ETML-ES-SLO/PRJ_1811_Ticketing-/doc/1811_C/1811C Système de ticketing pour questions d’étudiants.odp

## 1811C Système de ticketing pour questions d’étudiants

Dos Santos Mario

## Table des matières

- Cahier des charges
- Schématique
- Routage
- Firmware
- Software
- Fonctionnement final
- Conclusion
- Démonstration
- Questions

## Cahier des charges

- Reprise de projet
- Communication USB
- Application C#

## Schématique

- Reprise du schéma version A

## Schématique

- Correction

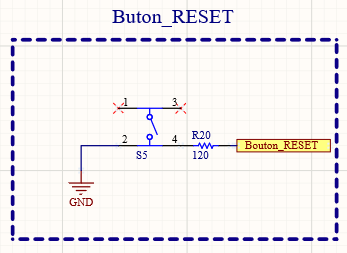
[picture p31: figure]
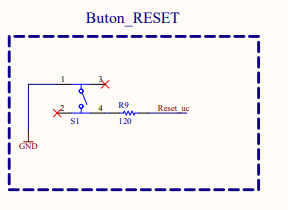
[picture p32: figure]

## Schématique

- Correction

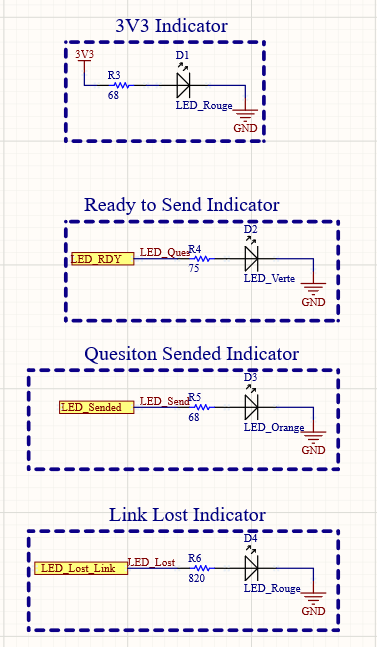
[picture p33: figure]
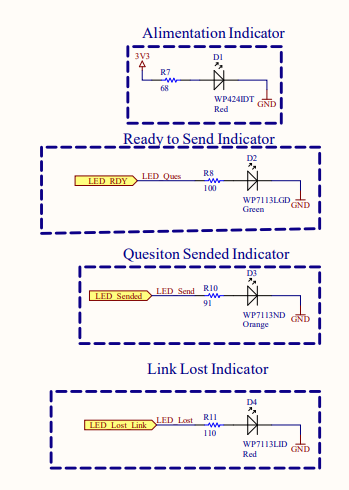
[picture p34: figure]

## Schématique

- Ajout de la communication USB
  - Projet 2126

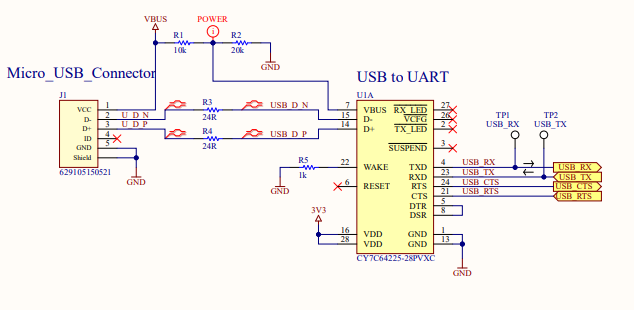
[picture p35: figure]

## Routage

- Taille de PCB
- Emplacement UI
- Plan de masse

## Firmware

- UART


UART USB Slave


UART USB Master

UART Xbee

## Firmware

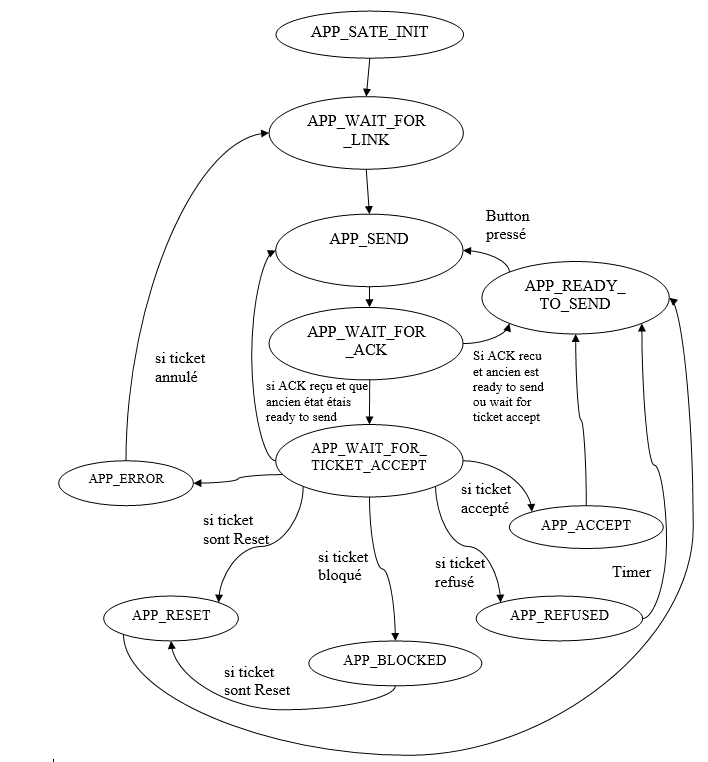
[picture p36: figure]

## Firmware


## Software


## Fonctionnement final

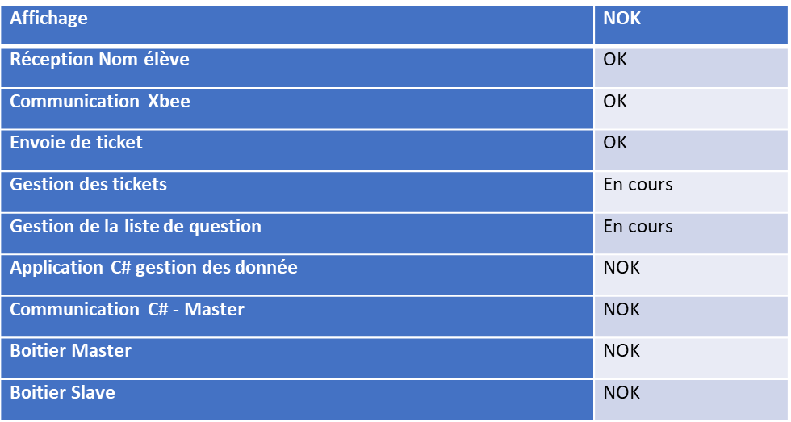
[picture p37: figure]

Affichage | NOK
Réception Nom élève | OK
Communication Xbee | OK
Envoie de ticket | OK
Gestion des tickets | En cours
Gestion de la liste de question | En cours
Application C# gestion des donnée | NOK
Communication C# - Master | NOK
Boitier Master | NOK
Boitier Slave | NOK

## Conclusion

- Hardware
- Firmware
- Software

## Démonstration

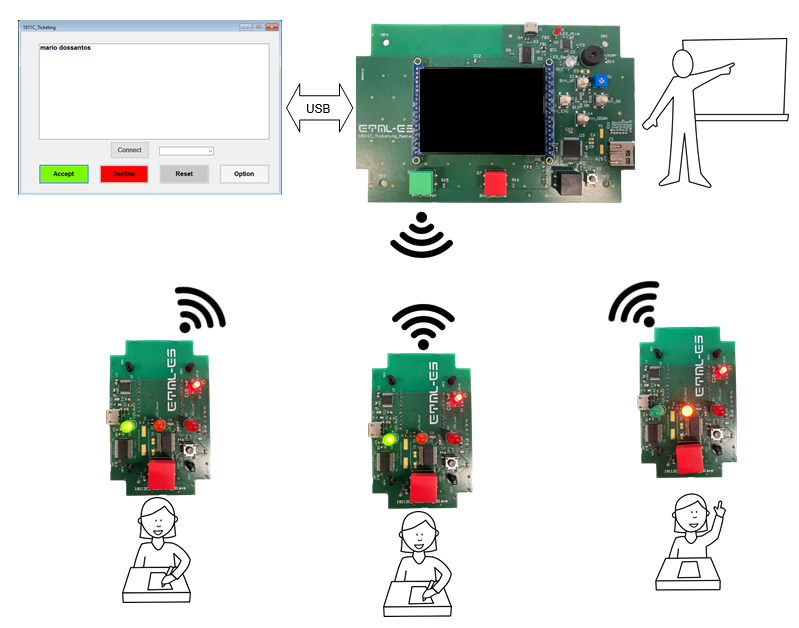
[picture p38: figure]

## Slide 16

- Questions ?
