ETML-ES-SLO/PRJ_1811_Ticketing-/doc/1811_A_B/Rapports/Rapport projet 1811.pdf

ETML | 1811 - Ticketing | Diplôme SLO
Martins David | Page 1-1

# Ticketing

# N° Projet 1811

# Réalisé par: Martins David

Martins David | Page 1-2

Table des matières :

Ticketing | 1-1
N° Projet 1811 | 1-1
Réalisé par: Martins David | 1-1
1 Cahier des charges | 1-4
1.1 Description du projet | 1-4
1.2 Cahier des charges | 1-5
2 Pré-étude | 2-6
2.1 Planning | 2-6
2.2 Schémas bloc | 2-6
2.2.1 Schéma bloc module esclave | 2-6
2.2.2 Schéma bloc module maitre | 2-7
2.2.3 Schéma bloc Module RF | 2-7
2.3 Choix des composants | 2-8
2.3.1 Module maitre | 2-8
2.3.1.1 LCD | 2-8
2.3.1.2 Interface utilisateur | 2-8
2.3.1.3 Boitier | 2-8
2.3.1.4 Microcontrôleur | 2-9
2.3.2 Module esclave | 2-9
2.3.2.1 Interface utilisateur | 2-9
2.3.2.2 Boitier | 2-9
2.3.2.3 Microcontrôleur | 2-9
3 Design | 3-10
3.1 Module maitre | 3-10
3.1.1 Microcontrôleur | 3-10
Microcontrôleur: PIC32MX170F256D | 3-10
3.1.2 TFT | 3-11
3.1.3 SD | 3-11
3.1.4 Alimentation 3.3V | 3-12
3.1.5 Interface utilisateur | 3-12
3.1.6 XBee | 3-13
3.1.7 Circuit de reset | 3-13
3.2 Module esclave | 3-14
3.2.1 Microcontrôleur | 3-14
Microcontrôleur: PIC32MX130F064 | 3-14
3.2.2 Alimentation 3.3V | 3-14
3.2.3 Interface utilisateur | 3-15
3.2.4 XBee | 3-15
3.3 Analyse du module RF | 3-16
3.3.1 Microcontrôleur | 3-16
3.3.2 nRF905 | 3-17
3.4 Boitiers | 3-18
3.4.1 Boiter Maitre | 3-18
3.4.1.1 Idée du design | 3-18
3.4.1.2 Création | 3-18
3.4.1.2.1 Top | 3-19
3.4.1.2.2 Bot | 3-20
3.4.1.2.3 Assemblage | 3-21

Martins David | Page 1-3
3.4.2 Boitier Esclave | 3-22
3.4.2.1 Idée du design | 3-22
3.4.2.1.1 Top | 3-22
3.4.2.1.2 Bot | 3-23
3.4.2.1.3 Assemblage | 3-23
3.5 PCB | 3-24
3.5.1.1 Contraintes | 3-24
3.5.1.2 Vue TOP | 3-24
3.5.1.3 Vue BOT | 3-24
3.5.1.4 Vue TOP | 3-25
3.5.1.5 Vue BOT | 3-25
3.6 Montage et Mise en Service | 3-26
4 Programme | 4-26
4.1 Programme module RF | 4-26
4.1.1 Configuration | 4-26
4.1.2 Diagramme des états | 4-28
4.1.3 Configuration du nRF904 | 4-29
4.1.4 Traitement des informations | 4-30
4.2 Programme Esclave | 4-30
4.2.1 Configuration UART | 4-30
4.2.2 Configuration Fréquence système | 4-30
4.2.3 Diagramme | 4-31
4.3 Programme Maitre | 4-32
4.3.1 Configuration SPI | 4-32
4.3.2 Configuration Carte SD | 4-32
4.3.3 UART | 4-32
4.3.4 Diagramme system task | 4-33
4.3.5 APP_TASK | 4-33
4.3.6 Gest_Menu | 4-33
4.3.7 Gest_Menu | 4-34
4.3.8 APP_SD_CARD_TASK | 4-35
4.3.9 Ecran TFT | 4-36
5 Corrections | 5-37
5.1 Module XBee | 5-37
5.2 Bouton Reset | 5-37
5.3 Alimentation de la carte SD | 5-37
6 Validation selon cahier des charges | 6-38
7 Comparaison des plannings | 7-39
8 Conclusion | 8-39

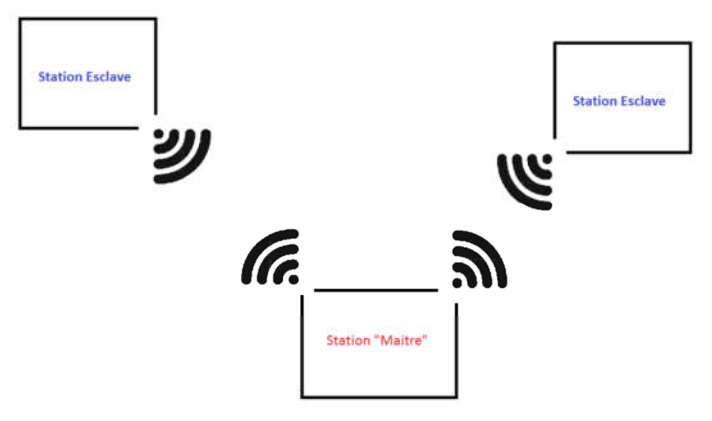
[picture p39: figure]

Martins David | Page 1-4

# 1 Cahier des charges

## 1.1 Description du projet

Ce travail de diplôme fait suite à la demande des étudiants de première année SLO (2017/2018). Avoir un système de ticketing électronique qui permettra aux enseignants de mieux gérer les demandes des étudiants lors des cours ou travaux pratiques.

Le système de ticketing sera sans-fil et pour ce faire il faudra utiliser les modules RFs développé à l'ES (Projet ES 1623). Il faudra donc fournir au minimum 2 modules esclaves (pour les élèves) et 1 module maitre (pour les enseignants).

Tâches de l'esclave:
- Envoi de ticket.
- Affichage de l'état du module (Prêt à envoyer, attente, bloqué, non connecté).
- Annulation de ticket.

Tâches du maitre:
- Récupération des infos des étudiants dans la carte SD.
- Affichage de la liste des tickets en attentes.
- Accepter un ticket, le refuser, ou tous les resets.
- Via un menu, configurer la limite de questions par élèves.

Martins David | Page 1-5

## 1.2 Cahier des charges

- Station "Maitre" comprenant:
- Un boitier
- Un afficheur LCD minimum 4 lignes 20 colonnes
- Boutons de commande (à impulsion ou rotatif) - doit permettre de sélectionner des menus ou valider des tickets
- Alimentation 5V via µ-USB.
- Emplacement pour module sans-fil -> voir projet 1623
- Prévoir une carte SD (pour pré-configuration future, par exemple appairage des stations esclaves avec la station maitre)
- Firmware du microcontrôleur principal maitre
- Appairage des différents modules esclaves
- Gestion des tickets (nombres par modules / validation des tickets)
- Remise à zéro de tous les tickets
- Station Esclave (minimum 2 à monter) comprenant:
- Un boitier
- Boutons poussoir pour l'envoi du ticket
- Système lumineux - 3 couleurs
Rouge => bloqué, pas d'envoi possible (limite atteinte) => Clignotement: pas de lien RF
Orange => envoi possible de ticket, ticket en cours. Vert => envoi possible de ticket, aucun en cours.
- Alimentation 5V via via µ-USB.
- Emplacement pour module sans-fil -> voir projet 1623
- Firmware du microcontrôleur principal esclave
- Envoi de ticket
- Gestion des signaux lumineux
- Firmware du module RF à mettre au point (HW fourni, FW existant Beugé)

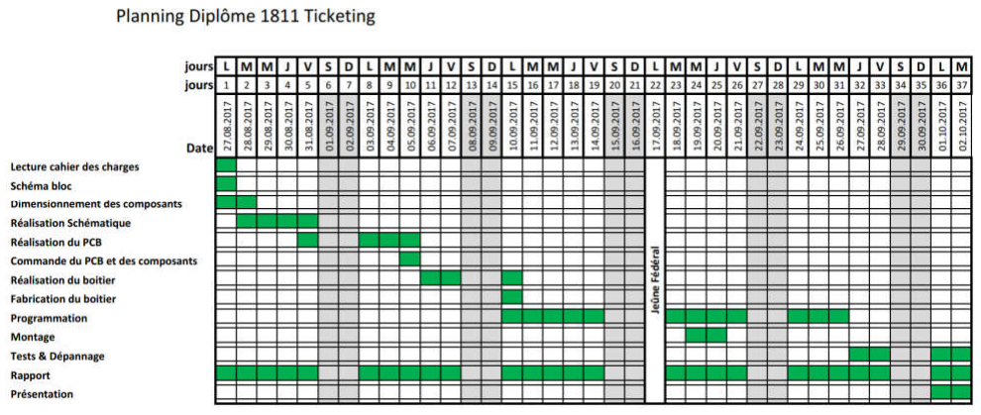
[picture p40: figure]

Martins David | Page 2-6

# 2 Pré-étude

## 2.1 Planning

Remarque: en conclusion nous retrouverons ce planning, comparé au planning réel.

## 2.2 Schémas bloc

### 2.2.1 Schéma bloc module esclave

Ici nous pouvons voir que mon module esclave va nécessiter d'utiliser uniquement 1 Bus UART. Nous avons 1 entrée sur le microcontrôleur qui sera dédié au bouton d'envoi de ticket et nous aurons 3 sorties pour les 3 LEDs d'états.

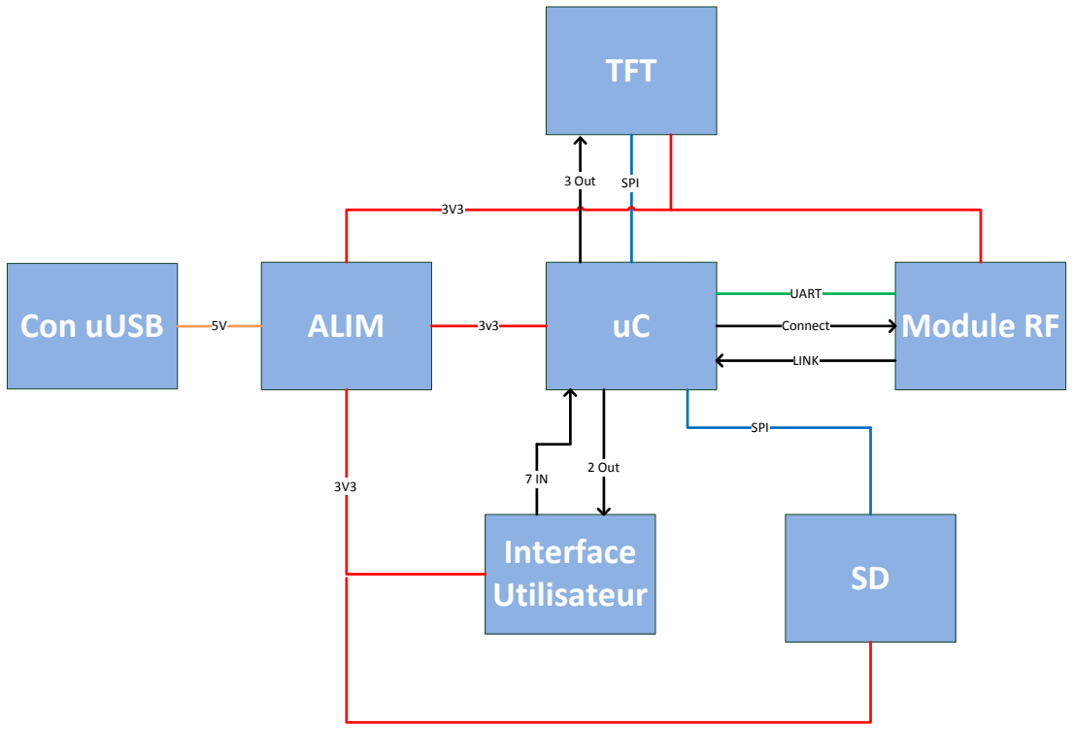
[picture p41: figure]
Con uUSB; ALIM; Module RF; TFT; Interface Utilisateur; SPI; UART; 2 Out; Connect; LINK; 3 Out

Martins David | Page 2-7

### 2.2.2 Schéma bloc module maitre

Pour le module maitre nous aurons besoin de : 2 bus SPI (SD et écran TFT)
1 bus UART
7 entrées pour les boutons de commandes
2 sorties pour le pilotage d'un buzzer et d'une LED

### 2.2.3 Schéma bloc Module RF

Remarque: je n'ai pas designé cette carte, cependant pour produire un code il faut en connaitre la construction.

Martins David | Page 2-8

Nous voyons donc que le module RF utilise un nRF905. Ce dernier est piloté via SPI et possède 3 pins de commandes ainsi que 3 pins d'indication de statuts.

Une mémoire pilotée par I2C nous permet d'y stocker l'ID du module (son adresse RF).

Le contrôle du module se fera via UART.

## 2.3 Choix des composants

### 2.3.1 Module maitre

2.3.1.1 LCD
Décision portée sur un module TFT de chez adafruit:
- Alimentation 5V ou 3V3
- Communication SPI
- Dimension de 240x340 pixels pour 2.8" de diagonale
- Utilisé dans projet de semestre

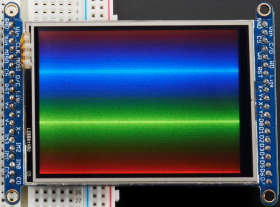
[picture p42: figure]

2.3.1.2 Interface utilisateur
Décision d'utiliser un buzzer:
- Sonne à la réception d'un nouveau ticket
- Fréquence de 440Hz
- Couplé à un trimer permettant d'en régler le volume

LED Orange:
- Boitier 5mm, pour qu'elle puisse ressortir du boitier.

Boutons:
- 3 boutons principaux colorés
- Vert ticket accepté
- Rouge ticket refusé
- Noir tous les tickets sont reset
- 4 boutons
- 4 boutons pour le control de menu

2.3.1.3 Boitier
Le boitier sera fait à l'ES grâce à l'imprimante 3D.

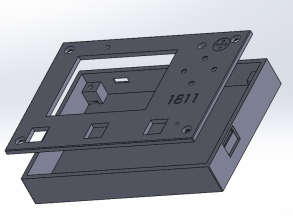
[picture p43: figure]

Martins David | Page 2-9

2.3.1.4 Microcontrôleur

Besoins:
- 2 Ports SPI (Carte SD et écran TFT)
- Port UART (Module RF)
- 15 GPIO
- Alimentation 3V3
- Mémoire minimum de 126kB

Décision portée sur le PIC32MX170F256 en boitier TQFP 44 pattes.

### 2.3.2 Module esclave

2.3.2.1 Interface utilisateur
LEDs:
- 3 Leds de couleurs différentes
- Verte, indique que le module est prêt à l'envoi d'un ticket.
- Orange, indique état d'attente de réponse.
- Rouge, ticket refusé ou module non linké.
- Boitier 5 mm pour qu'elles puissent dépasser du boitier
- Décision de prendre 3 LED pour être plus userfriendly, 3 LED alignées verte, orange et rouge expliquent instinctivement leurs utilités.

Bouton:
- Un bouton rouge pour l'envoi de ticket et l'annulation (maintient)

2.3.2.2 Boitier

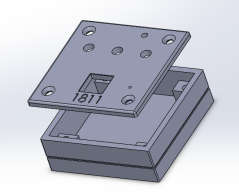
[picture p44: figure]

Le boitier sera fait à l'ES grâce à l'imprimante 3D.

2.3.2.3 Microcontrôleur

Besoins:
- Port UART (Module RF)
- 6 GPIO
- Alimentation 3V3
- Mémoire moins de 126kB

Décision portée sur le PIC32MX130F64 en boitier QFN 28 pattes.

# 3 Design

## 3.1 Module maitre

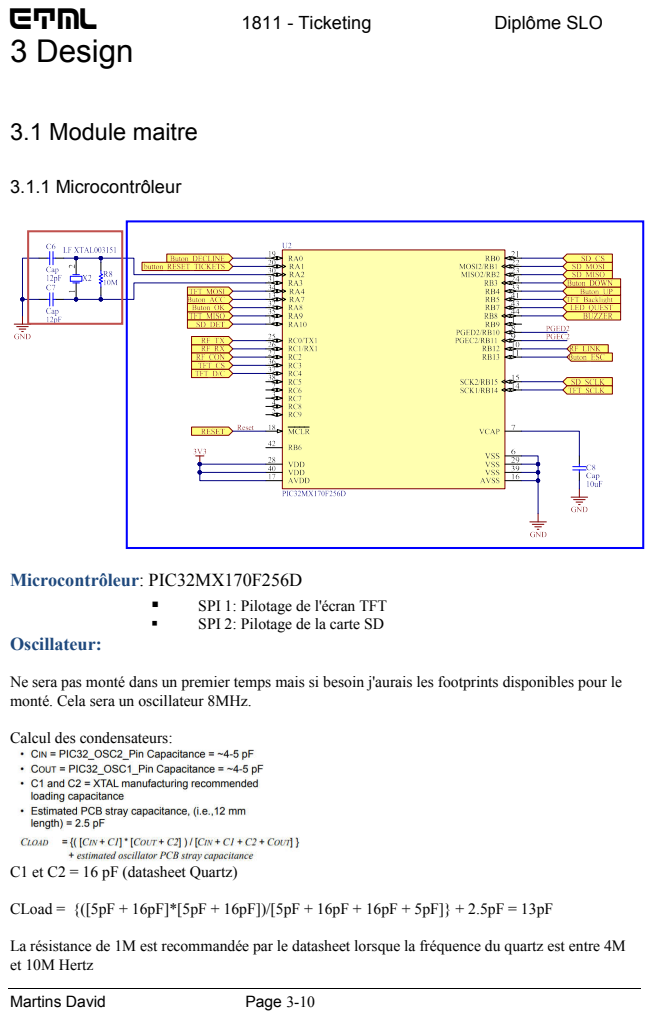
[picture p45: page 10]
Martins David; Page 3-10; 3.1.1 Microcontrôleur; Microcontrôleur: PIC32MX170F256D; Oscillateur:; CLoad = {([5pF + 16pF]*[5pF + 16pF])/[5pF + 16pF + 16pF + 5pF]} + 2.5pF = 13pF

▪ SPI 1: Pilotage de l'écran TFT
▪ SPI 2: Pilotage de la carte SD

Ne sera pas monté dans un premier temps mais si besoin j'aurais les footprints disponibles pour le
monté. Cela sera un oscillateur 8MHz.

Calcul des condensateurs:

C1 et C2 = 16 pF (datasheet Quartz)

La résistance de 1M est recommandée par le datasheet lorsque la fréquence du quartz est entre 4M
et 10M Hertz

### 3.1.2 TFT

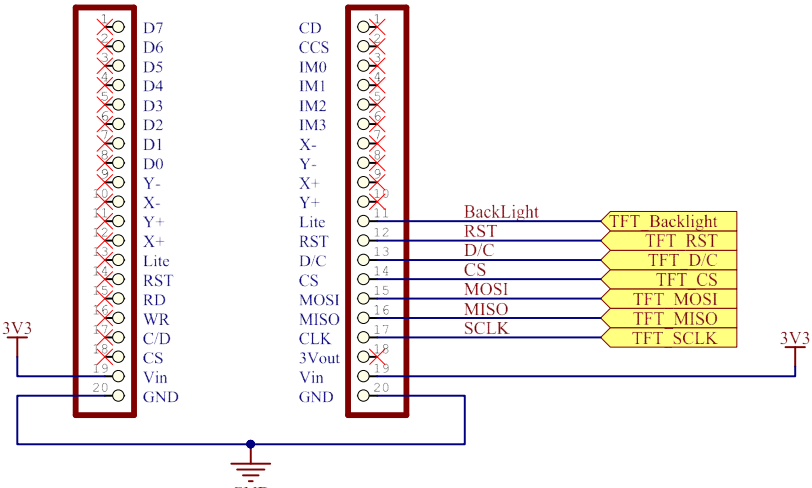
[picture p46: figure]

Ici nous avons le pinning de l'écran TFT. L'écran propose plusieurs possibilité de communication, j'utilise la communication SPI car plus simple et déjà utilisé dans un précédent projet.

"Lite" permettra l'allumage du rétro-éclairage.
"Reset" est liée au reste de la carte.
"D/C" permettra de choisir si l'on envoie des données ou des commandes.

3.1.3 SD

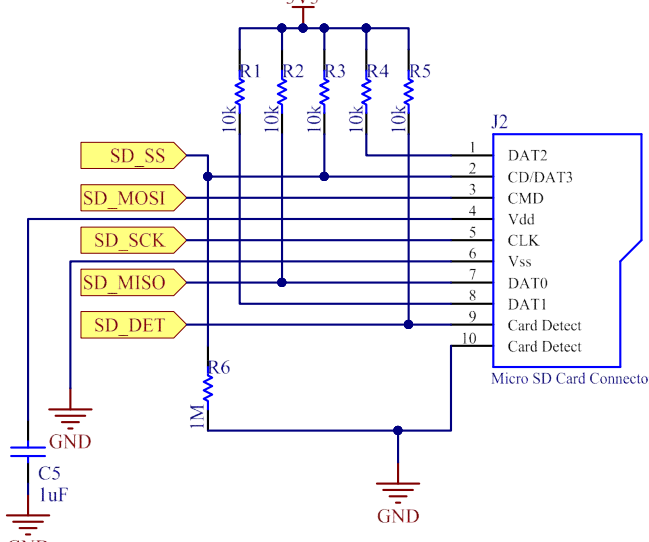
[picture p47: figure]

Ici nous avons le holder de la carte SD, le design est repris du starter-kit ES.

### 3.1.4 Alimentation 3.3V

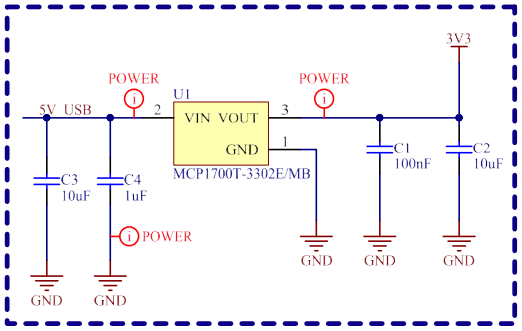
[picture p48: figure]

Pour la gestion de l'alimentation j'ai utilisé leMCP1700T-330 qui est un régulateur de tension linéaire 3V3 volts.

Ce régulateur peut me fournir un courant de 200mA maximum à 3.3V (datasheet).
Le module RF consomme moins de 50 mA (estimation tirée de la documentation du projet 1623) L'écran TFT consomme au maximum 100mA (estimation tirée de la description de l'écran sur le site adafruit)
Ce qui laisse 50mA de consommation pour mon PCB ce qui sera suffisant car mon microcontrôleur consommera 50mA au maximum.

### 3.1.5 Interface utilisateur

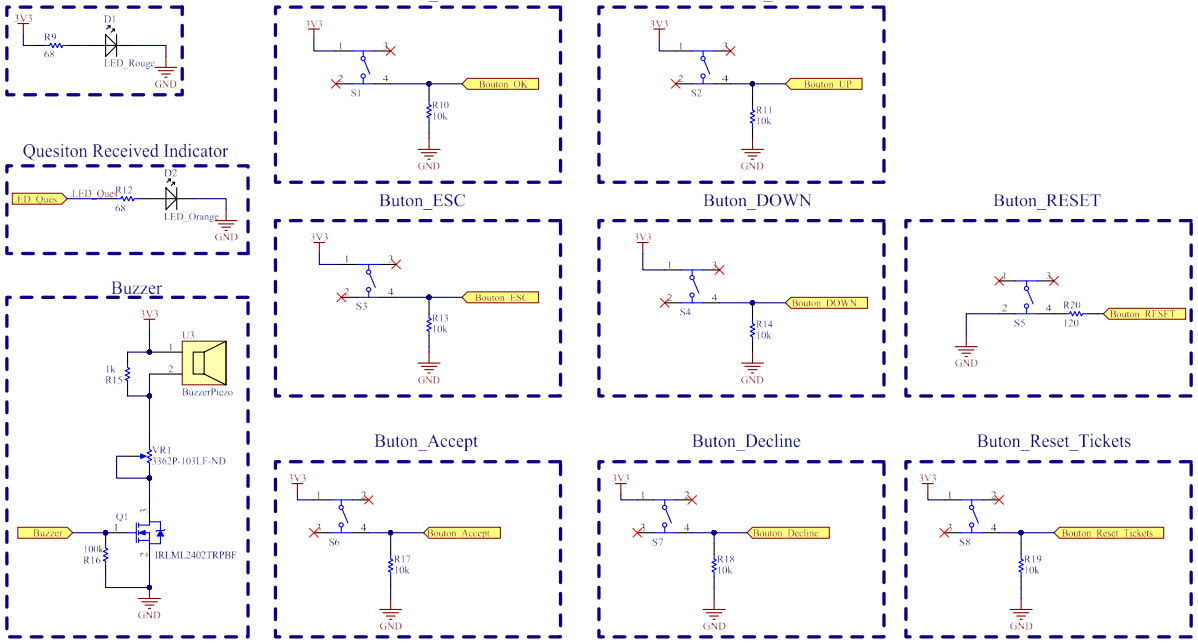
[picture p49: figure]

Led Orange = Led rouge => consommation 20mA pour tension de 2V

RLed = (Vcc - VLed) / ILed = (3.3 - 2) /20m = 65ohm -> E12 -> 68ohm

### 3.1.6 XBee

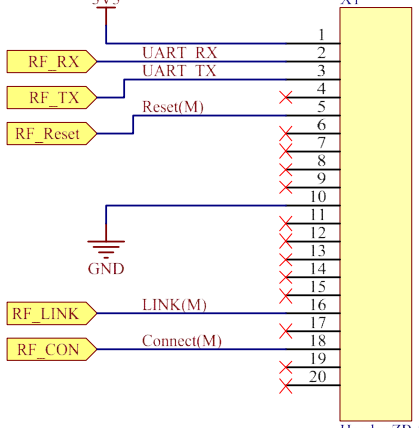
[picture p50: figure]

Ici nous avons le connecteur Xbee, 2 barrettes à broches femelle

Attention: pitch => 2mm

Sa ligne Reset est liée au reste de la carte.
Les lignes "LINK" et "Connect" sont des lignes destinées à être utilisées par de simples GPIO.

### 3.1.7 Circuit de reset

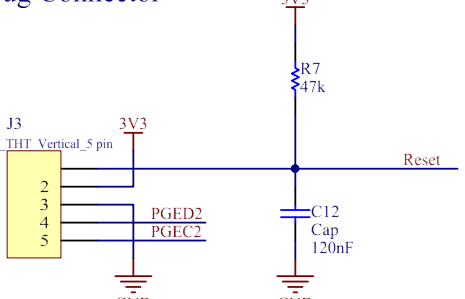
[picture p51: figure]

Ici lors de la mise sous tension le condensateur C12 permettra à la carte de se maintenir en reset pendant minimum 25ms lors de la mise sous tension.

t = R7 * C12 = 47k * 120n = 5.64ms
Pour charger le condensateur à son maximum on estime qu'il faut 5 fois ce temps. 5t = 28.2ms.

## 3.2 Module esclave

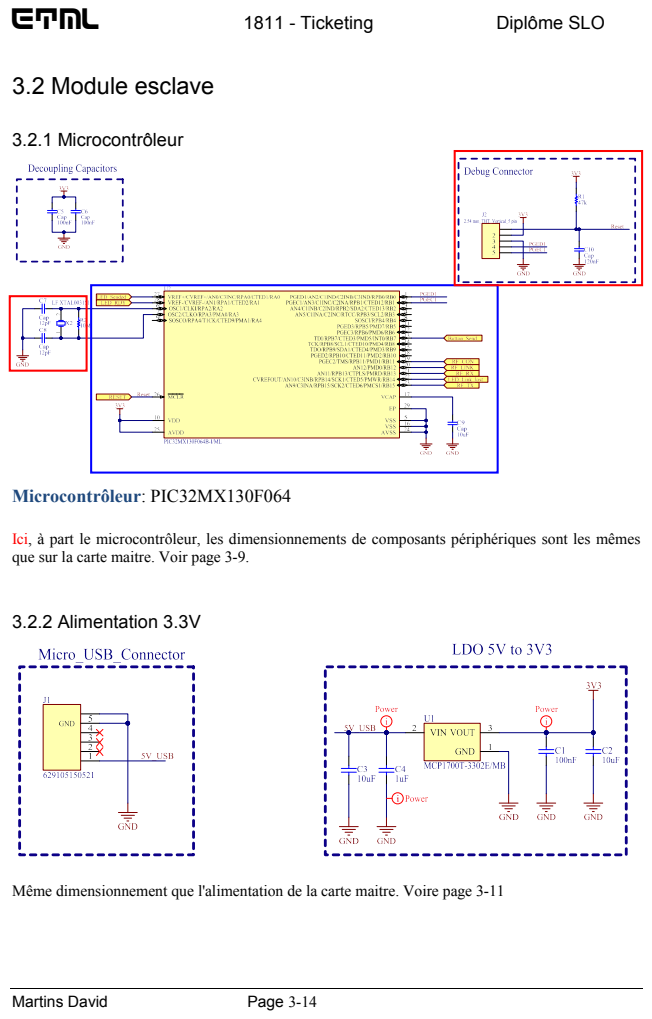
[picture p52: page 14]
3.2.1 Microcontrôleur; Microcontrôleur: PIC32MX130F064; 3.2.2 Alimentation 3.3V

Ici, à part le microcontrôleur, les dimensionnements de composants périphériques sont les mêmes
que sur la carte maitre. Voir page 3-9.

Même dimensionnement que l'alimentation de la carte maitre. Voire page 3-11

### 3.2.3 Interface utilisateur

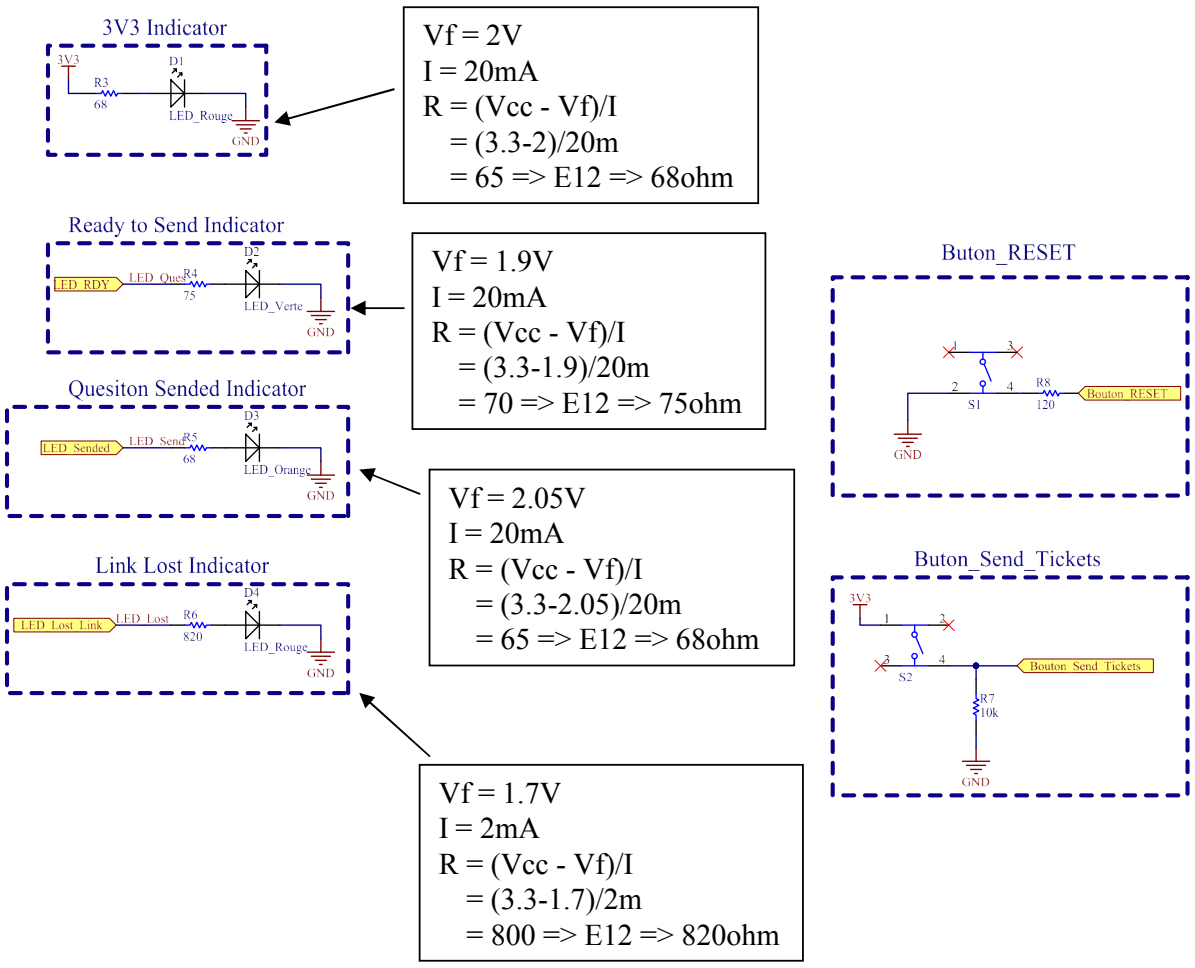
[picture p53: figure]
Vf = 2V I = 20mA R = (Vcc - Vf)/I R = (3.3-2)/20m R = 65 => E12 => 68ohm; Vf = 1.9V I = 20mA R = (Vcc - Vf)/I R = (3.3-1.9)/20m R = 70 => E12 => 75ohm; Vf = 2.05V I = 20mA R = (Vcc - Vf)/I R = (3.3-2.05)/20m R = 65 => E12 => 68ohm; Vf = 1.7V I = 2mA R = (Vcc - Vf)/I R = (3.3-1.7)/2m R = 800 => E12 => 820ohm

### 3.2.4 XBee

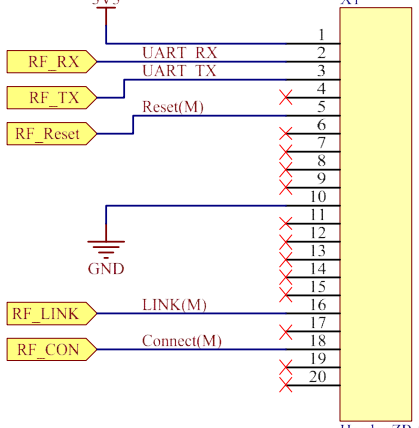
[picture p54: figure]

Même que sur la carte maitre. Voir page 3-12

## 3.3 Analyse du module RF

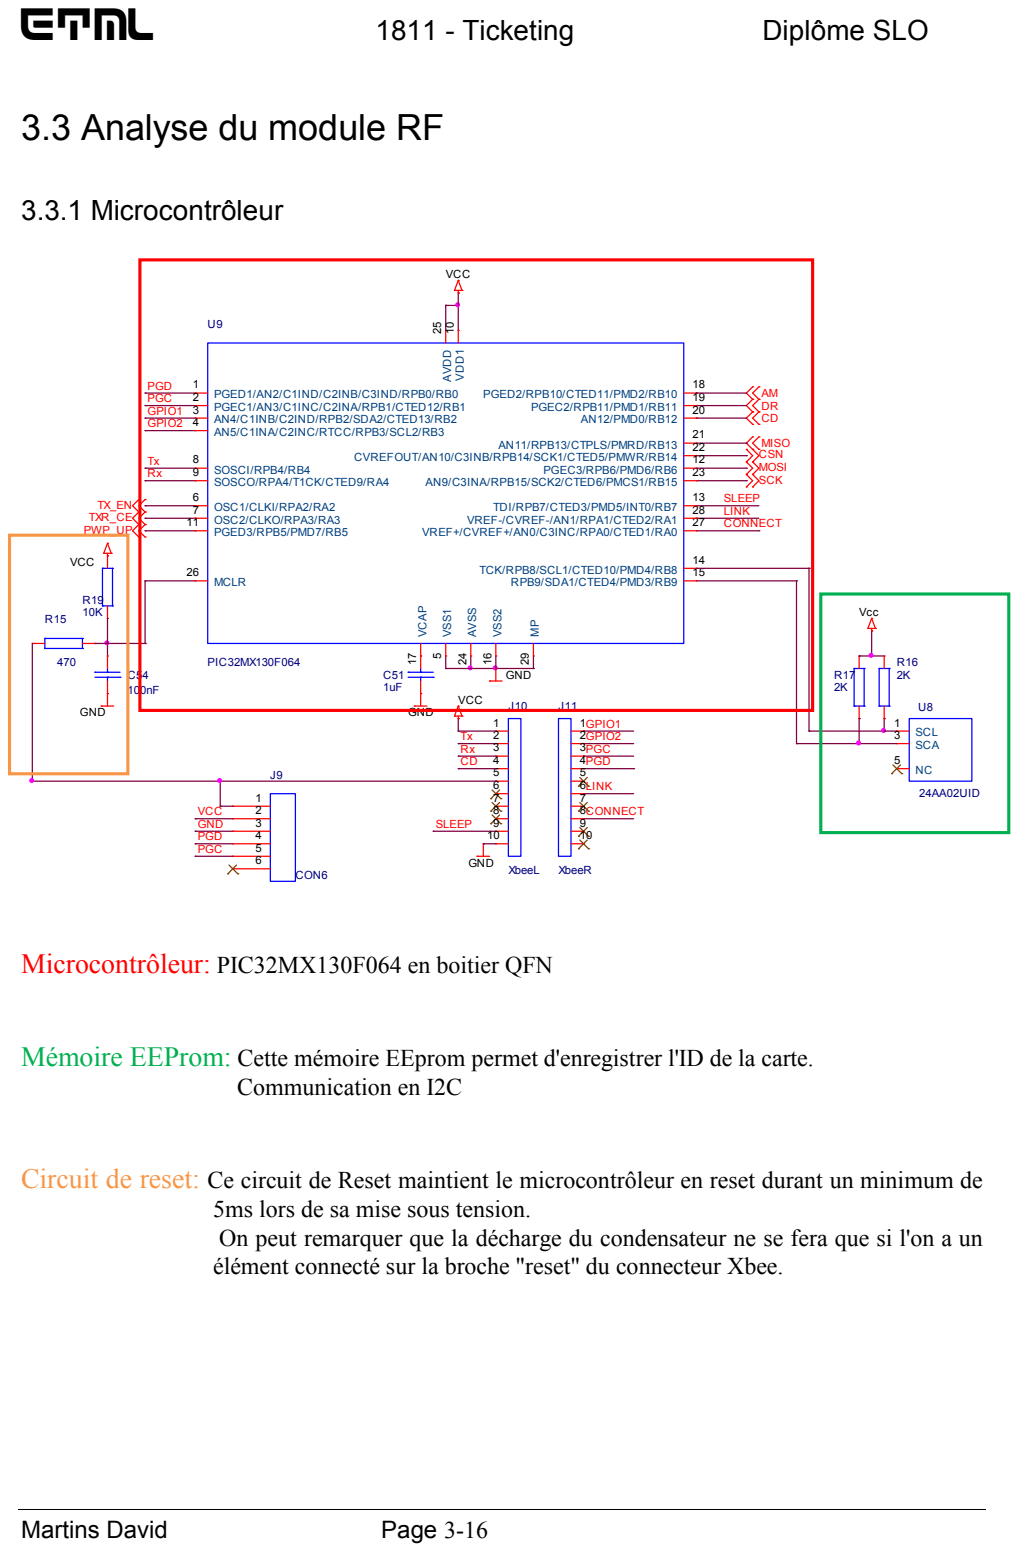
[picture p55: page 16]

Microcontrôleur: PIC32MX130F064 en boitier QFN

Mémoire EEProm: Cette mémoire EEprom permet d'enregistrer l'ID de la carte.

Circuit de reset: Ce circuit de Reset maintient le microcontrôleur en reset durant un minimum de

5ms lors de sa mise sous tension.
On peut remarquer que la décharge du condensateur ne se fera que si l'on a un
élément connecté sur la broche "reset" du connecteur Xbee.

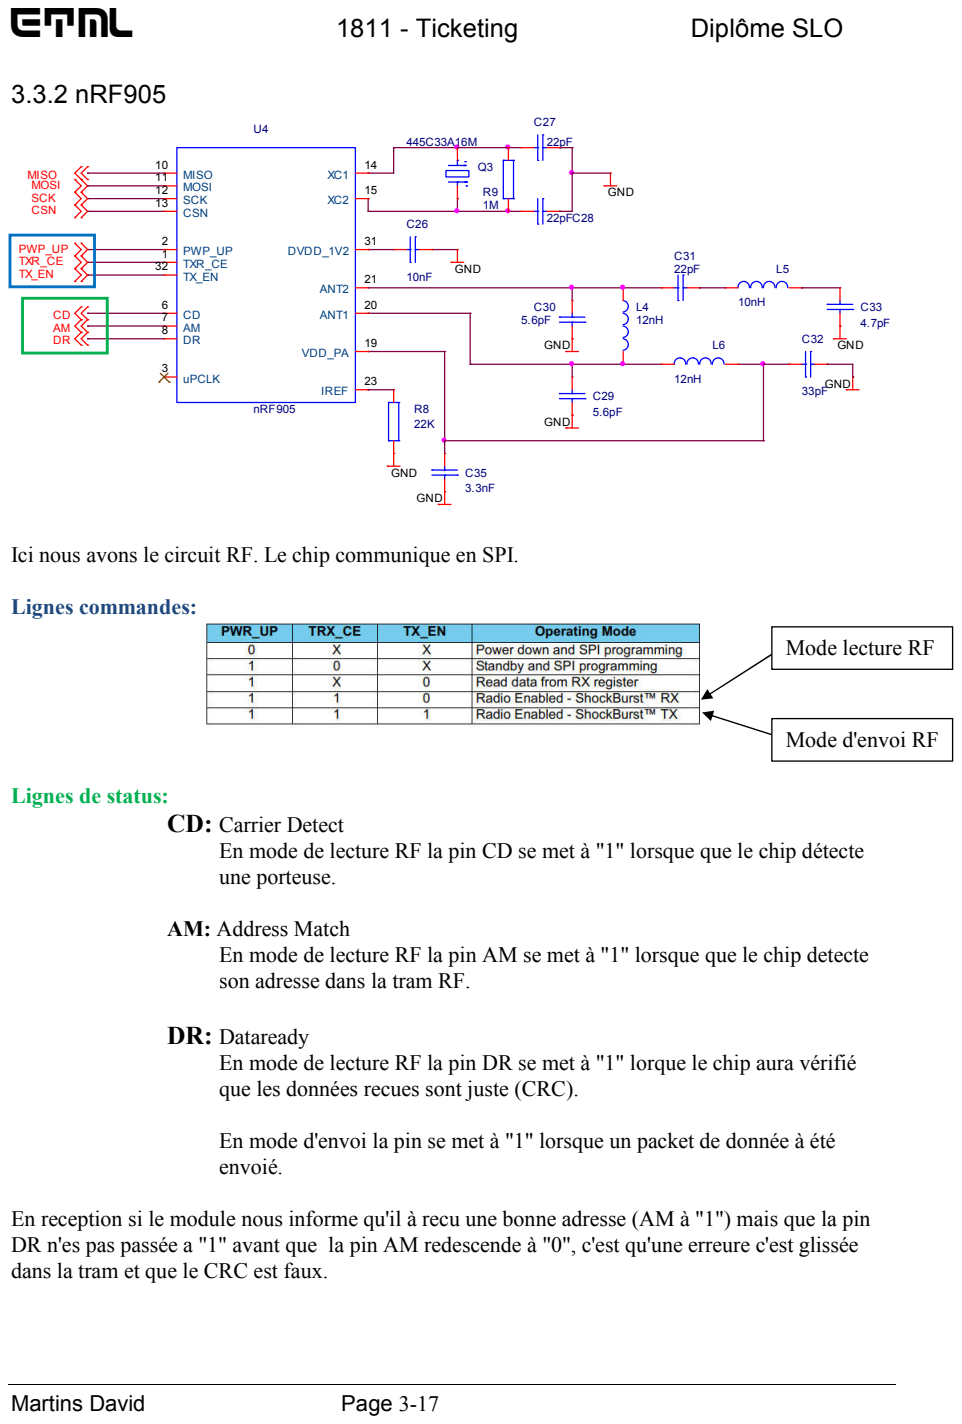
[picture p56: page 17]

Ici nous avons le circuit RF. Le chip communique en SPI.

CD: Carrier Detect
En mode de lecture RF la pin CD se met à "1" lorsque que le chip détecte
une porteuse.

AM: Address Match
En mode de lecture RF la pin AM se met à "1" lorsque que le chip detecte
son adresse dans la tram RF.

DR: Dataready
En mode de lecture RF la pin DR se met à "1" lorque le chip aura vérifié
que les données recues sont juste (CRC).

En mode d'envoi la pin se met à "1" lorsque un packet de donnée à été
envoié.

En reception si le module nous informe qu'il à recu une bonne adresse (AM à "1") mais que la pin
DR n'es pas passée a "1" avant que la pin AM redescende à "0", c'est qu'une erreure c'est glissée
dans la tram et que le CRC est faux.

## 3.4 Boitiers

Contrairement à ce qui était prévu dans le planning, j'ai préféré commencer par un design de boitier avant de créer le PCB afin d'avoir une réalisation plus esthétique, et cela me permettra d'avoir une première version de boitier à tester dès que j'aurais monté le PCB, ce qui me permettra de facilement faire des retouches et envoyer la production des boitiers finaux.

### 3.4.1 Boiter Maitre

3.4.1.1 Idée du design

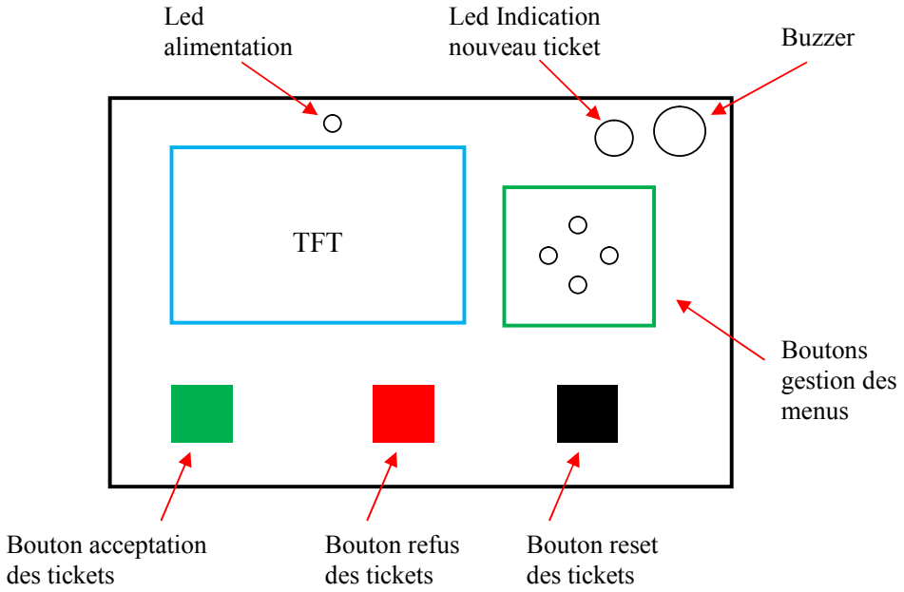
[picture p57: figure]
TFT; Led alimentation; Led Indication; nouveau ticket; Buzzer; Boutons gestion des menus; Bouton reset des tickets; Bouton refus des tickets; Bouton acceptation des tickets

3.4.1.2 Création

Concernant la création du boitier, j'ai pris contact avec M. Muller, qui s'occupe de l'impression 3D à l'ES.

Dans un premier temps il a fallu prendre en compte les éléments suivants:
- L'imprimante a une précision de 0.1 mm
- L'épaisseur des parois du boitier doit être de 3mm minimum pour garantir une certaine solidité.
- Le taraudage du boitier risque de casser le boitier donc à éviter

A propos de la visserie M. Muller m'as conseillé sur une façon simple de procéder:

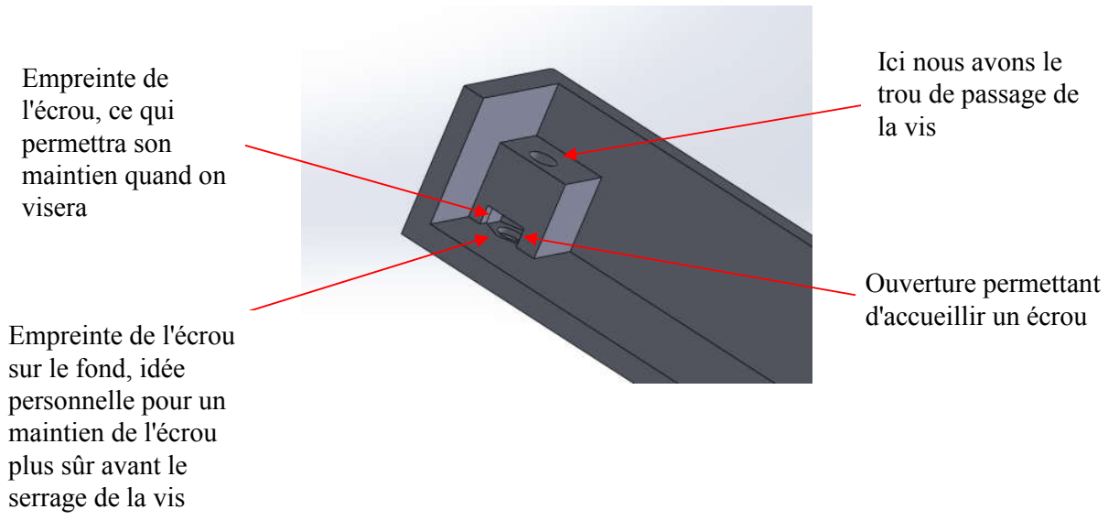
[picture p58: figure]
Ici nous avons le trou de passage de la vis; Ouverture permettant d'accueillir un écrou; Empreinte de l'écrou, ce qui permettra son maintien quand on visera; Empreinte de l'écrou sur le fond, idée personnelle pour un maintien de l'écrou plus sûr avant le serrage de la vis

3.4.1.2.1 Top
Vue du dessus

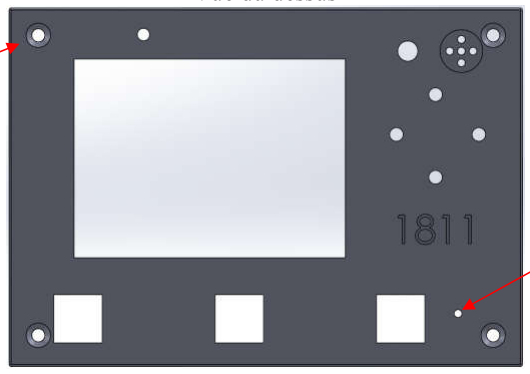
[picture p59: figure]

Trou donnant accès au
bouton de reset

Trou de fixation
pour vis M3 tête
conique

Vue du dessous

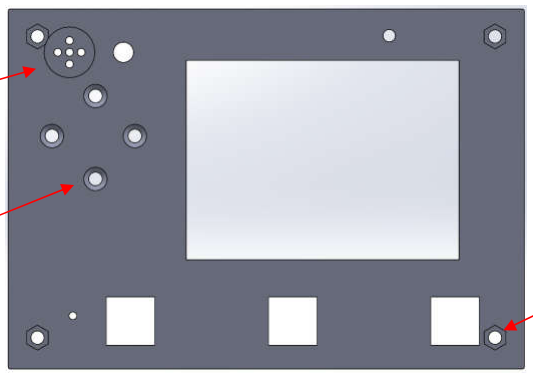
[picture p60: figure]
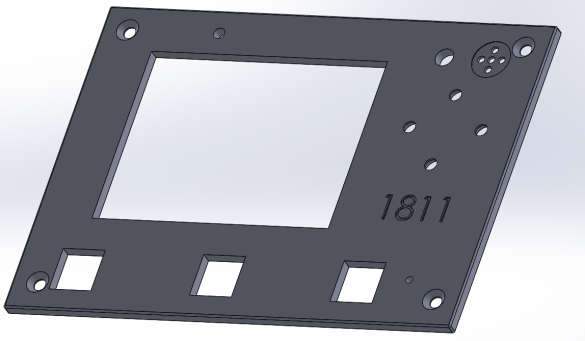
[picture p61: figure]

Vue 3D

3.4.1.2.2 Bot
Vue de derrière

Empreinte du
buzzer pour qu'il
puisse entrer dans
le boitier

Chanfrein pour les
boutons

Empreinte pour
l'entretoise

Découpe du
connecteur µ-USB
Empreinte pour la
gaine du câble USB

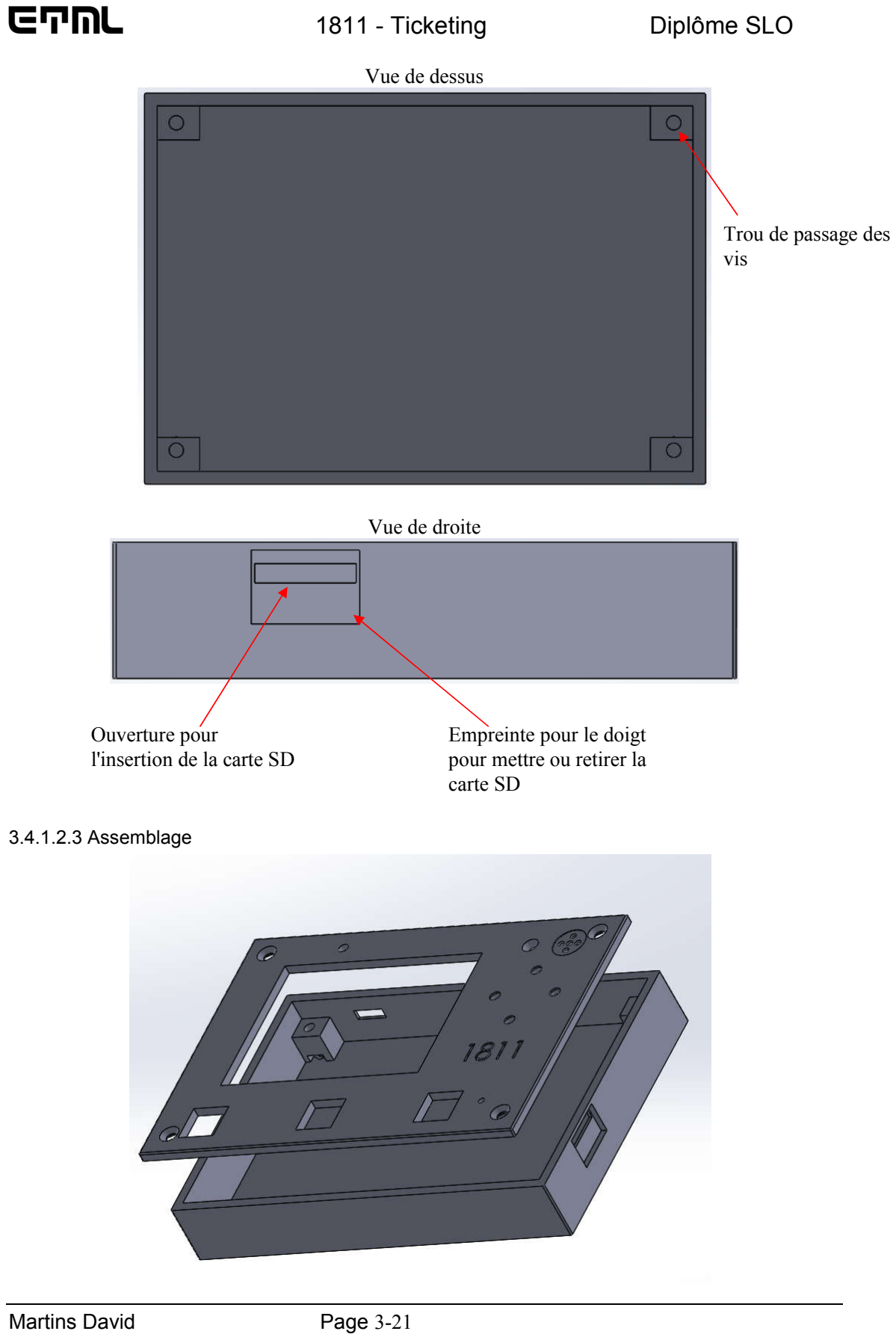
[picture p62: page 21]

Vue de dessus

Vue de droite

3.4.1.2.3 Assemblage

Trou de passage des
vis

Empreinte pour le doigt
pour mettre ou retirer la
carte SD

Ouverture pour
l'insertion de la carte SD

### 3.4.2 Boitier Esclave

3.4.2.1 Idée du design

3.4.2.1.1 Top
Vue dessus

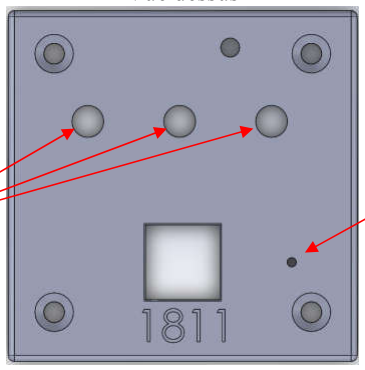
[picture p63: figure]
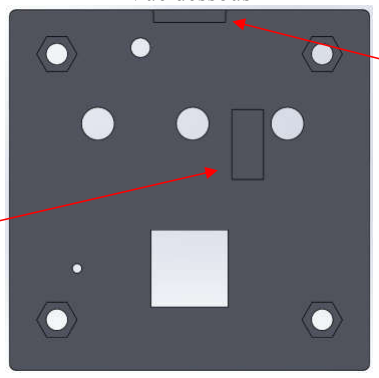
[picture p64: figure]

Vue dessous

Led
alimentation

Led Verte

Bouton envoi
ticket

Led orange

Led rouge

Trou donnant accès au
bouton de reset

Trou LEDs

Empreinte pour le
quartz

Empreinte pour la
gaine du câble USB

Vue 3D

3.4.2.1.2 Bot

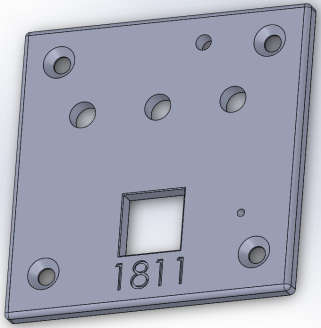
[picture p65: figure]

Vue de derrière

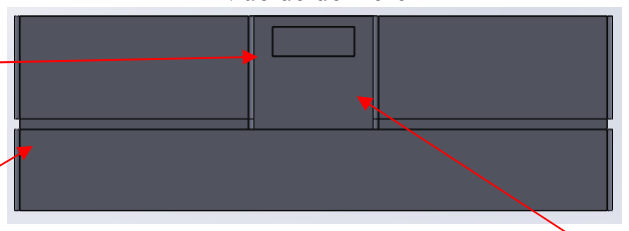
[picture p66: figure]
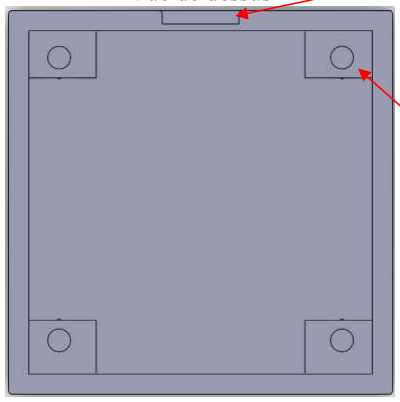
[picture p67: figure]

Vue de dessus

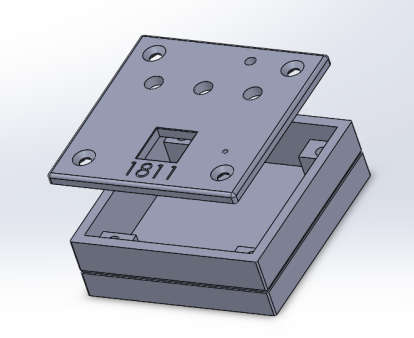
[picture p68: figure]

3.4.2.1.3 Assemblage

Empreinte pour la
gaine du câble USB

Découpe du
connecteur µ-USB

Rainure
esthétique

Trou de passage des
vis

## 3.5 PCB

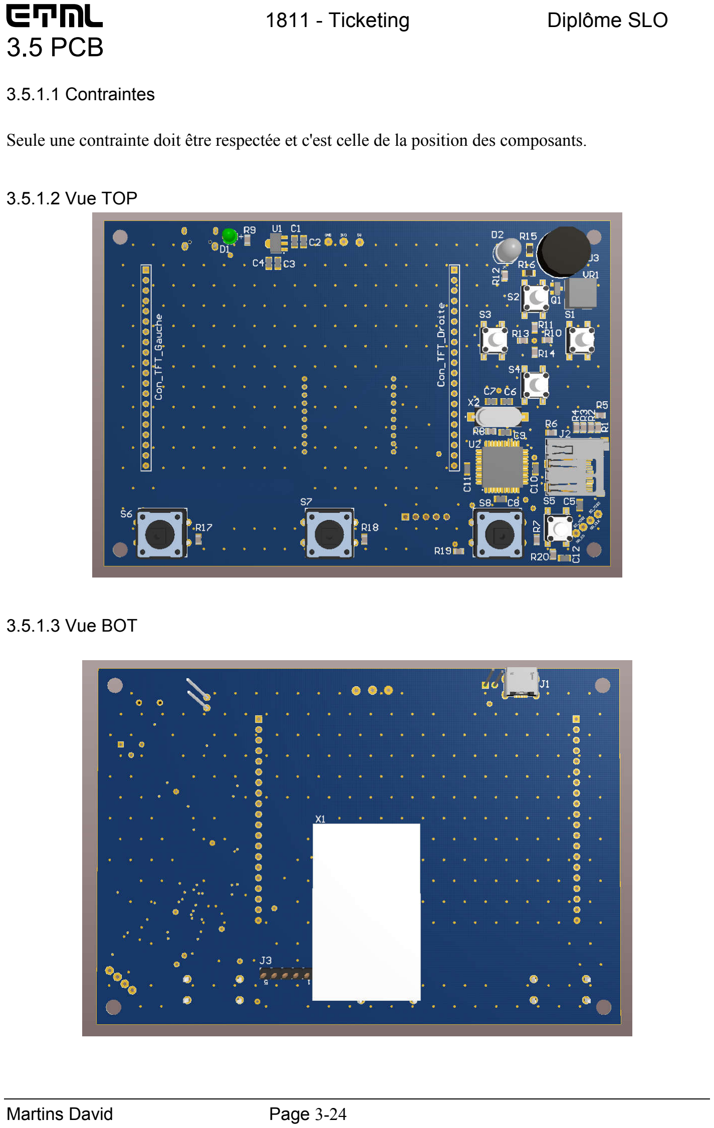
[picture p69: page 24]

3.5.1.1 Contraintes

Seule une contrainte doit être respectée et c'est celle de la position des composants.

3.5.1.2 Vue TOP

3.5.1.3 Vue BOT

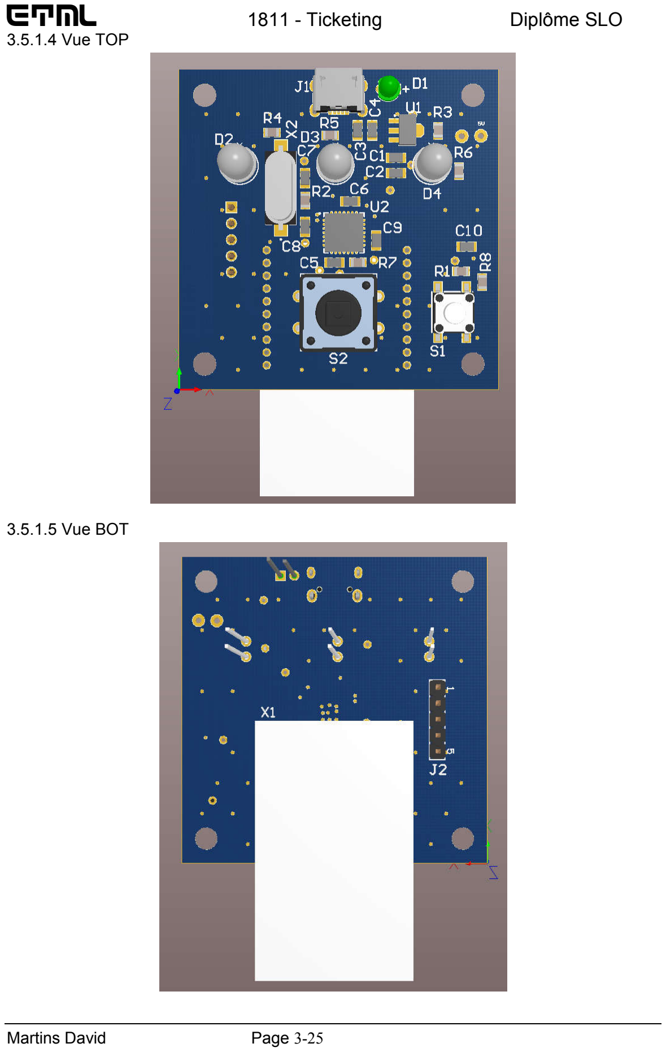
[picture p70: page 25]

3.5.1.4 Vue TOP

3.5.1.5 Vue BOT

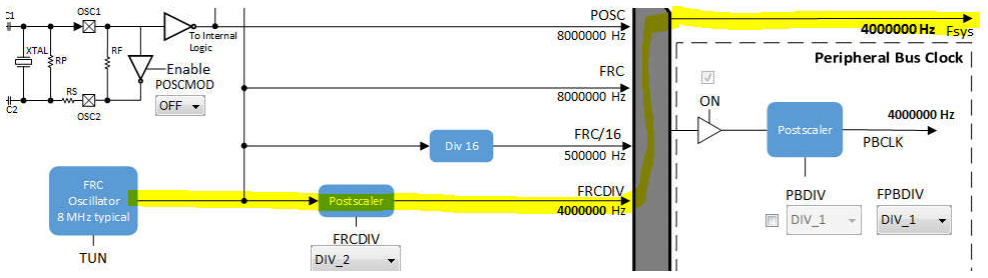
[picture p71: figure]
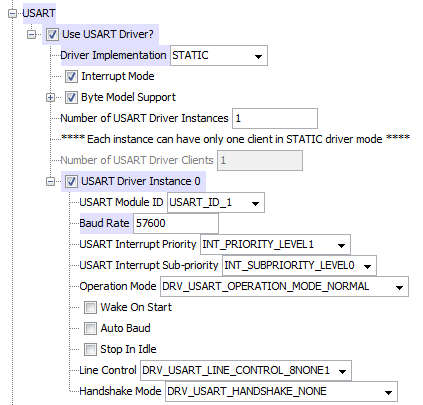
[picture p72: figure]

Martins David | Page 4-26

## 3.6 Montage et Mise en Service

Pour le montage, l'alimentation a été montée en premier lieu. Une fois montée, elle a été testée. Quand l'alimentation est OK, on monte le microcontrôleur.
Une fois monté, test de la programmation, si le microcontrôleur répond bien alors nous pouvons monter le reste de la carte.

# 4 Programme

## 4.1 Programme module RF

### 4.1.1 Configuration

La configuration du PIC est la même que sur le projet 1623.

L’horloge est réglée en mode oscillateur interne 4MHz.

UART:

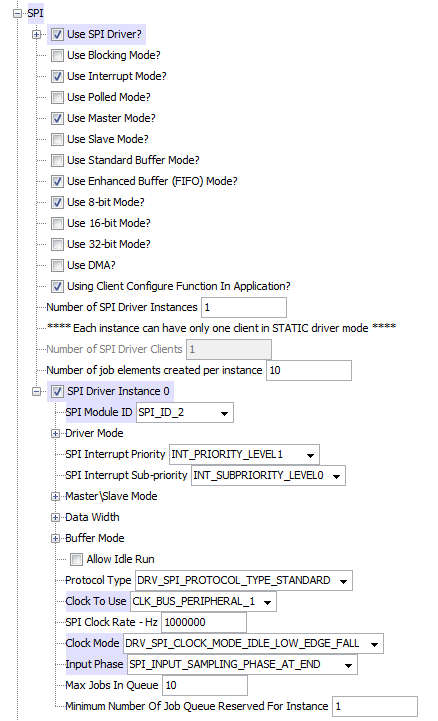
[picture p73: figure]

Martins David | Page 4-27

SPI:

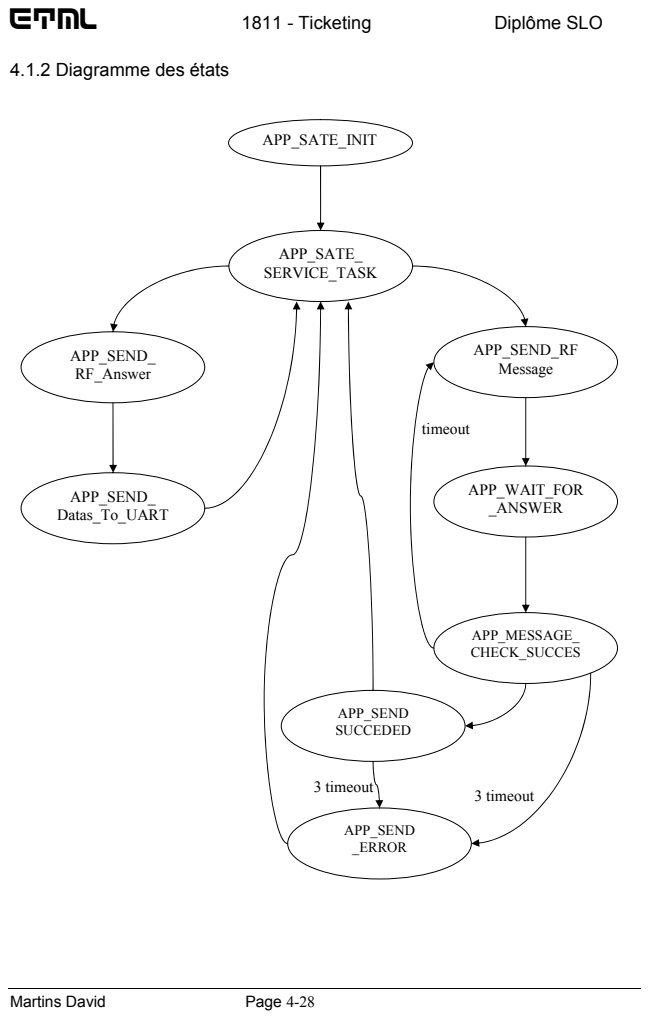
[picture p74: page 28]
Martins David; Page 4-28; APP_SATE_INIT; APP_SATE_ SERVICE_TASK; APP_SEND_ RF_Answer; APP_SEND_RF Message; APP_SEND_ Datas_To_UART; APP_WAIT_FOR _ANSWER; APP_MESSAGE_ CHECK_SUCCES; APP_SEND SUCCEDED; APP_SEND _ERROR; timeout; 3 timeout 3 timeout

4.1.2 Diagramme des états

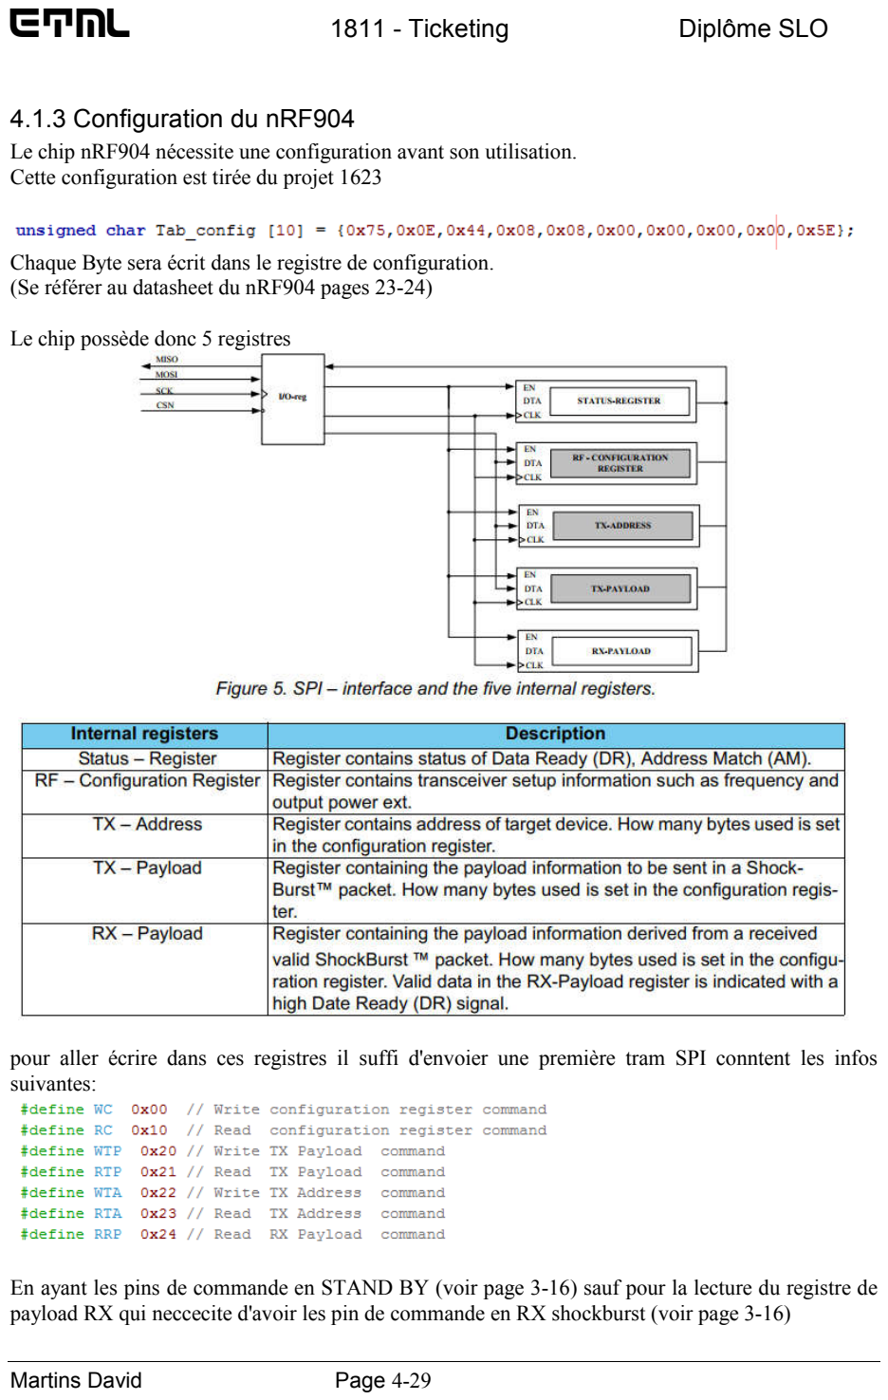
[picture p75: page 29]

Martins David | Page 4-29

### 4.1.3 Configuration du nRF904

Le chip nRF904 nécessite une configuration avant son utilisation. Cette configuration est tirée du projet 1623

Chaque Byte sera écrit dans le registre de configuration. (Se référer au datasheet du nRF904 pages 23-24)

Le chip possède donc 5 registres

pour aller écrire dans ces registres il suffi d'envoier une première tram SPI conntent les infos suivantes:

En ayant les pins de commande en STAND BY (voir page 3-16) sauf pour la lecture du registre de payload RX qui neccecite d'avoir les pin de commande en RX shockburst (voir page 3-16)

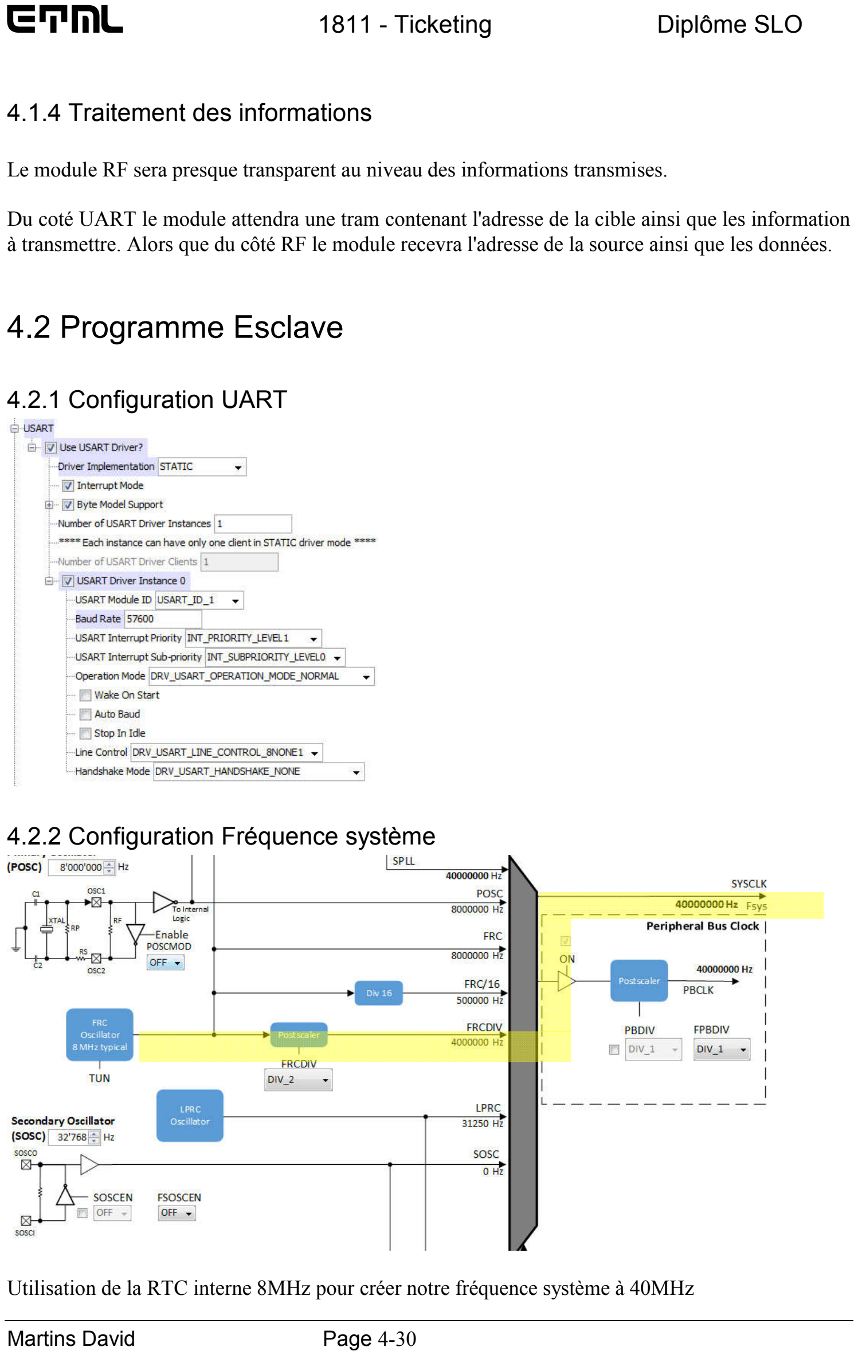
[picture p76: page 30]

Martins David | Page 4-30

### 4.1.4 Traitement des informations

Le module RF sera presque transparent au niveau des informations transmises.

Du coté UART le module attendra une tram contenant l'adresse de la cible ainsi que les information à transmettre. Alors que du côté RF le module recevra l'adresse de la source ainsi que les données.

## 4.2 Programme Esclave

### 4.2.1 Configuration UART

### 4.2.2 Configuration Fréquence système

Utilisation de la RTC interne 8MHz pour créer notre fréquence système à 40MHz

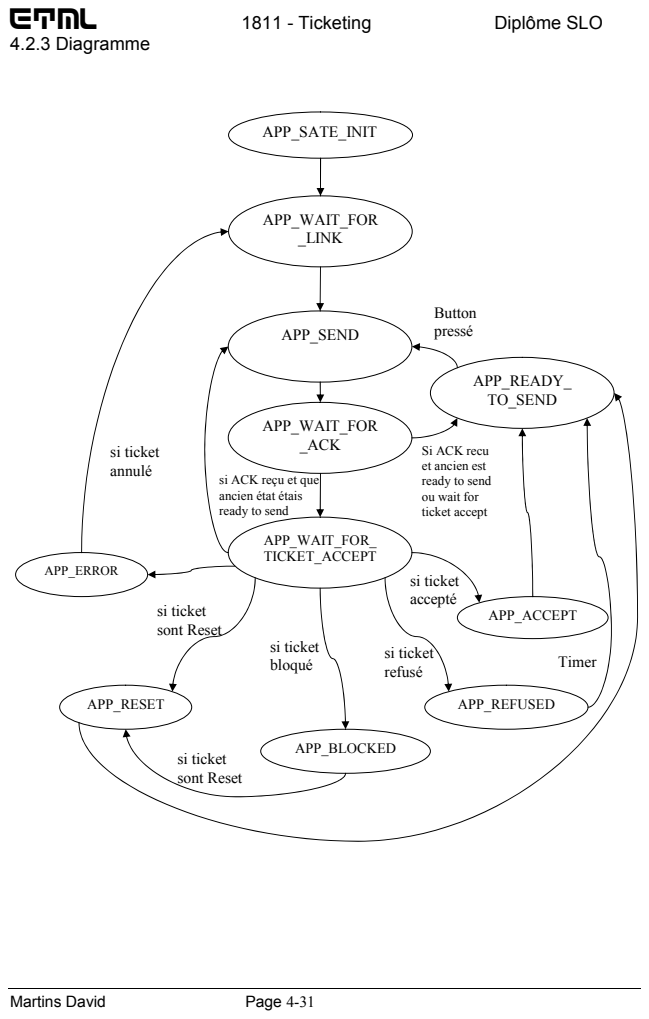
[picture p77: page 31]
Martins David; Page 4-31; 4.2.3 Diagramme; APP_SATE_INIT; APP_WAIT_FOR _LINK; APP_SEND; APP_WAIT_FOR _ACK; APP_READY_ TO_SEND; APP_WAIT_FOR_ TICKET_ACCEPT; APP_REFUSED; APP_BLOCKED; APP_ACCEPT; APP_RESET; APP_ERROR; Button pressé; si ticket annulé; si ticket sont Reset; si ticket bloqué; si ticket refusé; si ticket accepté; Timer

Si ACK recu
et ancien est
ready to send
ou wait for
ticket accept

si ACK reçu et que
ancien état étais

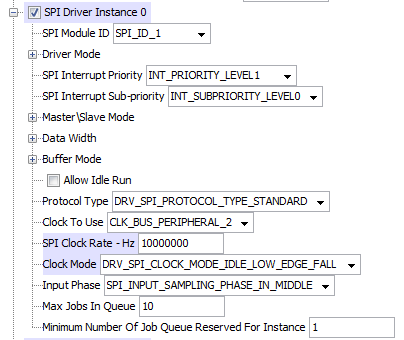
[picture p78: figure]
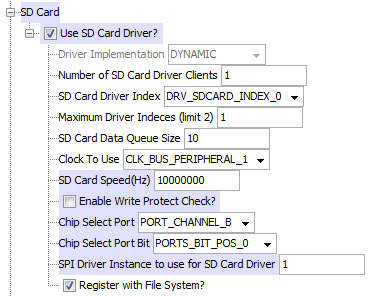
[picture p79: figure]
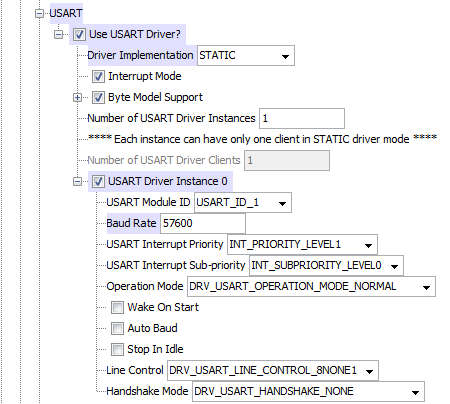
[picture p80: figure]

Martins David | Page 4-32

## 4.3 Programme Maitre

### 4.3.1 Configuration SPI

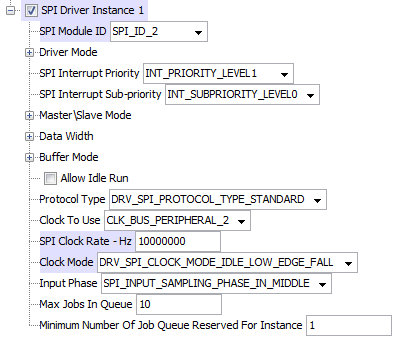
[picture p81: figure]

Configuration SPI TFT | Configuration SPI carte SD

### 4.3.2 Configuration Carte SD

### 4.3.3 UART

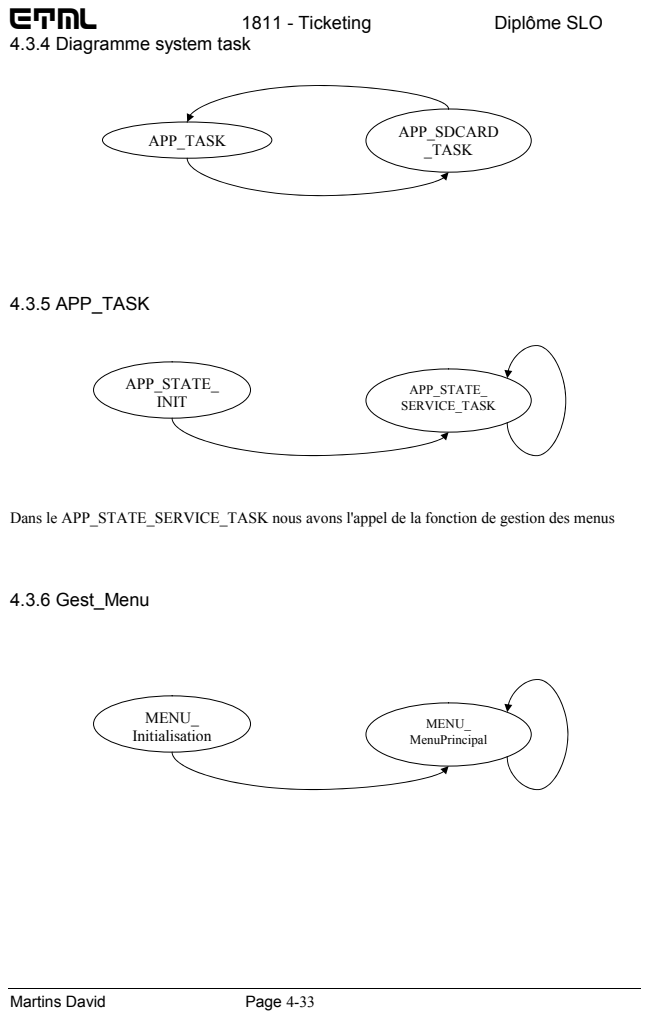
[picture p82: page 33]
Martins David; Page 4-33; 4.3.5 APP_TASK; 4.3.6 Gest_Menu; MENU_; Initialisation; MenuPrincipal; APP_STATE_ INIT; APP_STATE_ SERVICE_TASK; APP_TASK; APP_SDCARD; _TASK

4.3.4 Diagramme system task

Dans le APP_STATE_SERVICE_TASK nous avons l'appel de la fonction de gestion des menus

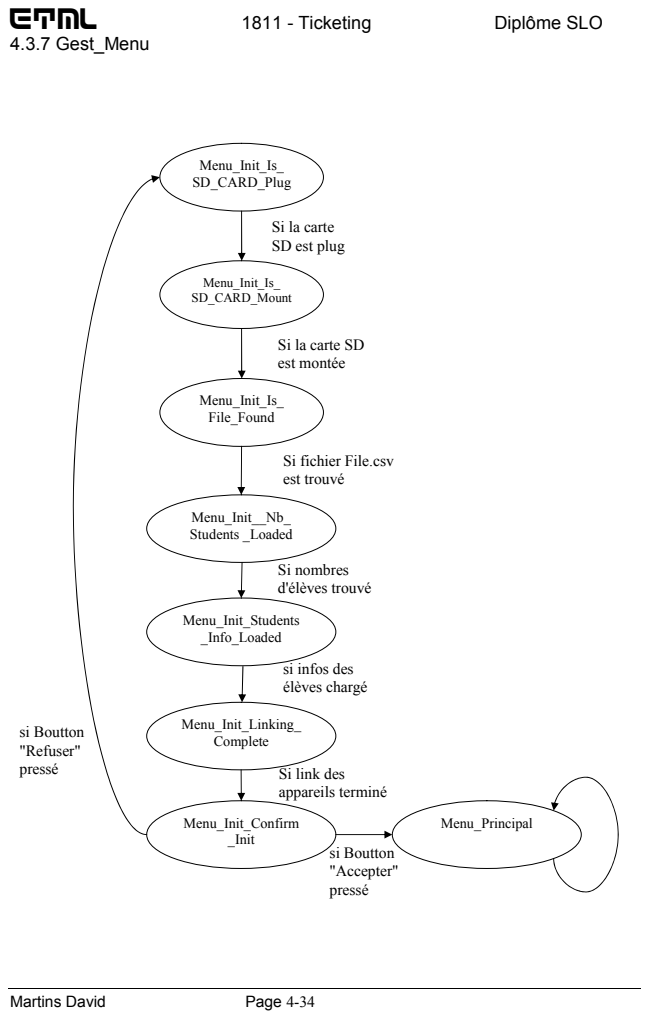
[picture p83: page 34]
Martins David; Page 4-34; 4.3.7 Gest_Menu; Menu_Init_Is_ SD_CARD_Plug; Menu_Init_Is_ SD_CARD_Mount; Menu_Init_Is_ File_Found; Menu_Init__Nb_ Students _Loaded; Menu_Init_Students _Info_Loaded; Menu_Init_Linking_ Complete; Menu_Init_Confirm _Init; Menu_Principal; Si nombres d'élèves trouvé; si Boutton "Accepter" pressé; si Boutton "Refuser" pressé

Si la carte
SD est plug

Si la carte SD
est montée

Si fichier File.csv
est trouvé

si infos des
élèves chargé

Si link des
appareils terminé

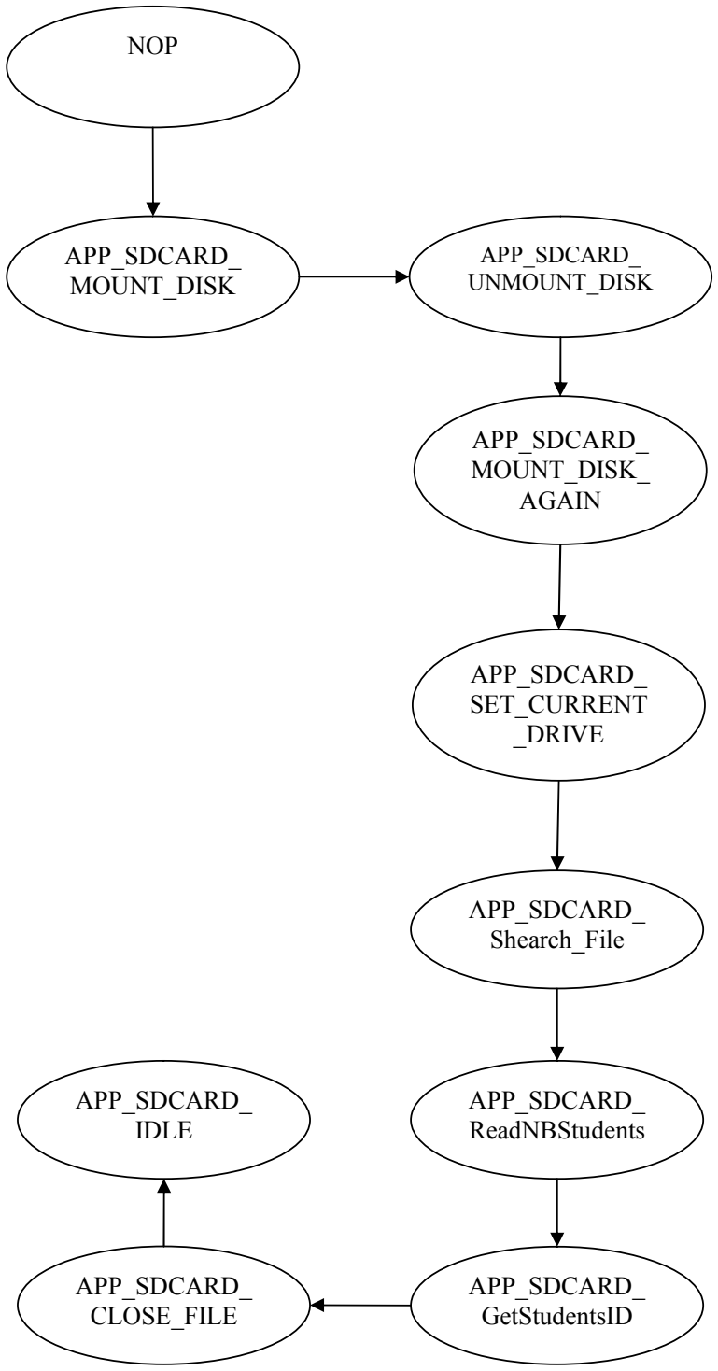
[picture p84: figure]
NOP; APP_SDCARD_ MOUNT_DISK; APP_SDCARD_ UNMOUNT_DISK; APP_SDCARD_ MOUNT_DISK_ AGAIN; APP_SDCARD_ SET_CURRENT _DRIVE; APP_SDCARD_ Shearch_File; APP_SDCARD_ ReadNBStudents; APP_SDCARD_ GetStudentsID; APP_SDCARD_ IDLE; APP_SDCARD_ CLOSE_FILE

Martins David | Page 4-35

### 4.3.8 APP_SD_CARD_TASK

Dès que la carte SD est retirée, l'état sera forcément le NOP

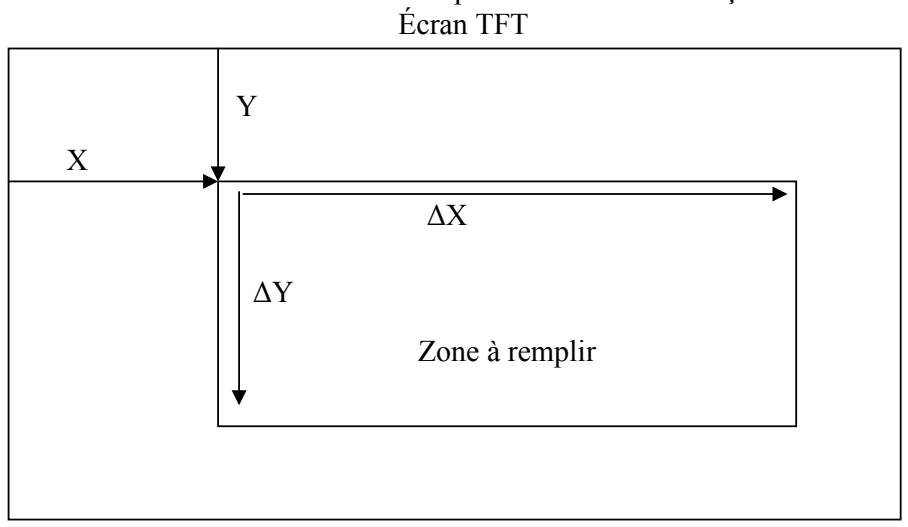
[picture p85: figure]
Écran TFT; Zone à remplir

Martins David | Page 4-36

### 4.3.9 Ecran TFT

Important: dans la configuration harmony, le bus SPI doit tourner à 10Mhz et doit être en configuration DRV_SPI_CLOCK_MODE_IDLE_LOW_EDGE_FALL.

L'écran fait 320 pixels de large sur 240 de haut.

Pour initialiser l'écran il faut appeler la fonction "tft_begin" qui va faire une grosse initialisation de l'écran.

Suite à cela les fonctions qui ont été les plus utilisées sont les suivantes:

tft_fillRect(X,Y,ΔX, ΔY,Couleur)
Cette fonction remplis une zone définie d'une certaine couleur.

Le X,Y, ΔX et ΔY servent à définir la zone à remplir de couleur de la façon suivante:

tft_setTextSize (taille)
Défini la taille du texte qu'on va écrire

tft_setCursor(X,Y)
Défini la position du curseur

tft_setTextColor(Couleur)
Défini la couleur du texte

tft_drawFastHLine(X,Y,ΔX,Couleur);
Dessine une ligne horizontale de 1 pixel de largeur

tft_drawFastHLine(X,Y,ΔY,Couleur);
Dessine une ligne verticale de 1 pixel de largeur

tft_writeString(message);
Écrit sur l'écran le message

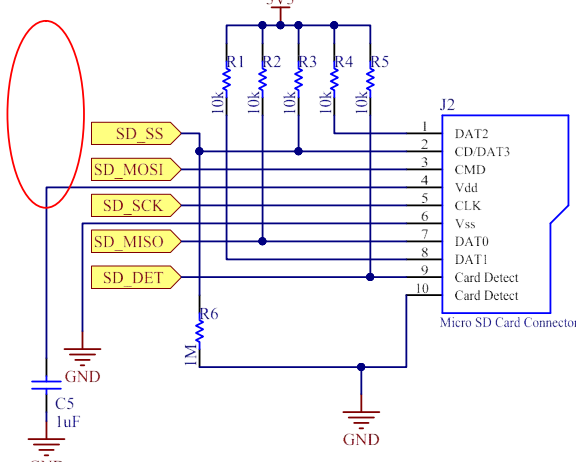
[picture p86: figure]

Martins David | Page 5-37

# 5 Corrections

## 5.1 Module XBee

Footprint à l'envers.

## 5.2 Bouton Reset

Lors de la programmation j'ai pu me rendre compte que lorsque j'uploadais mon programme en release, le programme ne se lançait pas.
Après un certain temps de recherche, j'ai constaté que j'ai mis la ligne de reset sur la mauvaise patte du bouton, ce qui fait que la ligne de reset était toujours à l'état bas.

## 5.3 Alimentation de la carte SD

J'ai oublié un symbole d'alimentation pour la carte SD

Martins David | Page 6-38

# 6 Validation selon cahier des charges

- Station "Maitre" comprenant:
- Un boitier
- Un afficheur LCD minimum 4 lignes 20 colonnes
- Boutons de commande (à impulsion ou rotatif) - doit permettre de sélectionner des menus ou valider des tickets
- Alimentation 5V via µ-USB.
- Emplacement pour module sans-fil -> voir projet 1623
- Prévoir une carte SD (pour pré-configuration future, par exemple appairage des stations esclaves avec la station maitre)
- Firmware du microcontrôleur principal maitre
- Appairage des différents modules esclaves
- Gestion des tickets (nombres par modules / validation des tickets)
- Remise à zéro de tous les tickets
- Station Esclave (minimum 2 à monter) comprenant:
- Un boitier
- Boutons poussoir pour l'envoi du ticket
- Système lumineux - 3 couleurs
Rouge => bloqué, pas d'envoi possible (limite atteinte) => Clignotement: pas de lien RF
Orange => envoi possible de ticket, ticket en cours. Vert => envoi possible de ticket, aucun en cours.
- Alimentation 5V via via µ-USB.
- Emplacement pour module sans-fil -> voir projet 1623
- Firmware du microcontrôleur principal esclave
- Envoi de ticket
- Gestion des signaux lumineux
- Firmware du module RF à mettre au point (HW fourni, FW existant Beugé)

Le module RF est beugé sans comprendre pourquoi, car avant son implémentation sur mes cartes les modules communiquaient bien.

La communication entre le module maitre et le module esclave fonctionne si l'on modifie légèrement le code(car le module RF n'est pas 100% transparent)

Avec le retard dû aux problèmes liés au module RF j'e n'ai pas eu le temps de finir d'implémenter le mode de configuration, mais il sera fonctionnel pour la présentation

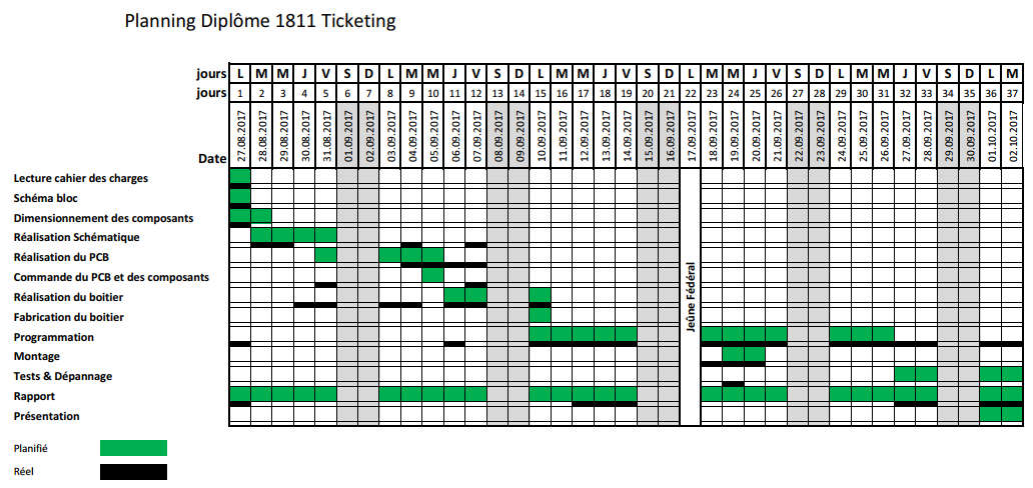
[picture p87: figure]

Martins David | Page 8-39

# 7 Comparaison des plannings

J'ai donc volontairement commencé par le boitier avant le PCB ce qui m'as permis de déjà faire le placement des composants principeaux avant le routage du PCB.

La programmation m'as pris beacoup plus de temps que prévu, car le module RF du XBee n'ont plus pu communiquer depuis leur implémentation à mes cartes.

# 8 Conclusion

Ce travail de diplôme était intéressant, c'était la première fois pour moi que je réalisais une communication sans-fil. Le fonctionnement du projet n'est pas total à cause, principalement, d'une mauvaise gestion du temps, je persistais à essayer de résoudre les problèmes modules RF alors que je n'avais pas fini de réaliser le code du module maitre et esclave.

J'ai apprécié faire un projet qui soit le plus user-friendly possible.

Lausanne, le 02.10.35 | Martins David

Martins David | Page 8-40

# A. Journal de travail

# B. Cahier des charges

# C. Listing Code Esclave

# D. Listing Code Maitre

# E. Listing Code Module RF

# F. Procès-Verbaux

# G. Mode d'emploi

# H. Plannings

# J. Documents de fabrication

# K. Datasheet nRF904
