ETML-ES-SLO/PRJ_1811_Ticketing-/doc/1811_C/PDF/Nouveau dossier/1811C_Ticketing_Planning.pdf

ETML | Planification 1811B_Ticketing_Planning | Approfondissement TCOM

1811B_Ticketing_Planning

Exemple
3 jours | R | Remise de mémoire

2,5 jours

Date | 22.08.2022 | 23.08.2022 | 24.08.2022 | 25.08.2022 | 26.08.2022
No | Libellé | Durée | Lu | Ma | Me | Je | Ve
m | a | m | a | m | a | m | a | m | a
1 | Cahier des charges | 1 1
2 | Design + Schéma | 4 2,5
3 | Design PCB | 4 3,5
4 | Montage PCB | 3 1
5 | Softwares | 8 13,5
6 | Mécanique | 3 0,5
7 | Rédaction du rapport | 5
8 | Affiche + résumé | 1
5,3 | Design PCB
No semaine | 34 | 34 | 34 | 34 | 34
K:\ES\PROJETS\SLO\1811_Ticketing\doc\1811C\1811C_Ticketing_Planning.xlsx | Page 1/6

ETML | Planification 1811B_Ticketing_Planning | Approfondissement TCOM

1811B_Ticketing_Planning

Exemple

3 jours

2,5 jours

5,3 Design PCB

No semaine

R | Remise de mémoire
35 | 35 | 35 | 35 | 35
Date | 29.08.2022 | 30.08.2022 | 31.08.2022 | 01.09.2022 | 02.09.2022
No | Libellé | Durée | Lu | Ma | Me | Je | Ve
m | a | m | a | m | a | m | a | m | a
1 | Cahier des charges | 1 1
2 | Design + Schéma | 4 2,5
3 | Design PCB | 4 3,5
4 | Montage PCB | 3 1
5 | Softwares | 8 13,5
6 | Mécanique | 3 0,5
7 | Rédaction du rapport | 5
8 | Affiche + résumé | 1
K:\ES\PROJETS\SLO\1811_Ticketing\doc\1811C\1811C_Ticketing_Planning.xlsx | Page 2/6

ETML | Planification 1811B_Ticketing_Planning | Approfondissement TCOM

1811B_Ticketing_Planning

Exemple

3 jours

2,5 jours

5,3 Design PCB

No semaine

R | Remise de mémoire
36 | 36 | 36 | 36 | 36
Date | 05.09.2022 | 06.09.2022 | 07.09.2022 | 08.09.2022 | 09.09.2022
No | Libellé | Durée | Lu | Ma | Me | Je | Ve
m | a | m | a | m | a | m | a | m | a
1 | Cahier des charges | 1 1
2 | Design + Schéma | 4 2,5
3 | Design PCB | 4 3,5
4 | Montage PCB | 3 1
5 | Softwares | 8 13,5
6 | Mécanique | 3 0,5
7 | Rédaction du rapport | 5
8 | Affiche + résumé | 1
K:\ES\PROJETS\SLO\1811_Ticketing\doc\1811C\1811C_Ticketing_Planning.xlsx | Page 3/6

ETML | Planification 1811B_Ticketing_Planning | Approfondissement TCOM

1811B_Ticketing_Planning

Exemple

3 jours

2,5 jours

5,3 Design PCB

No semaine

R | Remise de mémoire
37 | 37 | 37 | 37 | 37
Date | 12.09.2022 | 13.09.2022 | 14.09.2022 | 15.09.2022 | 16.09.2022
No | Libellé | Durée | Lu | Ma | Me | Je | Ve
m | a | m | a | m | a | m | a | m | a
1 | Cahier des charges | 1 1
2 | Design + Schéma | 4 2,5
3 | Design PCB | 4 3,5
4 | Montage PCB | 3 1
5 | Softwares | 8 13,5
6 | Mécanique | 3 0,5
7 | Rédaction du rapport | 5
8 | Affiche + résumé | 1
K:\ES\PROJETS\SLO\1811_Ticketing\doc\1811C\1811C_Ticketing_Planning.xlsx | Page 4/6

ETML | Planification 1811B_Ticketing_Planning | Approfondissement TCOM

1811B_Ticketing_Planning

Exemple

3 jours

2,5 jours

5,3 Design PCB

No semaine

R | Remise de mémoire
38 | 38 | 38 | 38 | 38
Date | 19.09.2022 | 20.09.2022 | 21.09.2022 | 22.09.2022 | 23.09.2022
No | Libellé | Durée | Lu | Ma | Me | Je | Ve
m | a | m | a | m | a | m | a | m | a
1 | Cahier des charges | 1 1
2 | Design + Schéma | 4 2,5
3 | Design PCB | 4 3,5
4 | Montage PCB | 3 1
5 | Softwares | 8 13,5
6 | Mécanique | 3 0,5
7 | Rédaction du rapport | 5
8 | Affiche + résumé | 1
K:\ES\PROJETS\SLO\1811_Ticketing\doc\1811C\1811C_Ticketing_Planning.xlsx | Page 5/6

ETML | Planification 1811B_Ticketing_Planning | Approfondissement TCOM

1811B_Ticketing_Planning

Exemple

3 jours

2,5 jours

5,3 Design PCB

No semaine

R | Remise de mémoire
39 | 39 | 39
Date | 26.09.2022 | 27.09.2022 | 28.09.2022
No | Libellé | Durée | Lu | Ma | Me
m | a | m | a | m | a
1 | Cahier des charges | 1 1
2 | Design + Schéma | 4 2,5
3 | Design PCB | 4 3,5
4 | Montage PCB | 3 1
5 | Softwares | 8 13,5
6 | Mécanique | 3 0,5
7 | Rédaction du rapport | 5 | | | R
8 | Affiche + résumé | 1
K:\ES\PROJETS\SLO\1811_Ticketing\doc\1811C\1811C_Ticketing_Planning.xlsx | Page 6/6
