ETML-ES-SLO/PRJ_1811_Ticketing-/doc/1811_C/PDF/Nouveau dossier/Composants_matériel supplémentaire.pdf

Composants_matériel supplémentaire 1811C Ticketing

Description | Quantity | Supplier | Supplier Part Number | Supplier unit price
Price
Xbee | 3 | ETML | 1623 | 0 | 0,00
Xbee | 3 | Digi-key | 602-1892-ND | 30,84 | 92,52
Ecran TFT | 1 | Digi-key | 1528-2848-ND | 38,35 | 38,35
Capuchon vert | 1 | Digi-key | 714308050-ND | 0,29 | 0,29
Capuchon Noir | 1 | Digi-key | 714301050-ND | 0,24 | 0,24
Capuchon rouge | 3 | Digi-key | 714306050-ND | 0,24 | 0,72
Pin socket 1x10 | 6 | Digi-key | 732-62001011821-ND | 1,17 | 7,02
pin header 1x5 | 3 | Digi-key | 732-5317-ND | 0,18 | 0,54
PCB Master | 1 | Eurocircuit | 18111C | 68,08 | 68,08
PCB Slave* | 1 | Eurocircuit | 18112C | 67,89 | 67,89
| | | | Total: | 183,13

Composants/matériel supplémentaire

* Les 2 PCB sont commander en même temps pour que sa soit moins cher Choisir l'un des 2
