ETML-ES-SLO/PRJ_1811_Ticketing-/doc/1811_C/Rapport/1811C_Ticketing_Planning.xlsx

 | 1811B_Ticketing_Planning
No semaine |  |  | 34 |  | 34 |  | 34 |  | 34 |  | 34 |  | 35 |  | 35 |  | 35 |  | 35 |  | 35 |  | 36 |  | 36 |  | 36 |  | 36 |  | 36 |  | 37 |  | 37 |  | 37 |  | 37 |  | 37
Date |  |  | 2022-08-22 |  | 2022-08-23 |  | 2022-08-24 |  | 2022-08-25 |  | 2022-08-26 |  | 2022-08-29 |  | 2022-08-30 |  | 2022-08-31 |  | 2022-09-01 |  | 2022-09-02 |  | 2022-09-05 |  | 2022-09-06 |  | 2022-09-07 |  | 2022-09-08 |  | 2022-09-09 |  | 2022-09-12 |  | 2022-09-13 |  | 2022-09-14 |  | 2022-09-15 |  | 2022-09-16
 |  |  | Lu |  | Ma |  | Me |  | Je |  | Ve |  | Lu |  | Ma |  | Me |  | Je |  | Ve |  | Lu |  | Ma |  | Me |  | Je |  | Ve |  | Lu |  | Ma |  | Me |  | Je |  | Ve
No | Libellé | Durée | m | a | m | a | m | a | m | a | m | a | m | a | m | a | m | a | m | a | m | a | m | a | m | a | m | a | m | a | m | a | m | a | m | a | m | a | m | a | m | a
1 | Cahier des charges | 1
 |  | 1
2 | Design + Schéma | 4
 |  | 2.5
3 | Design PCB | 4
 |  | 3.5
4 | Montage PCB | 3
 |  | 1
5 | Softwares | 8
 |  | 13.5
6 | Mécanique | 3
 |  | 0.5
7 | Rédaction du rapport
 |  | 5
8 | Affiche + résumé | 1
Exemple
5.3 | Design PCB | 3 jours |  |  |  |  | R | Remise de mémoire |  |  |  |  | R | Remise de mémoire |  |  |  |  |  |  |  |  | R | Remise de mémoire |  |  |  |  |  |  |  |  | R | Remise de mémoire
 |  | 2,5 jours
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
