ETML-ES-SLO/PRJ_1811_Ticketing-/doc/1811_C/Rapport/résumé_SLO_Dossantos.docx

RESUMÉ - Diplome Dos Santos Mario

Titre :

1811C_Système de ticketing pour questions d’étudiants

Contexte et objectifs :

Reprise du projet 1811C_Ticketing. Ce projet consiste à crée, grâce à deux cartes différentes, soit de faire des demandes de question soit de les réceptionner et de les gérer.

- Modifier/finaliser le travail déjà existant
- Ajout de la réception su nom de l’élève à partir de l’application Windows du projet 1623_AffichageMatriciel
- Ajout d’une application permettant d’interagir en temps réel avec le montage.

Résultats obtenus et conclusion :

Ce projet avait l’air assez simple sur le papier mais certain problème firmware et la reprise d’un projet existant mon rapidement fait penser le contraire.

La partie hardware c’est bien dérouler et j’ai pu commencer la programmation C# et les dessins mécanique en attentant la livraison de mes cartes.

La partie firmware était beaucoup plus compliqué car j’ai dû pas mal modifier le code à cause de la carte SD et de l’écran TFT qui ne fonctionnait pas comme je le souhaitait.

Ce n’est pas la première fois que je reprends un projet pour le continuer/corriger mais à chaque fois je me rends compte se serait plus simple de commencer depuis le début. Dans mon cas la partie hardware était assez facile.

La version A n’avait pas beaucoup de problèmes, même si j’en ai trouvé certain qui n’était indiqué nulle part. La partie firmware était beaucoup plus compliqué car le code n’était pas commenté et que certaine partie du code, qui était écrit dans le rapport comme fait, ne l’était pas.

J’ai beaucoup appris de ce projet je suis un peu déçu du résultat actuel mais je vais continuer à avancer dessus jusqu’aux présentation. J’ai pu constater le résultat que peut avoir un rapport auxquelles ils manquent des informations important surtout au niveau des composants et de même pour un code qui manquent de commentaire.

Maître(s) de projet : M.Moreno

Entreprise mandataire : ETML-ES

Ecole supérieure, école des métiers Lausanne Rue de Sébeillon 12 CH-1004 Lausanne www.etml-es.ch | 1 / 1 |
