ETML-ES-SLO/PRJ_1811_Ticketing-/doc/1811_A_B/Affiche_ET_Resume/Affiche DIPLOME 1811.pdf

## Prénom Nom

TECHNICIEN-NE ES EN GÉNIE ÉLECTRIQUE / 2018

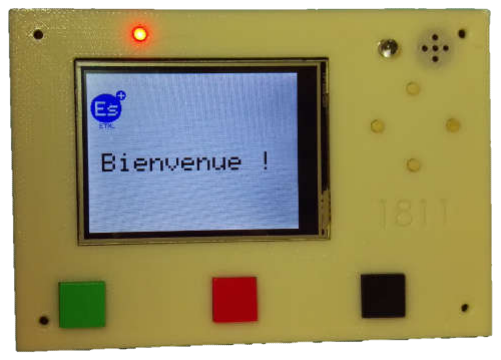
[picture p94: figure]
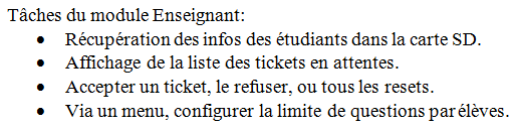
[picture p95: figure]

# www.etml-es.ch

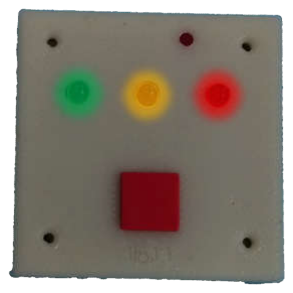
[picture p96: figure]
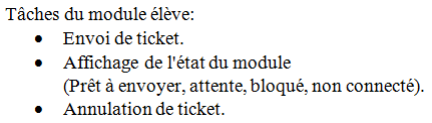
[picture p97: figure]
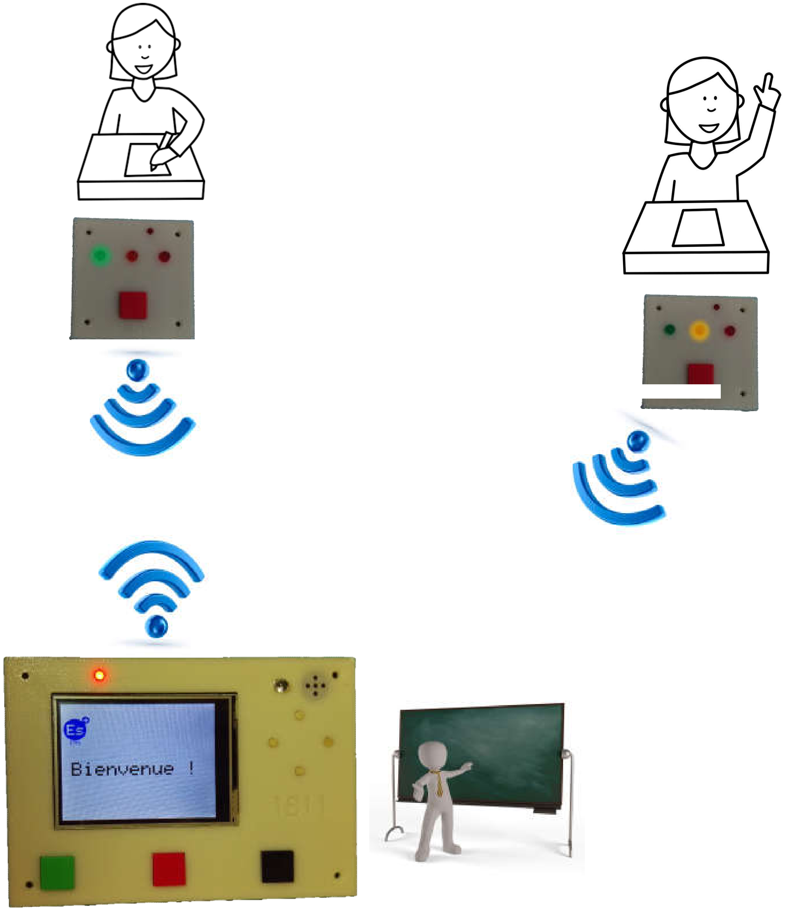
[picture p98: figure]

rue de Sébeillon 12, 1004 Lausanne | ETML

### Ticketing

Ce travail de diplôme fait suite à la demande des étudiants de première année SLO (2017/2018).
Avoir un système de ticketing électronique qui permettra aux enseignants de mieux gérer les demandes des étudiants lors des cours ou travaux pratiques.

Les envois des tickets et leur réception fonctionne bien, cependant les modules RF n'arrive plus à se connecter ensembles.

Les enseignants peuvent, grâce à une carte SD, définir le nom des modules de chaque élève ainsi et leurs configurer un quota de questions max.

Ce travail de diplôme était intéressant, c'était la première fois pour moi que je réalisais une communication sans-fil et un code aussi complexe, dû à la programmation de 3 cartes différentes et la gestion de la communication entre elles
