ETML-ES-SLO/PRJ_1811_Ticketing-/doc/1811_A_B/Rapports/Planning_1811 - réel.xlsx

Planning Diplôme 1811 Ticketing
 |  | jours | L | M | M | J | V | S | D | L | M | M | J | V | S | D | L | M | M | J | V | S | D | L | M | M | J | V | S | D | L | M | M | J | V | S | D | L | M
 | jours |  | 1 | 2 | 3 | 4 | 5 | 6 | 7 | 8 | 9 | 10 | 11 | 12 | 13 | 14 | 15 | 16 | 17 | 18 | 19 | 20 | 21 | 22 | 23 | 24 | 25 | 26 | 27 | 28 | 29 | 30 | 31 | 32 | 33 | 34 | 35 | 36 | 37
 |  | Date | 2017-08-27 | 2017-08-28 | 2017-08-29 | 2017-08-30 | 2017-08-31 | 2017-09-01 | 2017-09-02 | 2017-09-03 | 2017-09-04 | 2017-09-05 | 2017-09-06 | 2017-09-07 | 2017-09-08 | 2017-09-09 | 2017-09-10 | 2017-09-11 | 2017-09-12 | 2017-09-13 | 2017-09-14 | 2017-09-15 | 2017-09-16 | 2017-09-17 | 2017-09-18 | 2017-09-19 | 2017-09-20 | 2017-09-21 | 2017-09-22 | 2017-09-23 | 2017-09-24 | 2017-09-25 | 2017-09-26 | 2017-09-27 | 2017-09-28 | 2017-09-29 | 2017-09-30 | 2017-10-01 | 2017-10-02
Lecture cahier des charges |  |  |  |  |  |  |  |  |  |  |  |  |  |  |  |  |  |  |  |  |  |  |  | Jeûne Fédéral
Schéma bloc
Dimensionnement des composants
Réalisation Schématique
Réalisation du PCB
Commande du PCB et des composants
Réalisation du boitier
Fabrication du boitier
Programmation
Montage
Tests & Dépannage
Rapport
Présentation
Planifié
Réel
