ETML-ES-SLO/PRJ_1811_Ticketing-/soft/1811_C/diagramme/diagramme slave.png

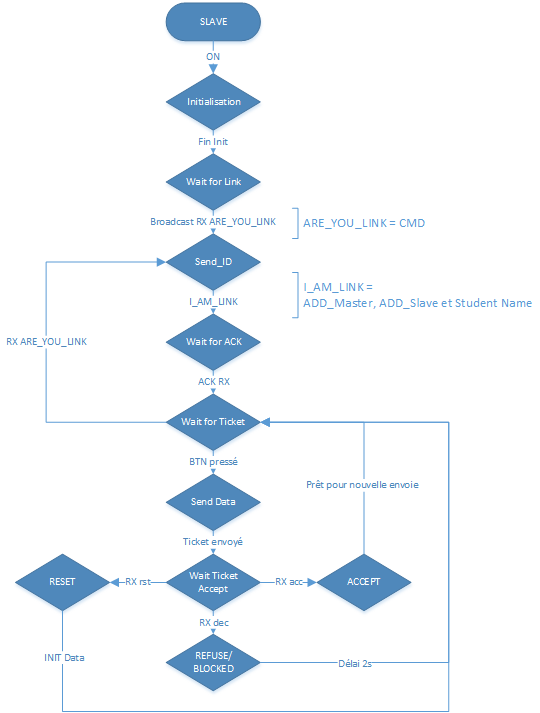
soft/1811_C/diagramme/diagramme slave.png
