ETML-ES-SLO/PRJ_1811_Ticketing-/hard/1811A/1812A_Ticketing/PCB_Ticketing_Slave.SLDASM

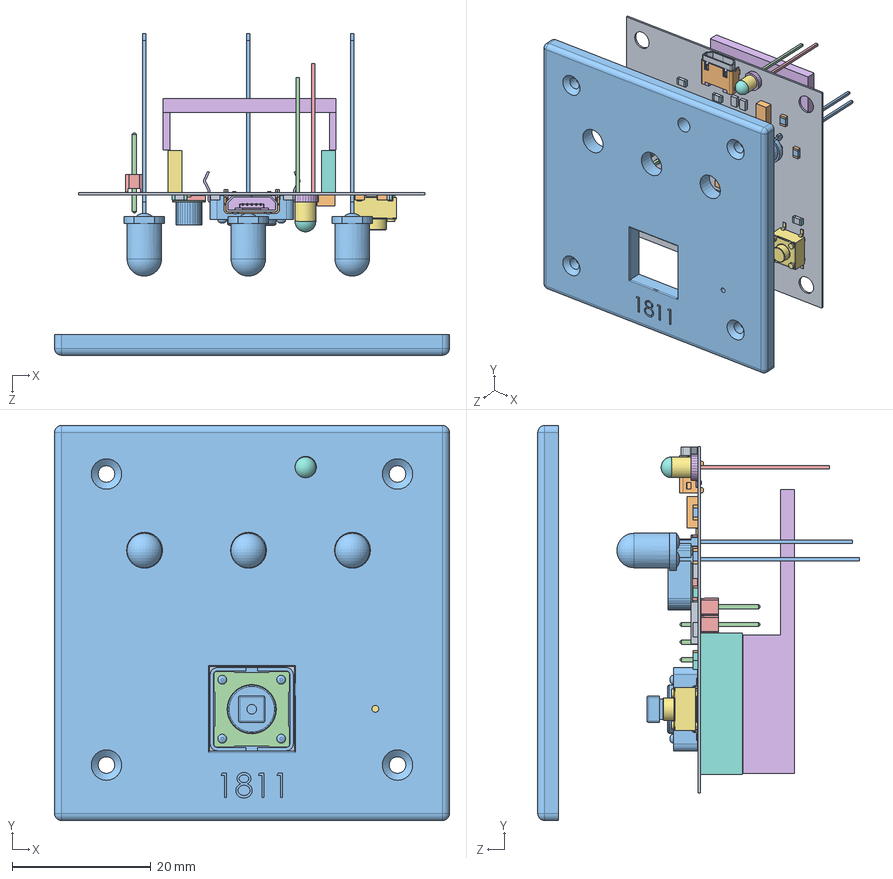
[picture p108: CAD file, 2025-01-31, last stored version]
hard/1811A/1812A_Ticketing/PCB_Ticketing_Slave.SLDASM
57.0 x 57.0 x 46.4 mm
Board
Extruded x 2
Extruded_2
Extruded_3
Extruded_4
Xbee
Extruded_5
Extruded_6
Extruded_7
Extruded_8
frame
cover
pins
pins_2
4301x20508x6
Extruded_9 x 10
Extruded_10 x 5
Extruded_11 x 4
Extruded_12 x 2
6130xx11121_PIN x 5
629105150521_Pin x 4
629105150521_PinMasse
629105150521_Shielding
629105150521_ShieldingCover
WL-TMRW_5mm x 3
Extruded_13
Extruded_14
Extruded_15
Extruded_16 x 5
Extruded_17 x 4
Top Boitier
