ETML-ES-SLO/PRJ_1811_Ticketing-/mec/1811A/Boitier/Boitier Escalve/assemblage/Assemblage1.SLDASM

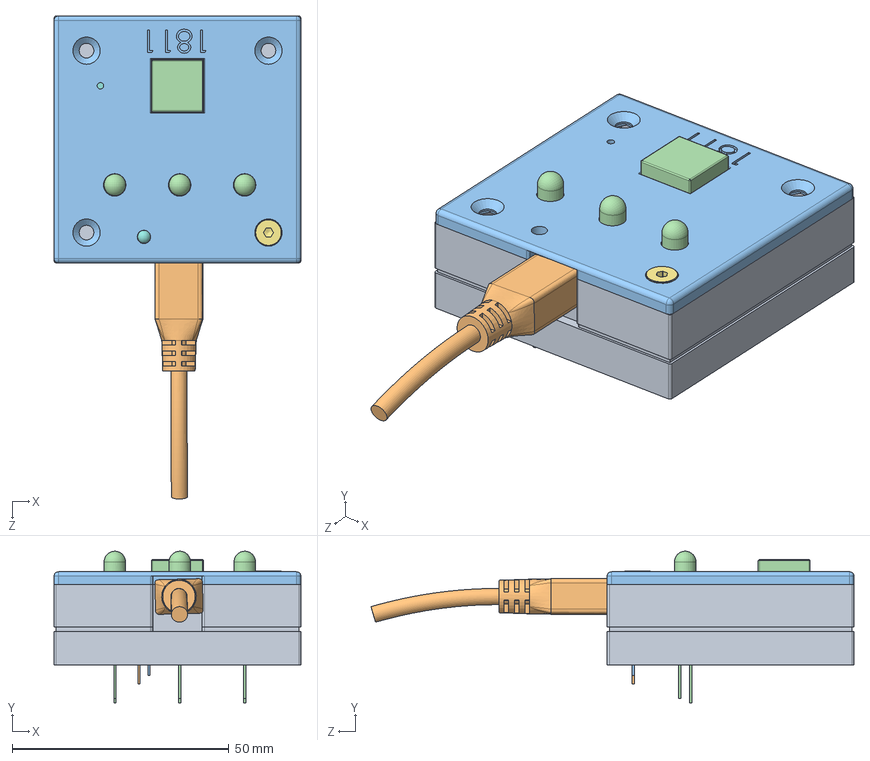
[picture p109: CAD file, 2025-01-31, last stored version]
mec/1811A/Boitier/Boitier Escalve/assemblage/Assemblage1.SLDASM
57.0 x 35.0 x 111.5 mm
Bottom Slave
MICRO-USB-CONNECTOR
Top Boitier
Board
Extruded x 4
Extruded_2 x 5
Extruded_3
Extruded_4
Extruded_5
WL-TMRW_5mm x 3
629105150521_Pin x 4
629105150521_PinMasse
629105150521_Shielding
629105150521_ShieldingCover
6130xx11121_PIN x 5
Extruded_6 x 8
Extruded_7 x 4
Extruded_8 x 6
Extruded_9 x 3
4301x20508x6
frame
cover
pins
pins_2
Extruded_10
Extruded_11
Extruded_12
Extruded_13
Extruded_14
Extruded_15 x 2
Xbee
CapuchonButtons
M3 ecrou
Entretoise 5mm
M3_par_12
