ETML-ES-SLO/PRJ_1811_Ticketing-/mec/1811A/Boitier/Boitier Master/Assemblage/Assemblage86.SLDASM

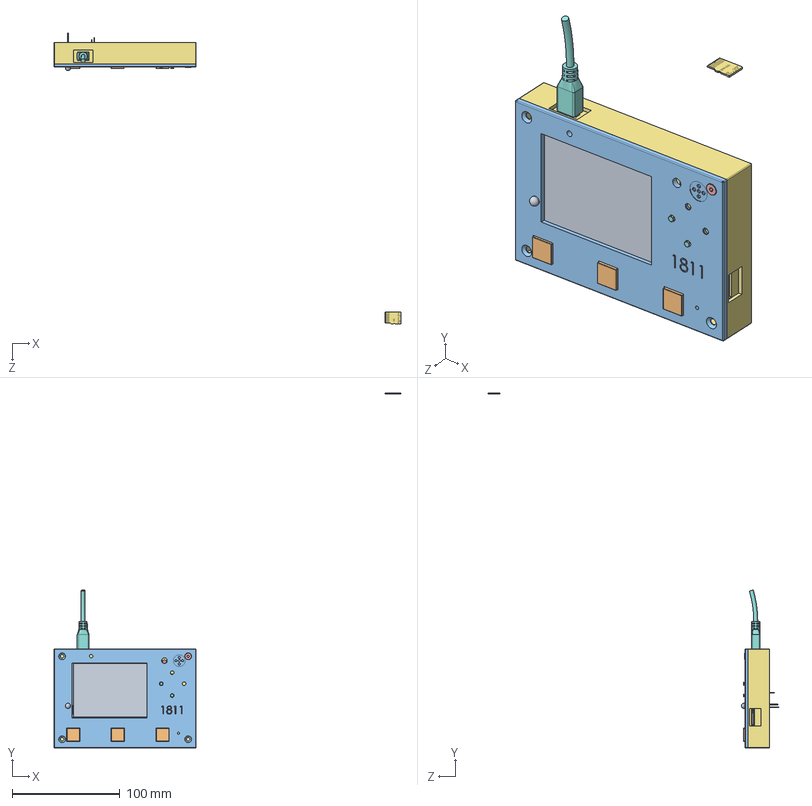
[picture p110: CAD file, 2025-01-31, last stored version]
mec/1811A/Boitier/Boitier Master/Assemblage/Assemblage86.SLDASM
322.1 x 329.3 x 270.2 mm
Board
Extruded_11 x 9
Extruded_2 x 6
Extruded_12 x 5
Extruded_13 x 13
Extruded_14 x 7
Extruded_15 x 3
Xbee
Extruded_9 x 4
Extruded_10
frame x 4
cover x 4
pins x 4
pins_2 x 4
4301x20508x6 x 2
4301x20958x6 x 2
Mid_Body
Open_CASCADE_STEP_translator_6.8_3.2.1 x 2
Mark
Mid_Body_2
Open_CASCADE_STEP_translator_6.8_3.2.1_2 x 2
Mark_2
Extruded_6 x 8
Extruded_7 x 4
Extruded_8 x 6
6130xx11121_PIN x 10
629105150521_Pin x 4
629105150521_PinMasse
629105150521_Shielding
629105150521_ShieldingCover
WL-TMRW_5mm
Extruded_3
Extruded_4
Extruded_5
Extruded_19 x 2
Extruded x 4
Adafruit_2.8TFT
CapuchonButtons x 3
boitier Top
Entretoise 5mm
M3_par_20
M3 ecrou
Bottom boitier
MICRO-USB-CONNECTOR
Micro SD card
