ETML-ES-SLO/PRJ_1811_Ticketing-/mec/1811A_B/Boitier/Pièces/PCB_Monté.SLDASM

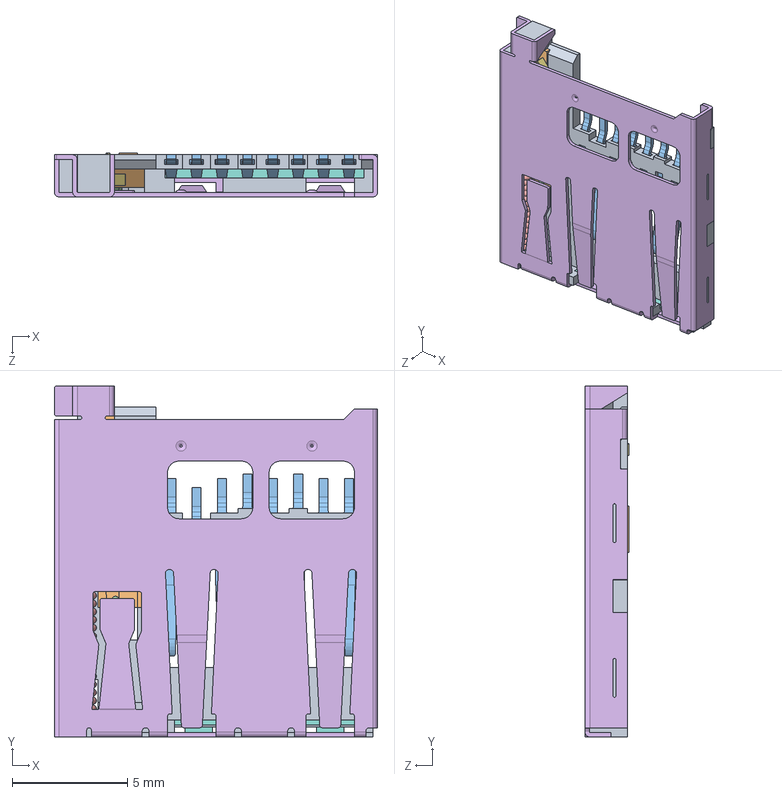
[picture p111: CAD file, 2025-01-31, last stored version]
mec/1811A_B/Boitier/Pièces/PCB_Monté.SLDASM
14.0 x 15.2 x 1.90 mm
693071010811_COULISSEAU
693071010811_CONTACT x 8
693071010811_AGRAPHE
693071010811_RESSORT
693071010811_CACHE
693071010811_LAME
693071010811_MASSE
