ETML-ES-SLO/PRJ_1811_Ticketing-/mec/1811A_B/Boitier/Pièces/Slave.SLDASM

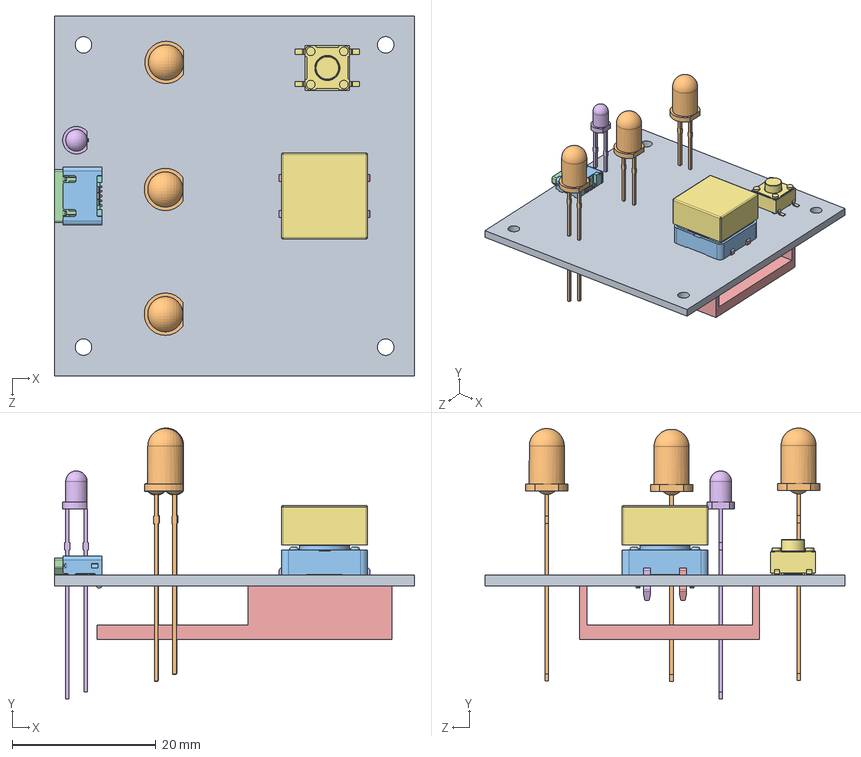
[picture p113: CAD file, 2025-01-31, last stored version]
mec/1811A_B/Boitier/Pièces/Slave.SLDASM
50.0 x 37.7 x 50.0 mm
PCB_SLAVE
STEP-WL-TMRC-5mm-wos-rev1 x 3
frame_1
cover_1
pins_1
pins_1_2
CapuchonButtons
629105150521_Housing
629105150521_Pin1 x 4
629105150521_Pin2
629105150521_Shielding2
629105150521_Shielding
Xbee
STEP-WL-TMRC-3mm-wos-rev1
bouton5mm
