ETML-ES-SLO/PRJ_1811_Ticketing-/mec/1811A_B/Boitier/Pièces/Assemblage TopPCBBot.SLDASM

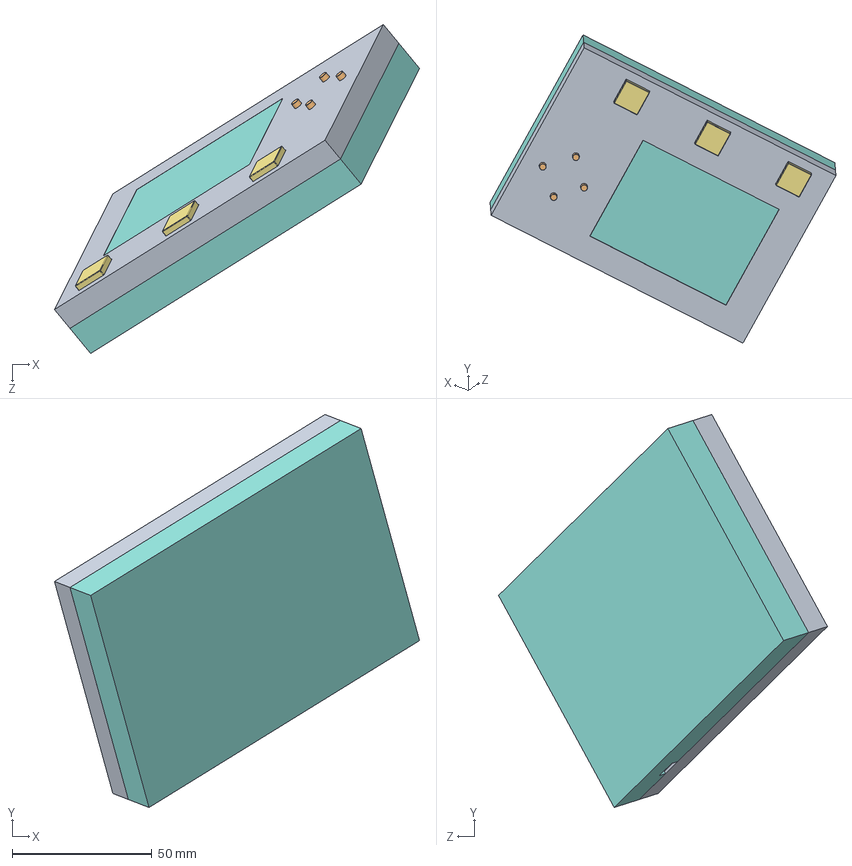
[picture p115: CAD file, 2025-01-31, last stored version]
mec/1811A_B/Boitier/Pièces/Assemblage TopPCBBot.SLDASM
130.8 x 140.7 x 117.8 mm
PCB
bouton menu x 4
frame_1 x 3
cover_1 x 3
pins_1 x 3
pins_1_2 x 3
CapuchonButtons x 3
écranAdafruit
bouton5mm
Xbee
693071010811_COULISSEAU
693071010811_CONTACT x 8
693071010811_AGRAPHE
693071010811_RESSORT
693071010811_CACHE
693071010811_LAME
693071010811_MASSE
629105150521_Housing
629105150521_Pin1 x 4
629105150521_Pin2
629105150521_Shielding2
629105150521_Shielding
Bottom boitier
boitier Top
