ETML-ES-SLO/PRJ_1811_Ticketing-/mec/1811A_B/Boitier/Pièces/AssemblageSlave.SLDASM

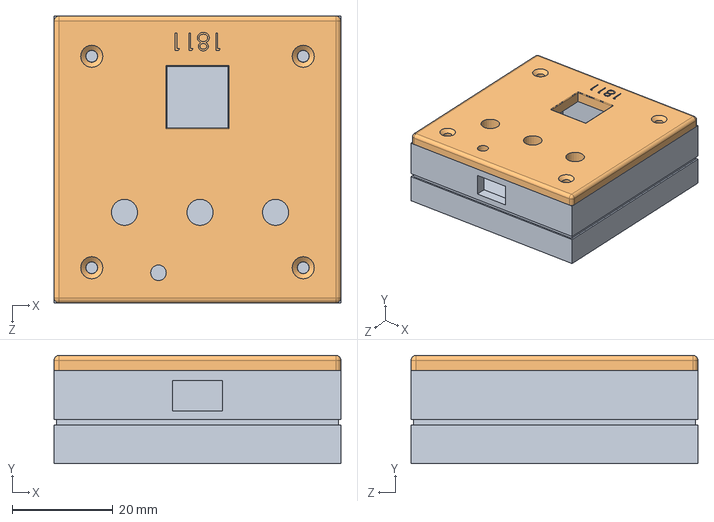
[picture p116: CAD file, 2025-01-31, last stored version]
mec/1811A_B/Boitier/Pièces/AssemblageSlave.SLDASM
57.0 x 21.5 x 57.0 mm
Bottom Slave
Top Boitier
