ETML-ES-SLO/PRJ_1811_Ticketing-/mec/1811A_B/Boitier/Pièces/USB.SLDASM

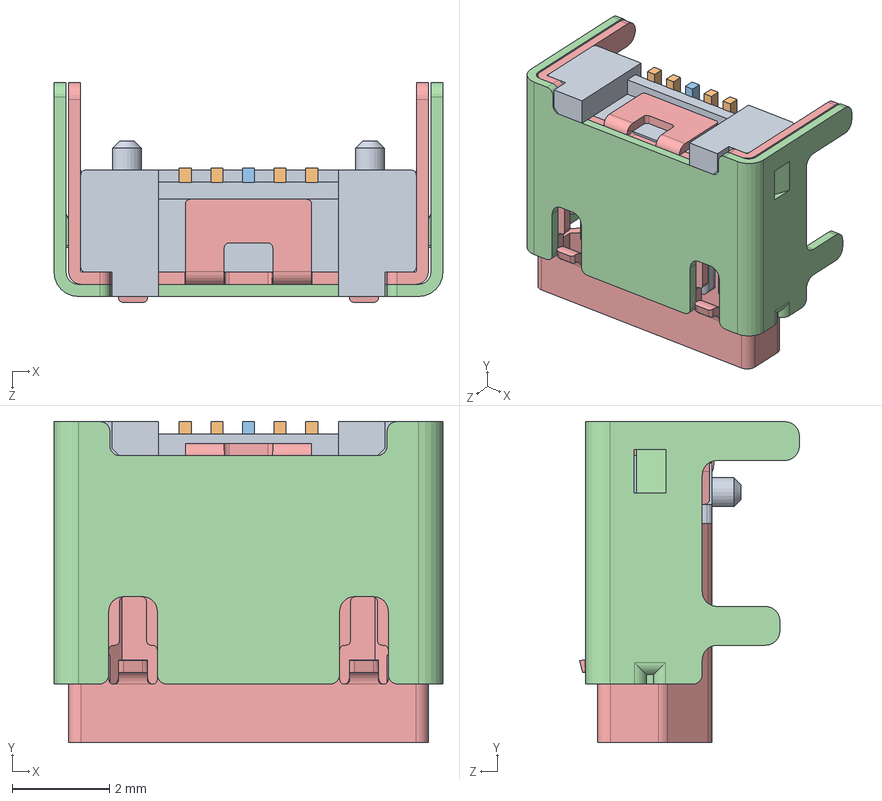
[picture p117: CAD file, 2025-01-31, last stored version]
mec/1811A_B/Boitier/Pièces/USB.SLDASM
8.00 x 6.60 x 4.52 mm
629105150521_Housing
629105150521_Pin1 x 4
629105150521_Pin2
629105150521_Shielding2
629105150521_Shielding
