ETML-ES-SLO/PRJ_1811_Ticketing-/mec/1811A_B/Boitier/Boitier Escalve/assemblage avec PCB faux/PCB_Ticketing_Slave1.SLDASM

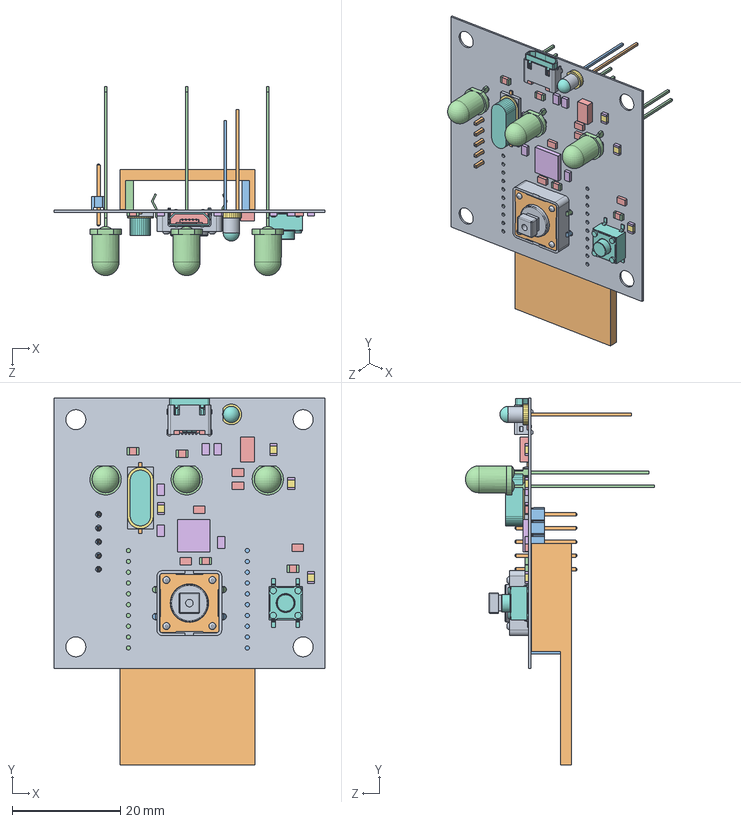
[picture p118: CAD file, 2025-01-31, last stored version]
mec/1811A_B/Boitier/Boitier Escalve/assemblage avec PCB faux/PCB_Ticketing_Slave1.SLDASM
50.0 x 67.9 x 35.0 mm
Board
Xbee
Extruded
Extruded_2
Extruded_3 x 5
Extruded_4 x 5
Extruded_5
Extruded_6
Extruded_7
WL-TMRW_5mm x 3
629105150521_Pin x 4
629105150521_PinMasse
629105150521_Shielding
629105150521_ShieldingCover
6130xx11121_PIN x 5
Extruded_8 x 8
Extruded_9 x 4
Extruded_10 x 8
Extruded_11 x 4
4301x20508x6
frame
cover
pins
pins_2
Extruded_12
Extruded_13
Extruded_14
Extruded_15
Extruded_16
Extruded_17 x 2
