ETML-ES-SLO/PRJ_1811_Ticketing-/mec/1811A/Assemblage/entretoise 4mm M3.SLDPRT

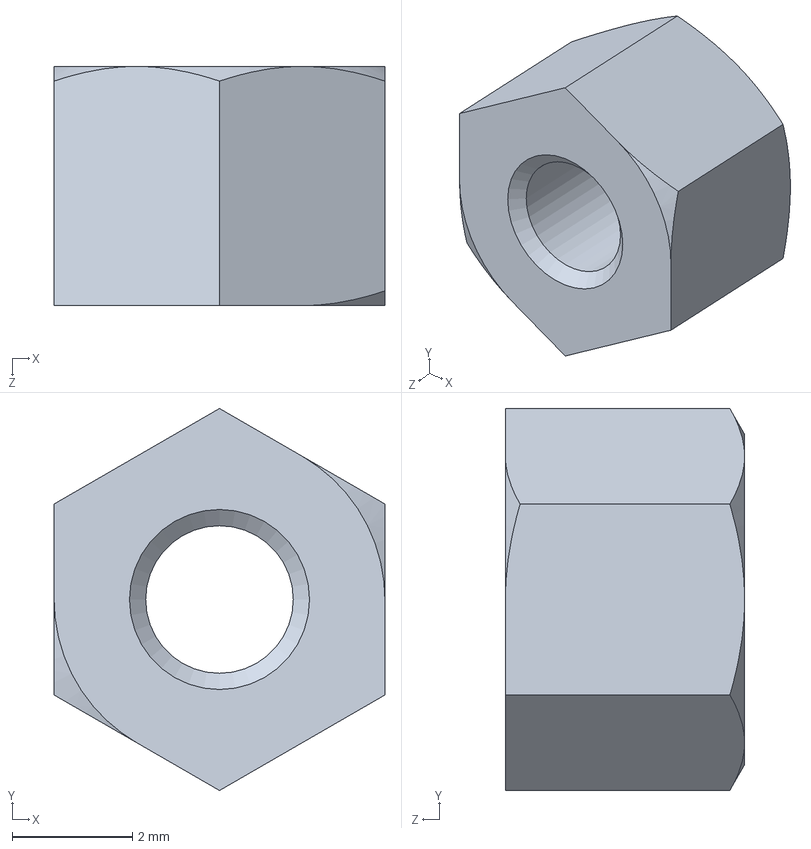
[picture p120: CAD file, 2025-01-31, last stored version]
mec/1811A/Assemblage/entretoise 4mm M3.SLDPRT
5.51 x 6.36 x 3.99 mm
