ETML-ES-SLO/PRJ_1811_Ticketing-/mec/1811A_B/Boitier/Boitier Master/MICRO-USB-CONNECTOR.SLDPRT

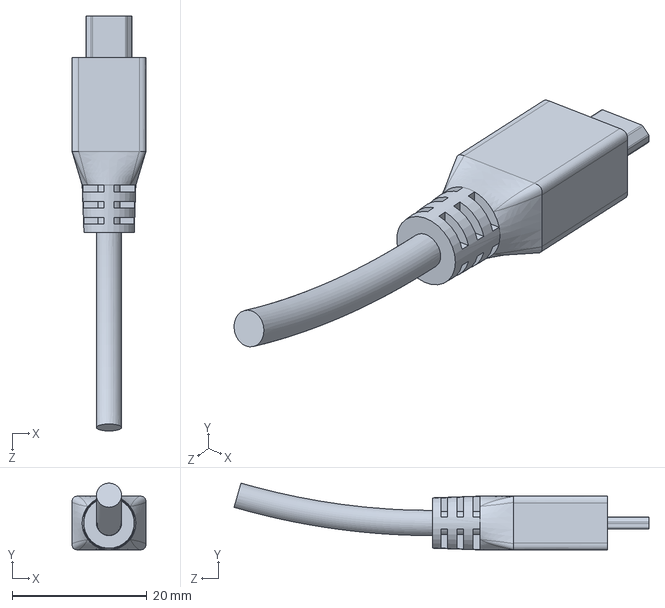
[picture p121: CAD file, 2025-01-31, last stored version]
mec/1811A_B/Boitier/Boitier Master/MICRO-USB-CONNECTOR.SLDPRT
11.0 x 9.94 x 61.7 mm
