ETML-ES-SLO/PRJ_1811_Ticketing-/mec/1811A_B/Boitier/Pièces/bouton5mm.SLDPRT

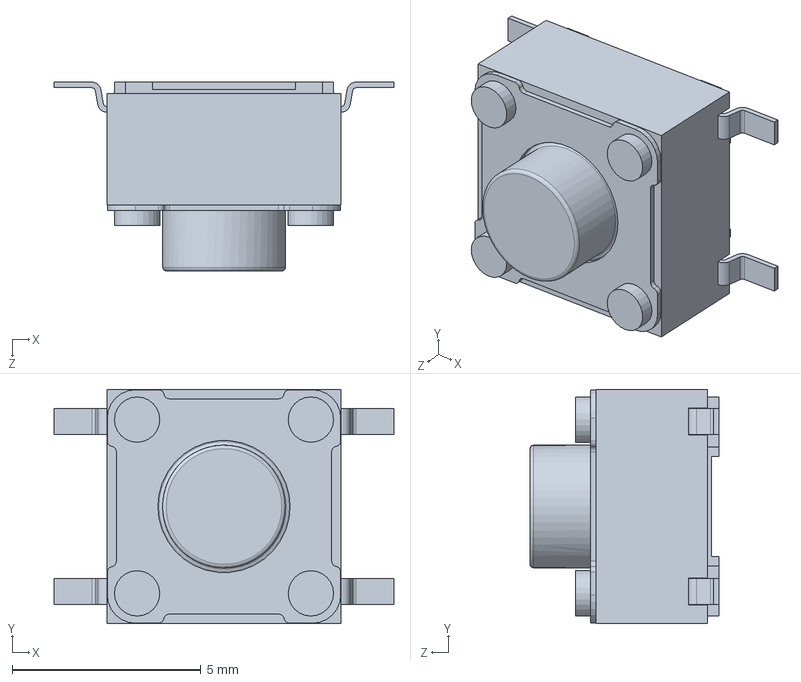
[picture p122: CAD file, 2025-01-31, last stored version]
mec/1811A_B/Boitier/Pièces/bouton5mm.SLDPRT
9.00 x 6.20 x 5.00 mm
