ETML-ES-SLO/PRJ_1811_Ticketing-/mec/1811C/Boitier Master/Boitier/1555HL2GY.stp

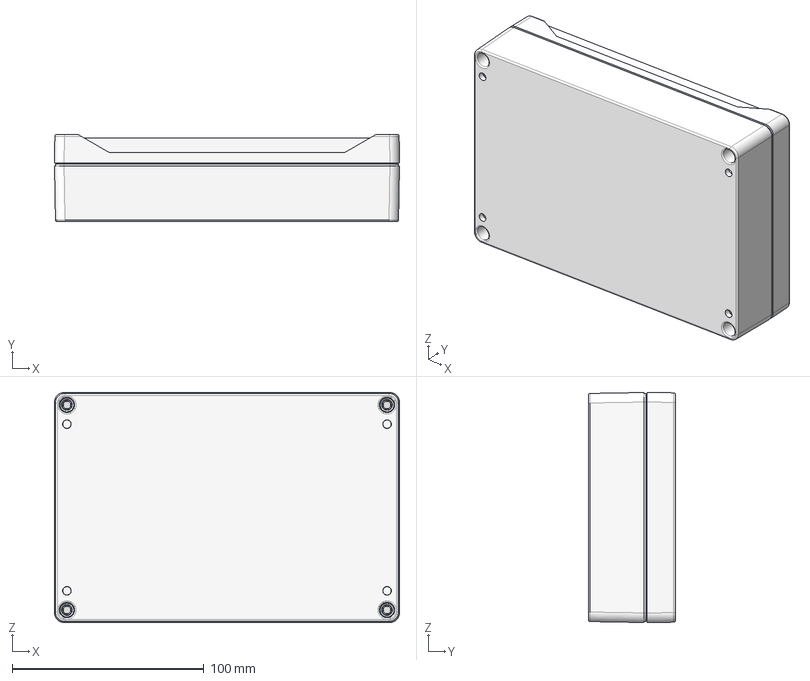
[picture p123: CAD file, 2025-01-31, last stored version]
mec/1811C/Boitier Master/Boitier/1555HL2GY.stp
180.1 x 45.6 x 120.1 mm
1554HL Box
lid H_T1
SC576 (screw M4-0.7X 20mm PN) x 4
Insert x 4
Insert_1 x 4
1554H-T GASKET
