ETML-ES-SLO/PRJ_1811_Ticketing-/mec/1811C/Boitier Slave/Boitier/1591XXMBK.stp

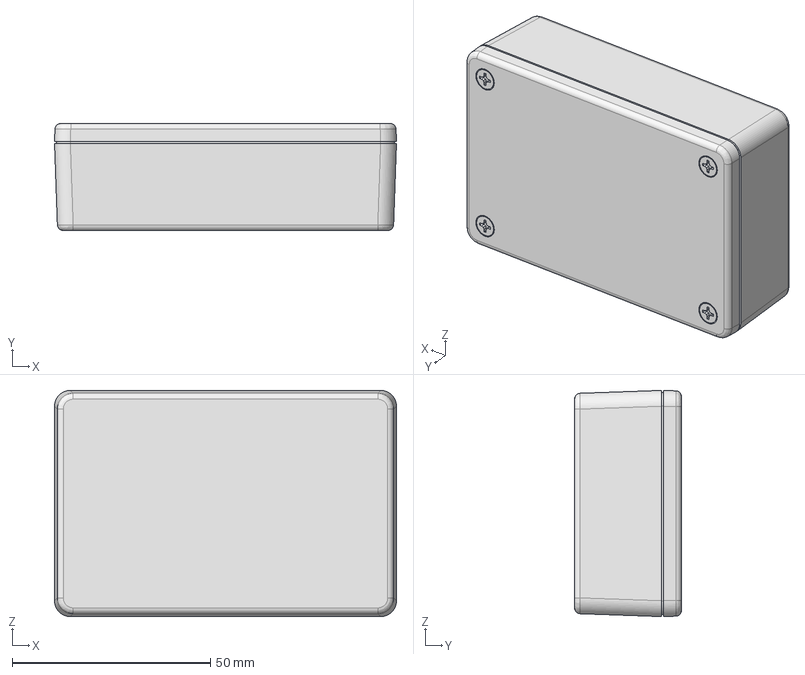
[picture p124: CAD file, 2025-01-31, last stored version]
mec/1811C/Boitier Slave/Boitier/1591XXMBK.stp
86.2 x 27.0 x 57.0 mm
1591XXM BOX
1591XXM LID
SC500 (screw M3-0.5X 10mm FH) x 4
IN100 (insert M3-0.5X5.75mm BRASS) x 4
