ETML-ES-SLO/PRJ_1811_Ticketing-/mec/1811C/Boitier Slave/PCB 3D/PCB_Ticketing_Slave_SSOP.step

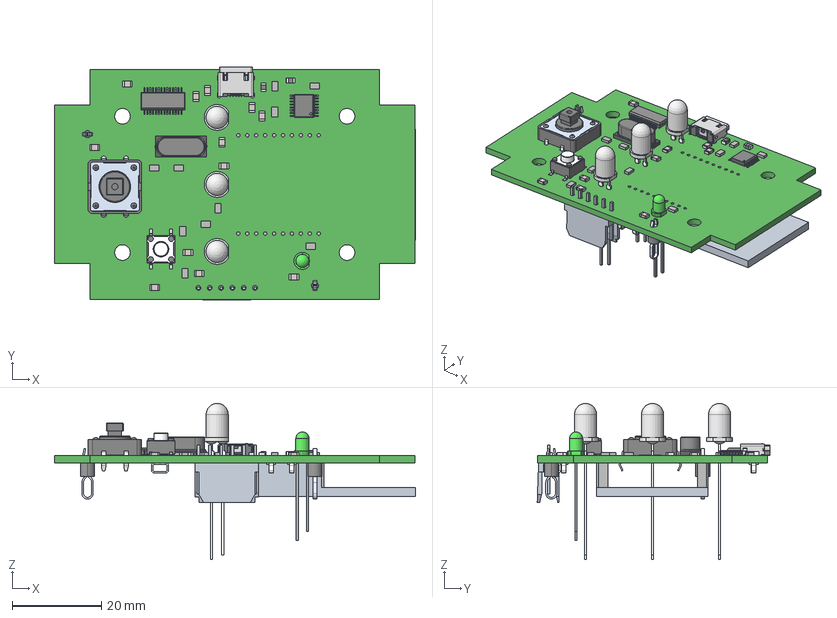
[picture p125: CAD file, 2025-01-31, last stored version]
mec/1811C/Boitier Slave/PCB 3D/PCB_Ticketing_Slave_SSOP.step
80.8 x 52.1 x 35.0 mm
Extruded x 51
crystal_hc-49-smd
Open_CASCADE_STEP_translator_6.8_2.1
Open_CASCADE_STEP_translator_6.8_2.2.1
Leader x 16
keystone-PN5019 x 6
L\X2\00F6\X0\tende x 4
DAC8820IBDB
frame
cover
pins x 2
4301x20508x6
629105150521_Pin x 4
629105150521_PinMasse
629105150521_Shielding
629105150521_ShieldingCover
WL-TMRW_5mm x 3
Xbee
76384-406LF--3DModel-STEP-533217
keystone-PN5011 x 2
