ETML-ES-SLO/PRJ_1811_Ticketing-/mec/1811A_B/Boitier/Boitier Escalve/Top Boitier.SLDPRT

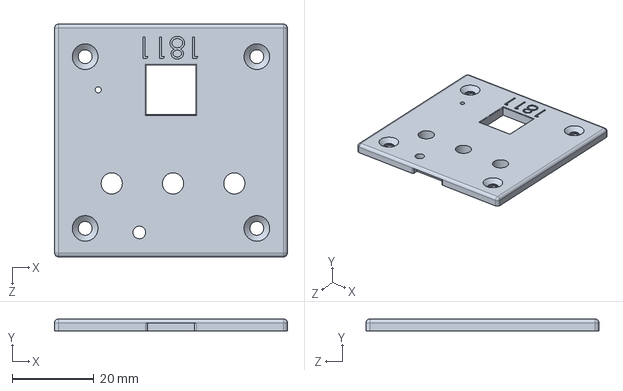
[picture p126: CAD file, 2025-01-31, last stored version]
mec/1811A_B/Boitier/Boitier Escalve/Top Boitier.SLDPRT
57.0 x 3.00 x 57.0 mm
