ETML-ES-SLO/PRJ_1811_Ticketing-/mec/1811A_B/Boitier/Boitier Master/boitier Top.SLDPRT

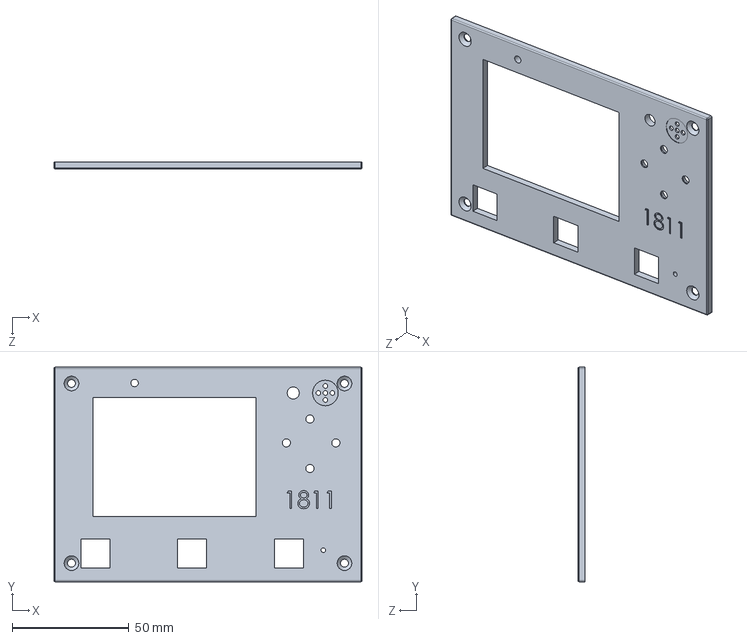
[picture p127: CAD file, 2025-01-31, last stored version]
mec/1811A_B/Boitier/Boitier Master/boitier Top.SLDPRT
132.0 x 92.0 x 3.00 mm
