ETML-ES-SLO/PRJ_1811_Ticketing-/(list of files, cad)

Other CAD files:
mec/1811A_B/PCBs STEP/Slave/D1.sldasm
mec/1811A_B/Boitier/Boitier Escalve/assemblage avec PCB faux/Download_STP_629105150521.sldasm
mec/1811A_B/PCBs STEP/Slave/U2.sldasm
mec/1811A_B/PCBs STEP/Master/R15.sldasm
mec/1811A_B/Boitier/Boitier Escalve/assemblage avec PCB faux/C1.sldasm
mec/1811A_B/PCBs STEP/Slave/U1.sldasm
mec/1811A_B/Boitier/Boitier Escalve/assemblage avec PCB faux/C10.sldasm
mec/1811A_B/PCBs STEP/Master/R7.sldasm
mec/1811A_B/PCBs STEP/Master/J1.sldasm
mec/1811A_B/PCBs STEP/Master/C2.sldasm
mec/1811A_B/PCBs STEP/Slave/J2.sldasm
mec/1811A_B/PCBs STEP/Master/R9.sldasm
mec/1811A_B/PCBs STEP/Slave/D2.sldasm
mec/1811A_B/PCBs STEP/Master/Free-Models.sldasm
mec/1811A_B/Boitier/Boitier Escalve/assemblage avec PCB faux/R1.sldasm
mec/1811A_B/PCBs STEP/Master/C5.sldasm
mec/1811A_B/PCBs STEP/Slave/D4.sldasm
mec/1811A_B/Boitier/Boitier Escalve/assemblage avec PCB faux/R5.sldasm
mec/1811A_B/PCBs STEP/Master/R19.sldasm
mec/1811A_B/Boitier/Boitier Escalve/assemblage avec PCB faux/U1.sldasm
mec/1811A_B/Boitier/Boitier Escalve/assemblage avec PCB faux/J2.sldasm
mec/1811A_B/PCBs STEP/Slave/C8.sldasm
mec/1811A_B/PCBs STEP/Slave/C6.sldasm
mec/1811A_B/PCBs STEP/Master/U3.sldasm
mec/1811A_B/PCBs STEP/Master/R5.sldasm
mec/1811A_B/Boitier/Boitier Escalve/assemblage avec PCB faux/D3.sldasm
mec/1811A_B/Boitier/Boitier Escalve/assemblage avec PCB faux/C7.sldasm
mec/1811A_B/PCBs STEP/Master/Download_STP_629105150521.sldasm
mec/1811A_B/PCBs STEP/Slave/C2.sldasm
mec/1811A_B/Boitier/Boitier Escalve/assemblage avec PCB faux/C3.sldasm
mec/1811A_B/Boitier/Pièces/SD.SLDASM
mec/1811A_B/PCBs STEP/Master/X1.sldasm
mec/1811A_B/PCBs STEP/Master/C1.sldasm
mec/1811A_B/PCBs STEP/Slave/C3.sldasm
mec/1811A_B/Boitier/Boitier Escalve/assemblage avec PCB faux/C8.sldasm
mec/1811A_B/PCBs STEP/Master/X2.sldasm
mec/1811A_B/PCBs STEP/Slave/X1.sldasm
mec/1811A_B/Boitier/Boitier Escalve/assemblage avec PCB faux/X2.sldasm
mec/1811A_B/PCBs STEP/Slave/R2.sldasm
mec/1811A_B/PCBs STEP/Master/S8.sldasm
mec/1811A_B/Boitier/Boitier Escalve/assemblage avec PCB faux/C9.sldasm
mec/1811A_B/PCBs STEP/Master/J2.sldasm
mec/1811A_B/PCBs STEP/Slave/R5.sldasm
mec/1811A_B/PCBs STEP/Master/R6.sldasm
mec/1811A_B/Boitier/Boitier Escalve/assemblage avec PCB faux/R2.sldasm
mec/1811A_B/PCBs STEP/Slave/C7.sldasm
mec/1811A_B/Boitier/Boitier Escalve/assemblage avec PCB faux/U2.sldasm
mec/1811A_B/PCBs STEP/Slave/C9.sldasm
mec/1811A_B/Boitier/Boitier Escalve/assemblage avec PCB faux/D1.sldasm
mec/1811A_B/PCBs STEP/Slave/C1.sldasm
mec/1811A_B/Boitier/Boitier Escalve/assemblage avec PCB faux/S1.sldasm
mec/1811A_B/PCBs STEP/Master/R18.sldasm
mec/1811A_B/PCBs STEP/Slave/X2.sldasm
mec/1811A_B/PCBs STEP/Master/D1.sldasm
mec/1811A_B/PCBs STEP/Slave/S2.sldasm
mec/1811A_B/Boitier/Boitier Escalve/assemblage avec PCB faux/C4.sldasm
mec/1811A_B/PCBs STEP/Master/R8.sldasm
mec/1811A_B/PCBs STEP/Master/R10.sldasm
mec/1811A_B/PCBs STEP/Master/S5.sldasm
mec/1811A_B/PCBs STEP/Slave/J1.sldasm
mec/1811A_B/PCBs STEP/Slave/R1.sldasm
mec/1811A_B/PCBs STEP/Master/U1.sldasm
mec/1811A_B/PCBs STEP/Slave/C4.sldasm
mec/1811A_B/Boitier/Boitier Escalve/assemblage avec PCB faux/D2.sldasm
mec/1811A_B/PCBs STEP/Master/Terminal.sldasm
mec/1811A_B/Boitier/Boitier Escalve/assemblage avec PCB faux/C2.sldasm
mec/1811A_B/PCBs STEP/Master/S6.sldasm
mec/1811A_B/PCBs STEP/Slave/R6.sldasm
mec/1811A_B/PCBs STEP/Master/R1.sldasm
mec/1811A_B/Boitier/Boitier Escalve/assemblage avec PCB faux/J1.sldasm
mec/1811A_B/PCBs STEP/Master/R11.sldasm
mec/1811A_B/PCBs STEP/Master/R16.sldasm
mec/1811A_B/PCBs STEP/Slave/R7.sldasm
mec/1811A_B/PCBs STEP/Slave/C5.sldasm
mec/1811A_B/PCBs STEP/Master/C10.sldasm
mec/1811A_B/Boitier/Boitier Escalve/assemblage avec PCB faux/X1.sldasm
mec/1811A_B/PCBs STEP/Slave/S1.sldasm
mec/1811A_B/PCBs STEP/Master/R12.sldasm
mec/1811A_B/Boitier/Boitier Escalve/assemblage avec PCB faux/S2.sldasm
mec/1811A_B/Boitier/Boitier Escalve/assemblage avec PCB faux/R8.sldasm
mec/1811A_B/PCBs STEP/Master/S2.sldasm
mec/1811A_B/Boitier/Boitier Escalve/assemblage avec PCB faux/C5.sldasm
mec/1811A_B/PCBs STEP/Master/R4.sldasm
mec/1811A_B/PCBs STEP/Slave/R4.sldasm
mec/1811A_B/Boitier/Boitier Escalve/assemblage avec PCB faux/D4.sldasm
mec/1811A_B/Boitier/Boitier Escalve/assemblage avec PCB faux/R6.sldasm
mec/1811A_B/PCBs STEP/Master/C7.sldasm
mec/1811A_B/Boitier/Boitier Escalve/assemblage avec PCB faux/C6.sldasm
mec/1811A_B/PCBs STEP/Slave/Download_STP_629105150521.sldasm
mec/1811A_B/PCBs STEP/Master/C4.sldasm
mec/1811A_B/PCBs STEP/Slave/R3.sldasm
mec/1811A_B/PCBs STEP/Master/R17.sldasm
mec/1811A_B/Boitier/Boitier Escalve/assemblage avec PCB faux/R4.sldasm
mec/1811A_B/Boitier/Boitier Escalve/assemblage avec PCB faux/R3.sldasm
mec/1811A_B/PCBs STEP/Master/VR1.sldasm
mec/1811A_B/PCBs STEP/Slave/D3.sldasm
mec/1811A_B/PCBs STEP/Master/S1.sldasm
mec/1811A_B/PCBs STEP/Master/C9.sldasm
mec/1811A_B/Boitier/Boitier Escalve/assemblage avec PCB faux/R7.sldasm
mec/1811A_B/PCBs STEP/Master/S4.sldasm
mec/1811A_B/PCBs STEP/Master/J3.sldasm
mec/1811A_B/PCBs STEP/Master/Terminal_2.sldasm
mec/1811A_B/PCBs STEP/Master/R14.sldasm
mec/1811A_B/PCBs STEP/Master/S3.sldasm
mec/1811A_B/PCBs STEP/Master/R13.sldasm
mec/1811A_B/PCBs STEP/Master/R2.sldasm
mec/1811A_B/PCBs STEP/Master/C11.sldasm
mec/1811A_B/PCBs STEP/Master/C3.sldasm
mec/1811A_B/PCBs STEP/Master/S7.sldasm
mec/1811A_B/PCBs STEP/Master/D2.sldasm
mec/1811A_B/PCBs STEP/Master/C8.sldasm
mec/1811A_B/PCBs STEP/Master/U2.sldasm
mec/1811A_B/PCBs STEP/Master/R3.sldasm
mec/1811A_B/PCBs STEP/Master/C6.sldasm
mec/1811A_B/PCBs STEP/Master/Q1.sldasm
mec/1811A_B/Assemblage/Slave/Extruded_14.sldprt
mec/1811A_B/Boitier/Boitier Escalve/assemblage avec PCB faux/Extruded_11.sldprt
mec/1811A_B/PCBs STEP/Master/Adafruit_2.8TFT.sldprt
mec/1811A_B/Assemblage/Slave/Extruded_2.sldprt
mec/1811A_B/PCBs STEP/Master/pins_2.sldprt
mec/1811A_B/PCBs STEP/Slave/pins.sldprt
mec/1811A_B/Assemblage/Slave/Sphere.sldprt
mec/1811A/Assemblage/Slave/4301x20508x6.sldprt
mec/1811A/Assemblage/Slave/61300511121.sldprt
mec/1811A/Assemblage/Slave/6130xx11121_PIN.sldprt
mec/1811A/Assemblage/Slave/629105150521.sldprt
mec/1811A/Assemblage/Slave/629105150521_Pin.sldprt
mec/1811A/Assemblage/Slave/629105150521_PinMasse.sldprt
mec/1811A/Assemblage/Slave/629105150521_Shielding.sldprt
mec/1811A/Assemblage/Slave/629105150521_ShieldingCover.sldprt
mec/1811A/Assemblage/Slave/Board.sldprt
mec/1811A/Assemblage/Slave/Cylinder.sldprt
mec/1811A/Assemblage/Slave/Extruded.sldprt
mec/1811A/Assemblage/Slave/Extruded_10.sldprt
mec/1811A/Assemblage/Slave/Extruded_11.sldprt
mec/1811A/Assemblage/Slave/Extruded_12.sldprt
mec/1811A/Assemblage/Slave/Extruded_13.sldprt
mec/1811A/Assemblage/Slave/Extruded_14.sldprt
mec/1811A/Assemblage/Slave/Extruded_15.sldprt
mec/1811A/Assemblage/Slave/Extruded_16.sldprt
mec/1811A/Assemblage/Slave/Extruded_17.sldprt
mec/1811A/Assemblage/Slave/Extruded_2.sldprt
mec/1811A/Assemblage/Slave/Extruded_3.sldprt
mec/1811A/Assemblage/Slave/Extruded_4.sldprt
mec/1811A/Assemblage/Slave/Extruded_5.sldprt
mec/1811A/Assemblage/Slave/Extruded_6.sldprt
mec/1811A/Assemblage/Slave/Extruded_7.sldprt
mec/1811A/Assemblage/Slave/Extruded_8.sldprt
mec/1811A/Assemblage/Slave/Extruded_9.sldprt
mec/1811A/Assemblage/Slave/Sphere.sldprt
mec/1811A/Assemblage/Slave/WL-TMRW_5mm.sldprt
mec/1811A/Assemblage/Slave/Xbee.sldprt
mec/1811A/Assemblage/Slave/cover.sldprt
mec/1811A/Assemblage/Slave/frame.sldprt
mec/1811A/Assemblage/Slave/pins.sldprt
mec/1811A/Assemblage/Slave/pins_2.sldprt
mec/1811A/Boitier/Boitier Escalve/Bottom Slave_old.SLDPRT
mec/1811A/Boitier/Boitier Escalve/Bottom Slave_version_Pour_PCB faux.SLDPRT
mec/1811A/Boitier/Boitier Escalve/assemblage avec PCB faux/1134917264.sldasm
mec/1811A/Boitier/Boitier Escalve/assemblage avec PCB faux/1134917392.sldasm
mec/1811A/Boitier/Boitier Escalve/assemblage avec PCB faux/1544419280.sldasm
mec/1811A/Boitier/Boitier Escalve/assemblage avec PCB faux/1544419416.sldasm
mec/1811A/Boitier/Boitier Escalve/assemblage avec PCB faux/1544419552.sldasm
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
