ETML-ES-SLO/PRJ_1811_Ticketing-/doc/1811_C/PDF/Nouveau dossier/Schematic Prints Master.PDF

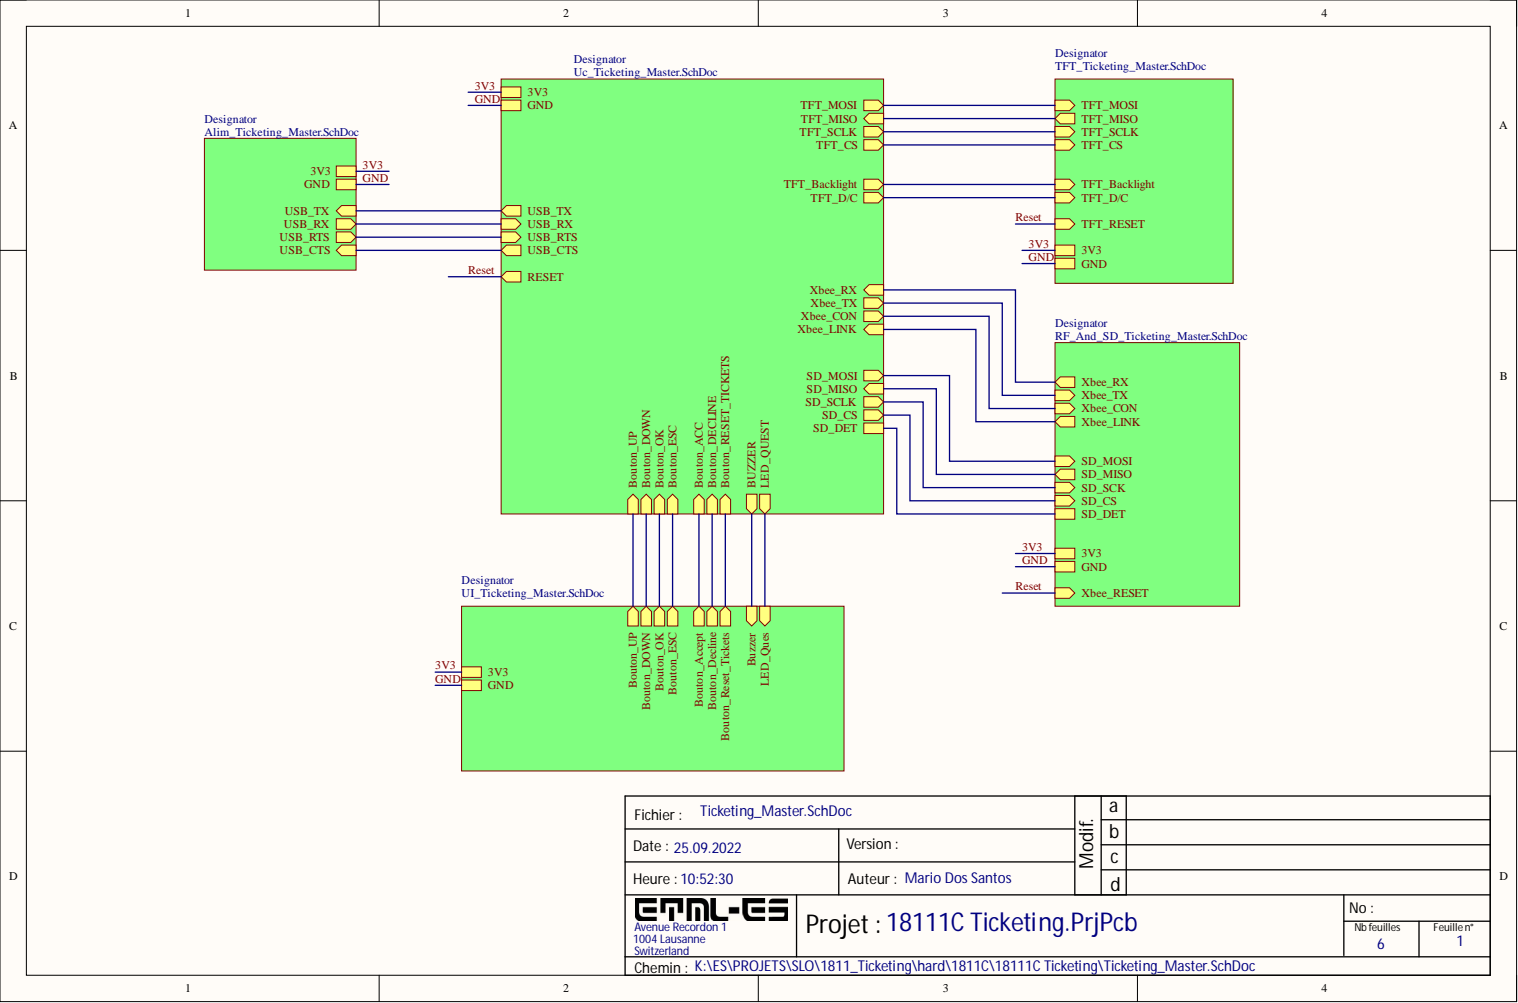
[picture p128: page 1]

Ticketing_Master.SchDoc Fichier : | | a

Date : 25.09.2022 | Version :

Heure : 10:52:30 | Mario Dos Santos Auteur :
Avenue Recordon 1 1004 Lausanne Switzerland | Projet : 18111C Ticketing.PrjPcb | No :

Nb feuilles | Feuille n°

Chemin : K:\ES\PROJETS\SLO\1811_Ticketing\hard\1811C\18111C Ticketing\Ticketing_Master.SchDoc

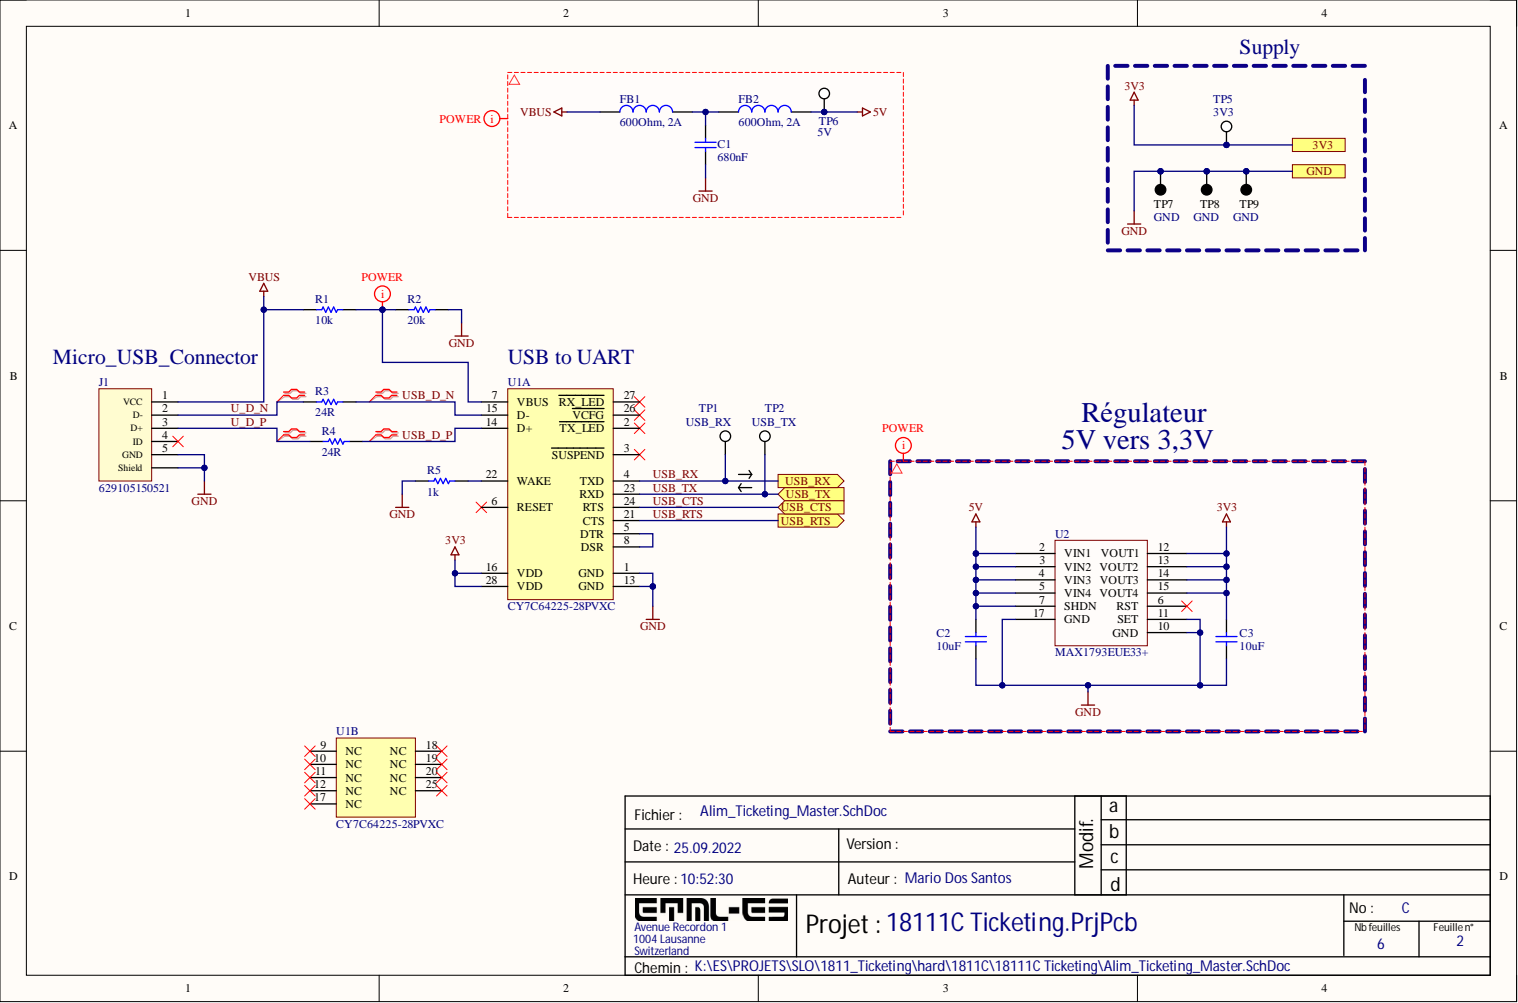
[picture p129: page 2]

Alim_Ticketing_Master.SchDoc Fichier : | | a

Date : 25.09.2022 | Version :

Heure : 10:52:30 | Mario Dos Santos Auteur :

Projet : 18111C Ticketing.PrjPcb | No : C

Chemin : K:\ES\PROJETS\SLO\1811_Ticketing\hard\1811C\18111C Ticketing\Alim_Ticketing_Master.SchDoc

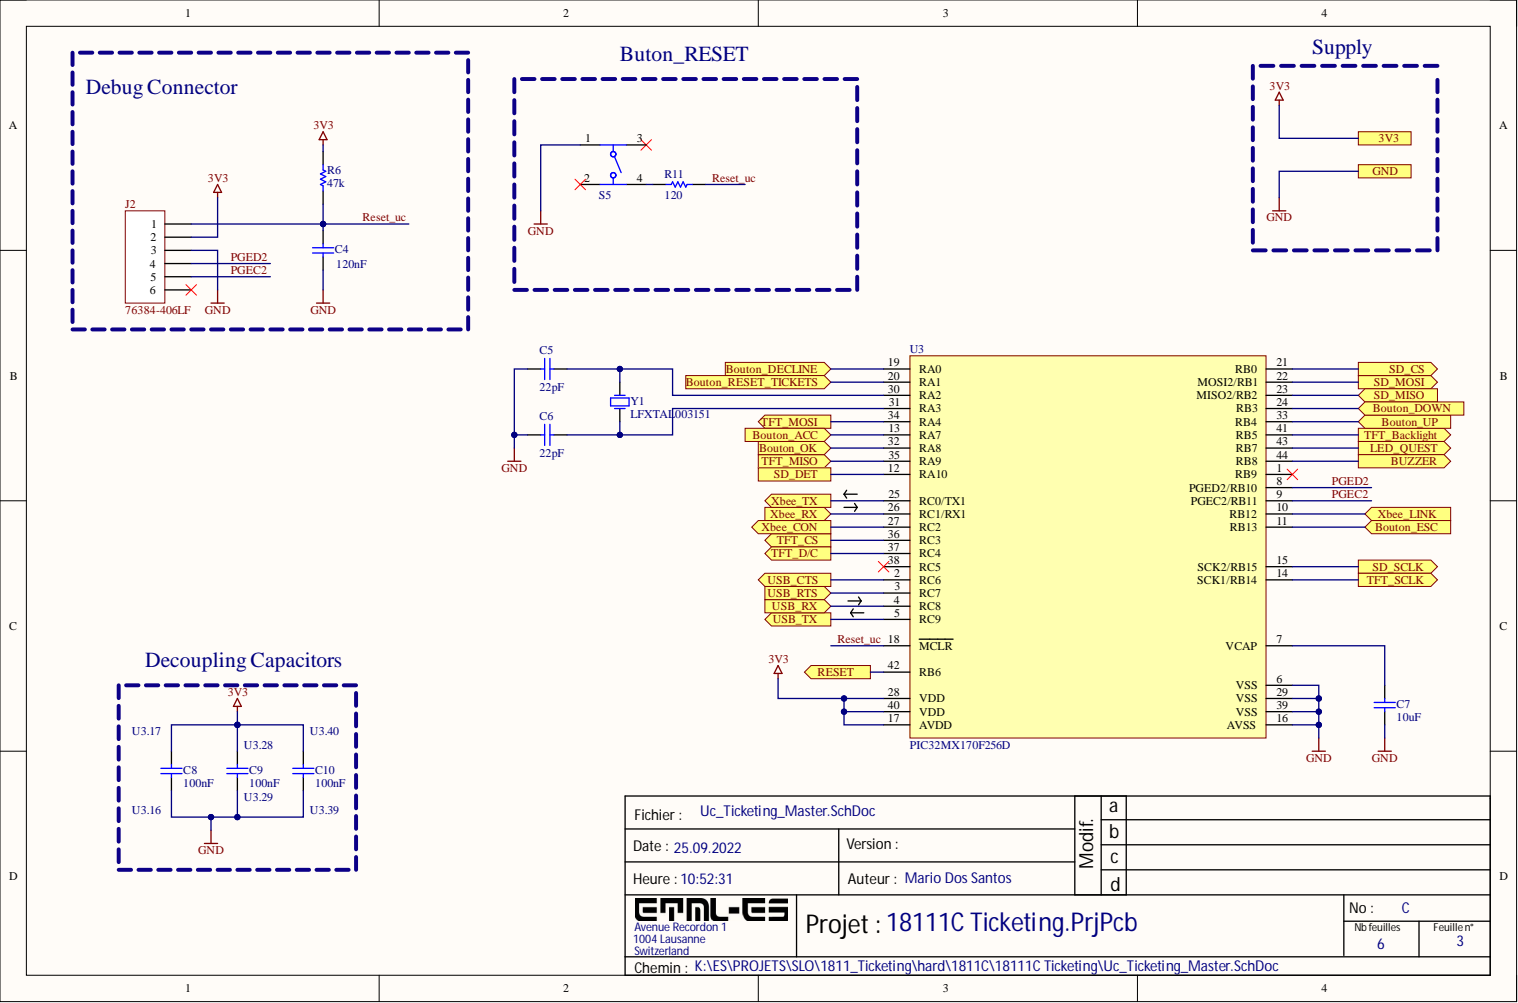
[picture p130: page 3]

Y 1 3 1
LFX TA L 0 0 3 1 5 1 TFT _MO S I | 3 4

2 9

4 0 | 3 9
1 7

Uc_Ticketing_Master. SchDoc Fichier :

Date : 25.09.2022 | Version :

Heure : 10:52:31 | Mario Dos Santos Auteur :
Avenue Recordon 1 1004 Lausanne Switzerland | Projet : 18111C Ticketing.PrjPcb | No : C

Nb feui l l es | F eui l l e n°

S\PROJETS\SLO\1811_Ticketing\hard\1811C\18111C Ticketing\Uc_Ticketing_Master.

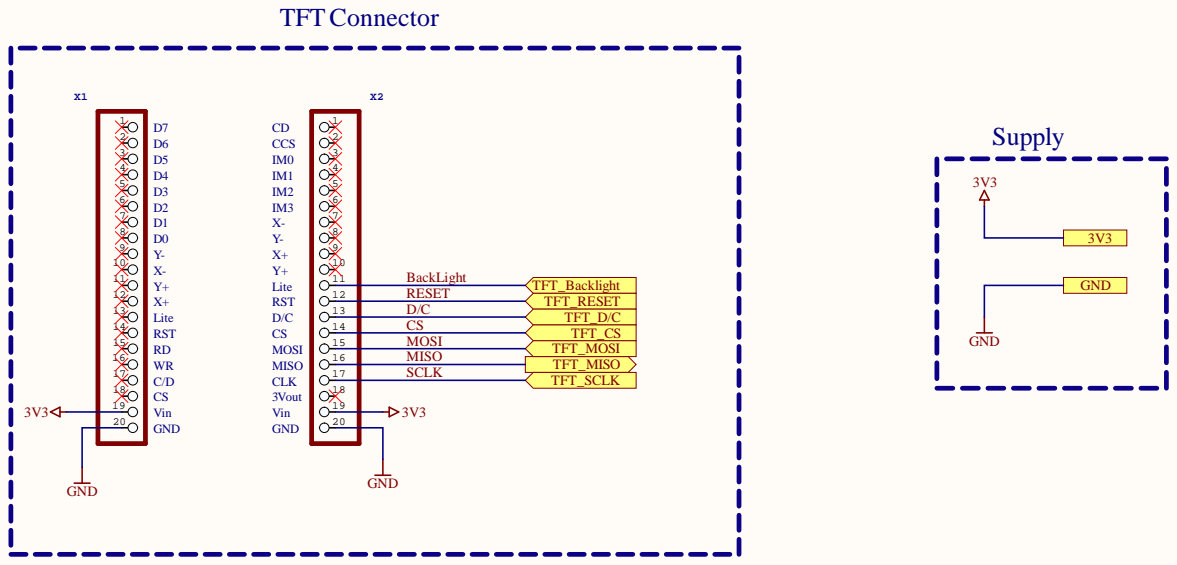
[picture p131: page 4]

T FT_Ticketing_Master. SchDoc Fichier :

Date : 25.09.2022 | Version :

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

Nb feui l l es | F eui l l e n°

S\PROJETS\SLO\1811_Ticketing\hard\1811C\18111C Ticketing\T

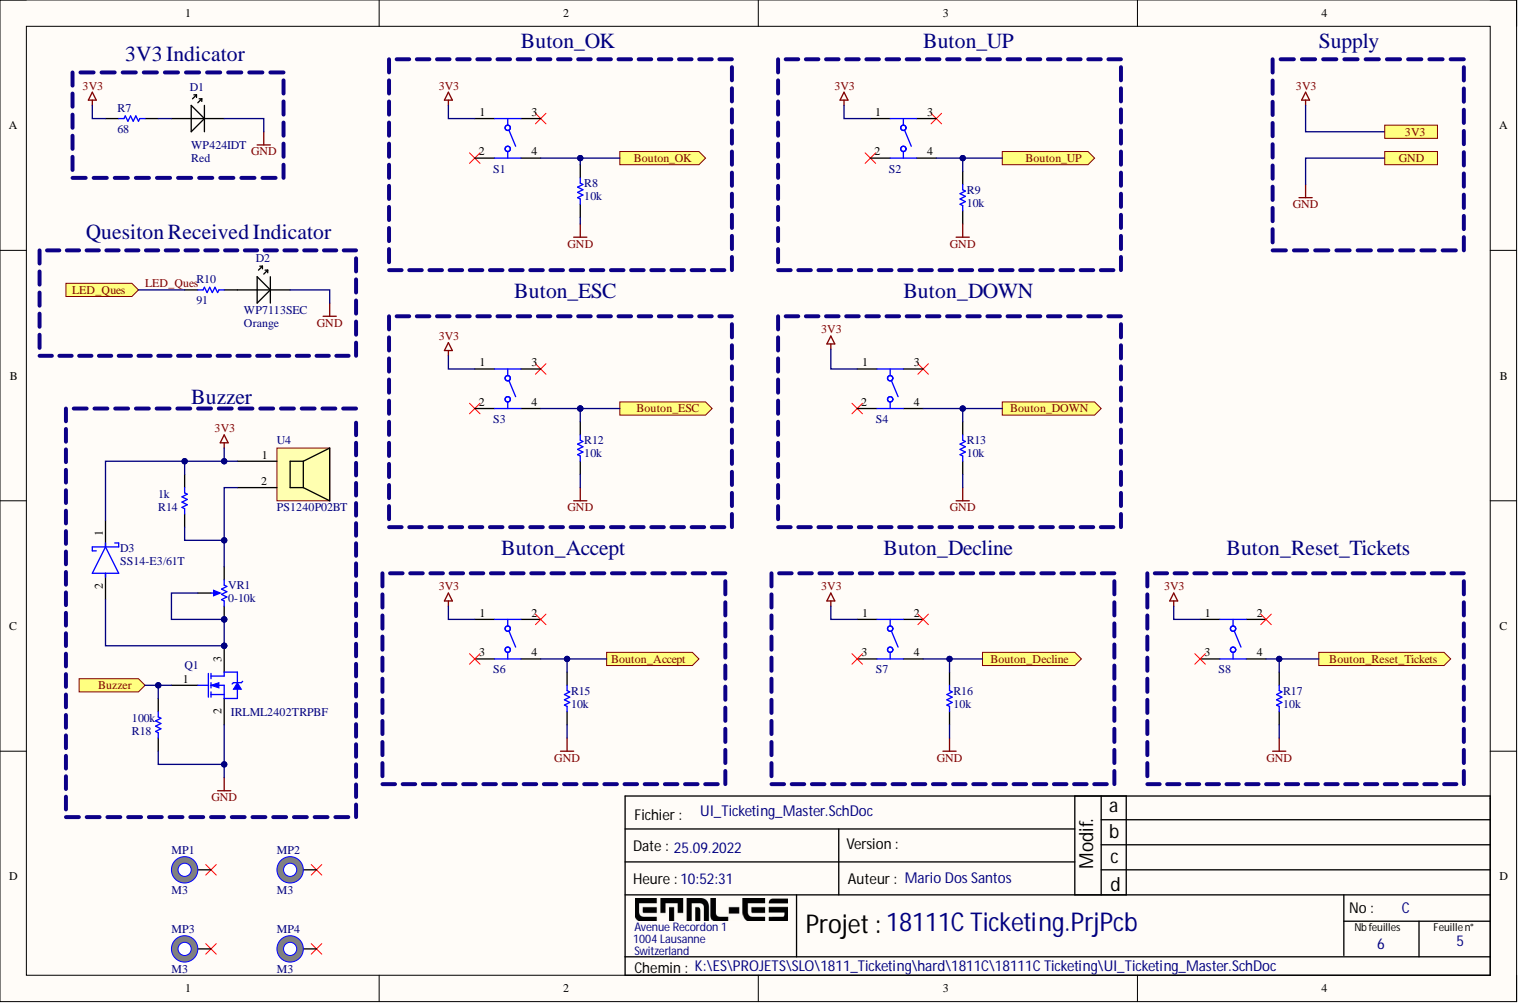
[picture p132: page 5]

UI_Ticketing_Master.SchDoc Fichier : | | a

Date : 25.09.2022 | Version :

Heure : 10:52:31 | Mario Dos Santos Auteur :

Projet : 18111C Ticketing.PrjPcb | No : C

Chemin : K:\ES\PROJETS\SLO\1811_Ticketing\hard\1811C\18111C Ticketing\UI_Ticketing_Master.SchDoc

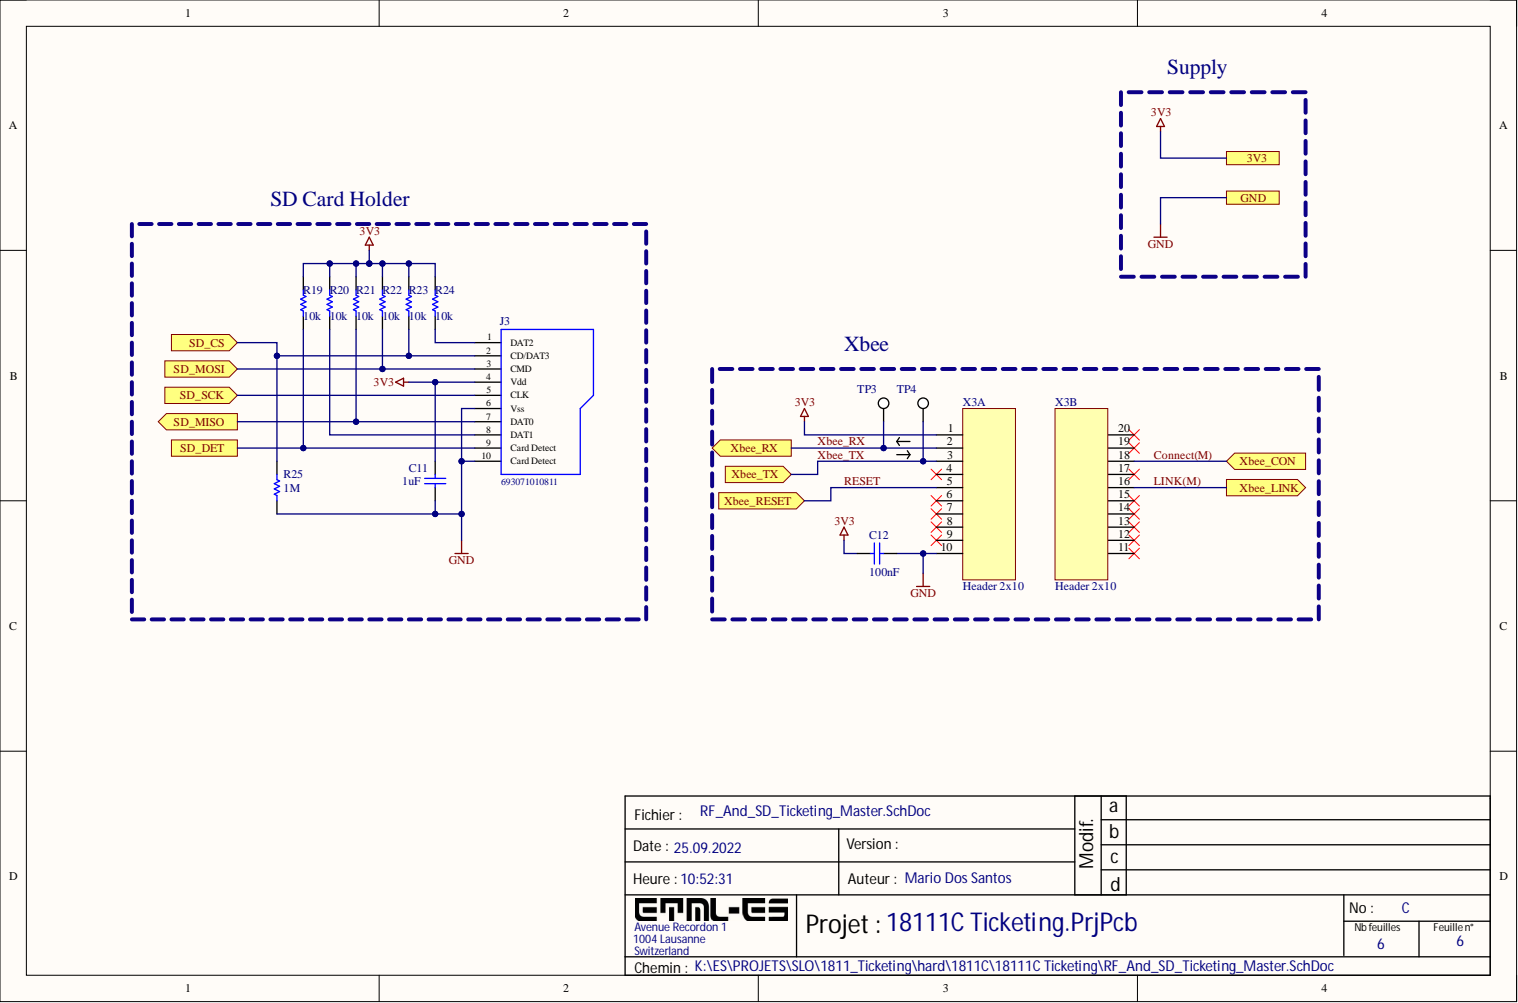
[picture p133: page 6]

CMD 3
Vdd 4
CLK 5
Vss 6

DAT1 8

RF_And_SD_Ticketing_Master.SchDoc Fichier : | | a

Date : 25.09.2022 | Version :

Heure : 10:52:31 | Mario Dos Santos Auteur :

Projet : 18111C Ticketing.PrjPcb | No : C

Chemin : K:\ES\PROJETS\SLO\1811_Ticketing\hard\1811C\18111C Ticketing\RF_And_SD_Ticketing_Master.SchDoc
