ETML-ES-SLO/PRJ_1811_Ticketing-/doc/1811_C/PDF/Nouveau dossier/Schematic Prints Slave.PDF

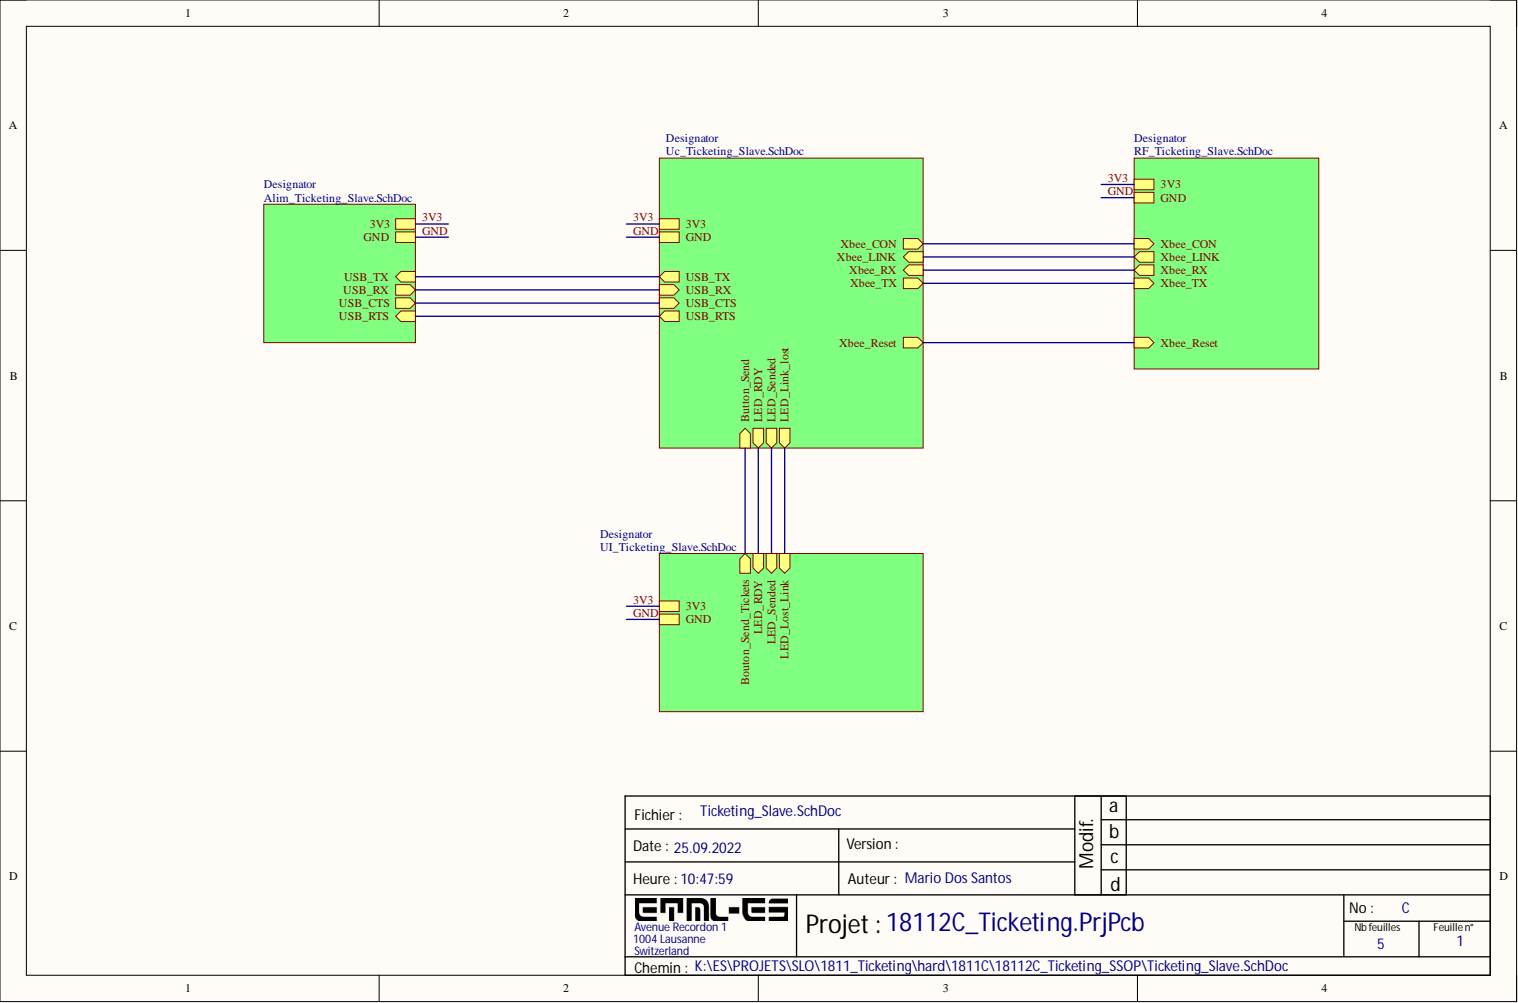
[picture p134: page 1]

Ticketing_Slave.SchDoc Fichier : | | a

Date : 25.09.2022 | Version :

Heure : 10:47:59 | Mario Dos Santos Auteur :
Avenue Recordon 1 1004 Lausanne Switzerland | Projet : 18112C_Ticketing.PrjPcb | No : C

Nb feuilles | Feuille n°

Chemin : K:\ES\PROJETS\SLO\1811_Ticketing\hard\1811C\18112C_Ticketing_SSOP\Ticketing_Slave.SchDoc

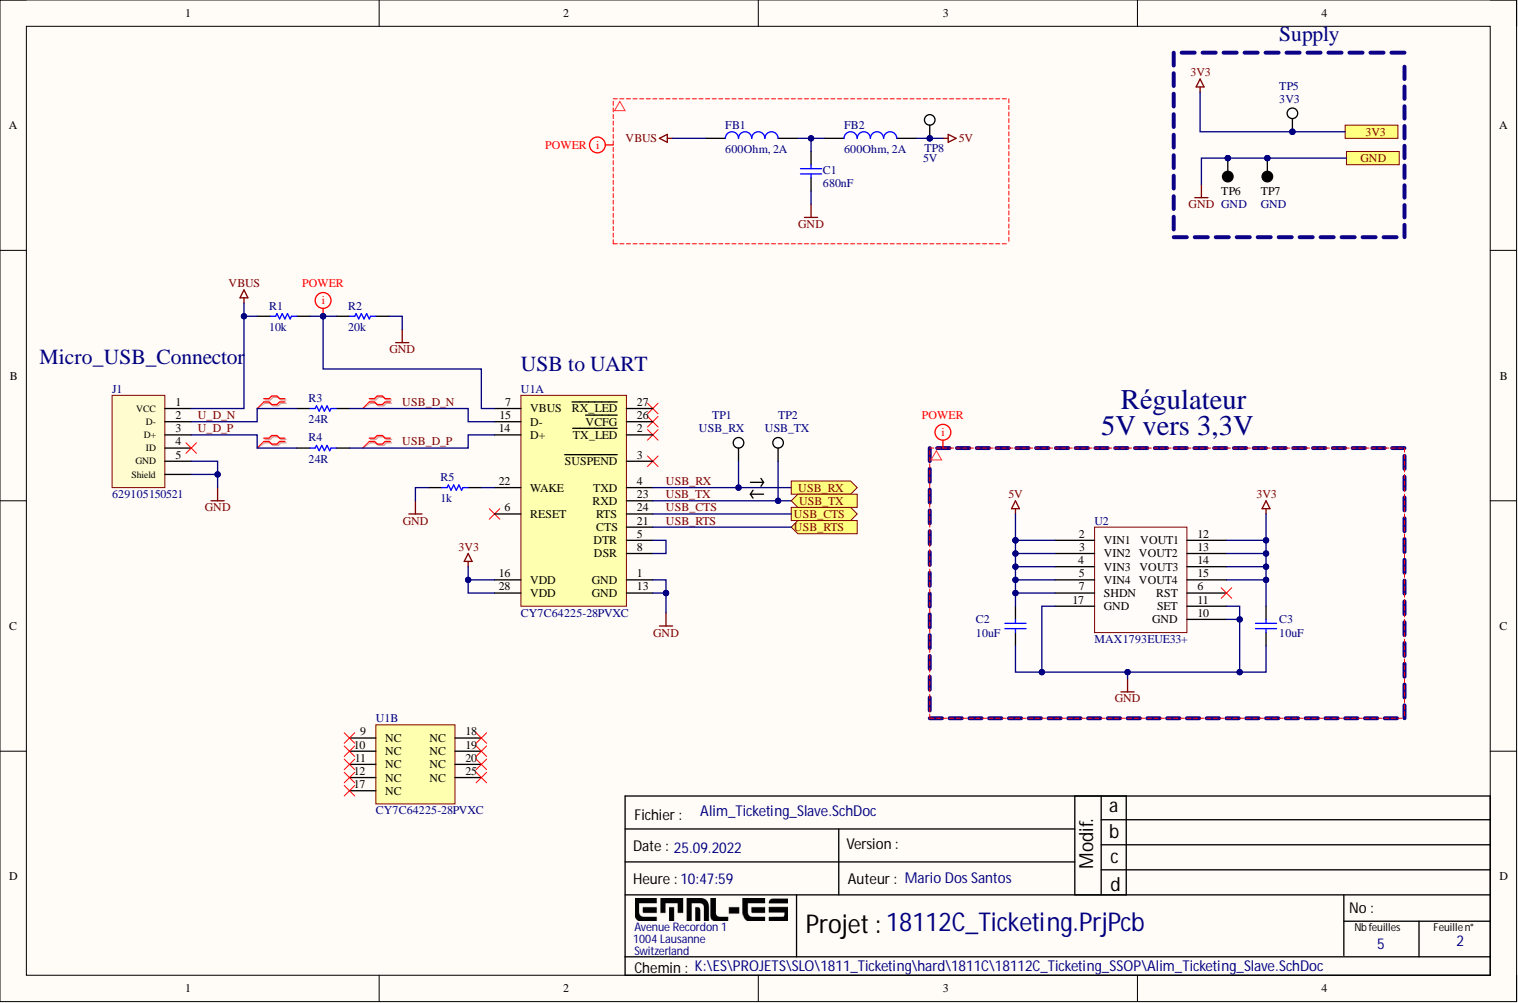
[picture p135: page 2]

Alim_Ticketing_Slave.SchDoc Fichier : | | a

Date : 25.09.2022 | Version :

Heure : 10:47:59 | Mario Dos Santos Auteur :

Projet : 18112C_Ticketing.PrjPcb | No :

Chemin : K:\ES\PROJETS\SLO\1811_Ticketing\hard\1811C\18112C_Ticketing_SSOP\Alim_Ticketing_Slave.SchDoc

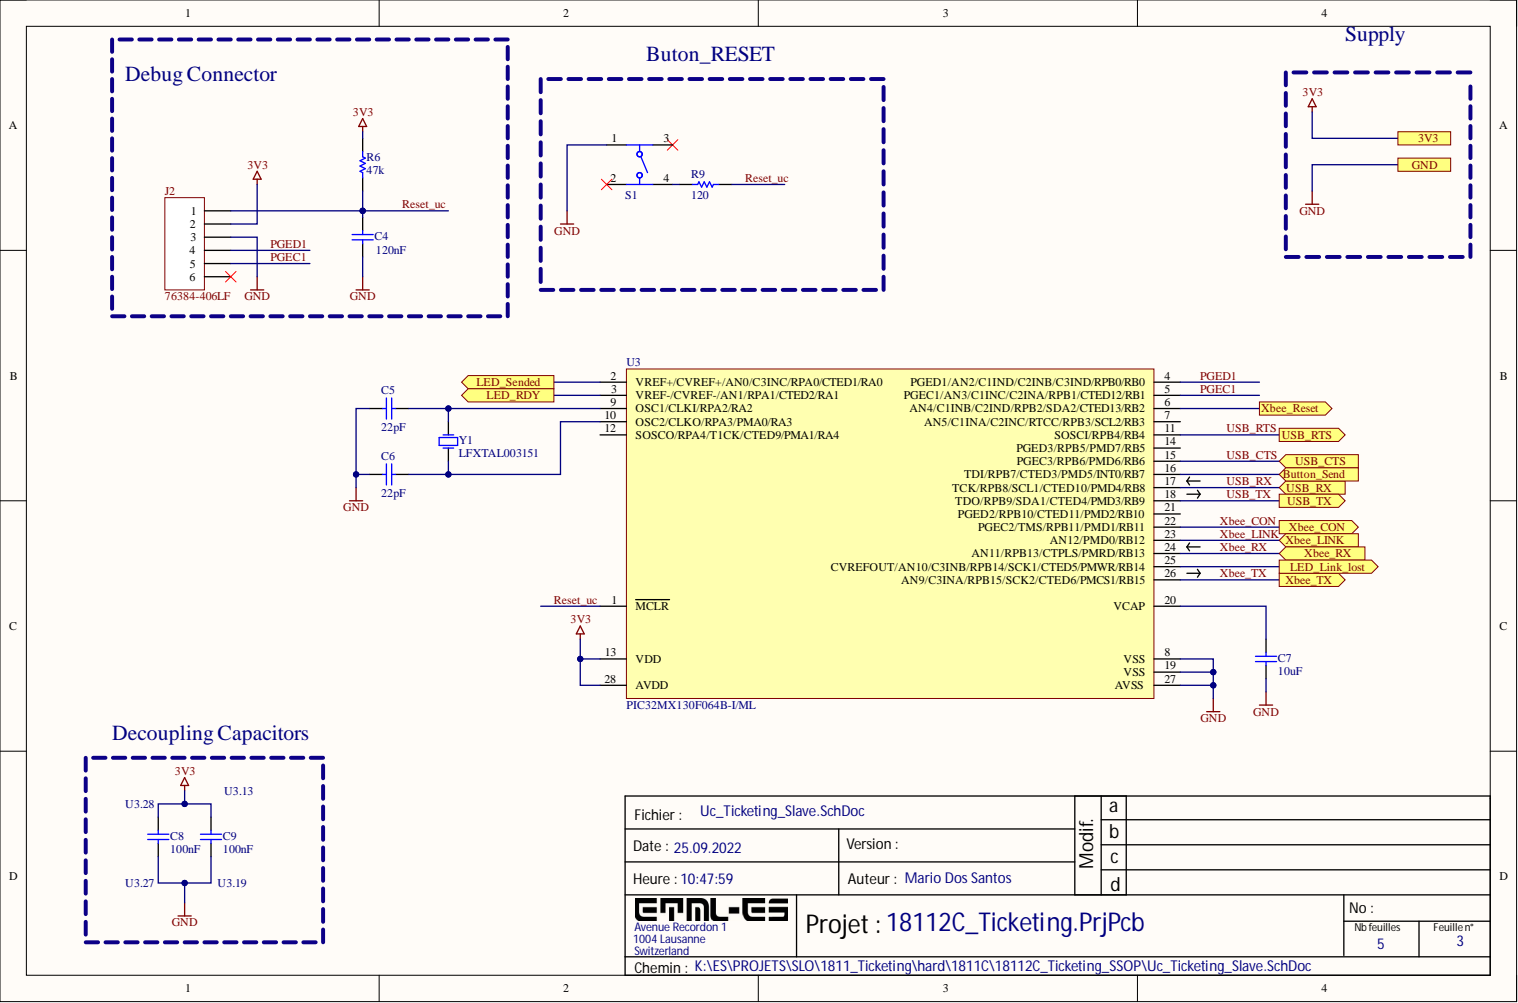
[picture p136: page 3]

1 0
1 2

Uc_Ticketing_Slave. SchDoc Fichier :

Date : 25.09.2022 | Version :

Heure : 10:47:59 | Mario Dos Santos Auteur :
Avenue Re cordon 1 | Projet : 18112C_Ticketing.Prj Pcb | No :

Nb feui l l es | F eui l l e n°

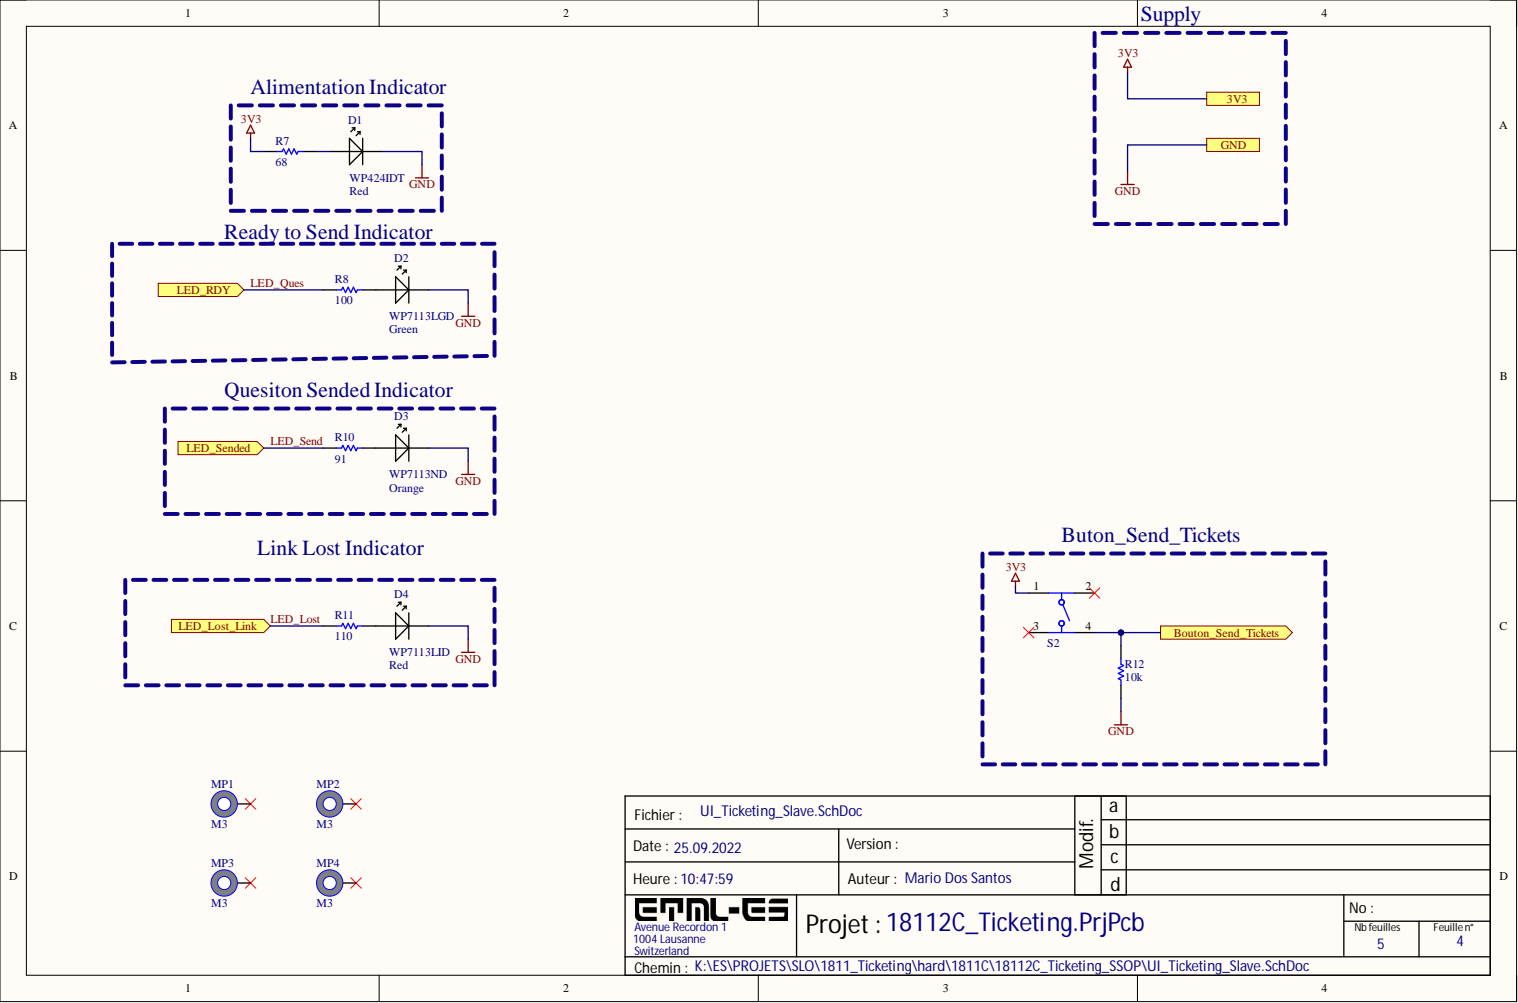
[picture p137: page 4]

Ready to Send Indicator

UI_Ticketing_Slave.SchDoc Fichier : | | a

Date : 25.09.2022 | Version :

Heure : 10:47:59 | Mario Dos Santos Auteur :

Projet : 18112C_Ticketing.PrjPcb | No :

Chemin : K:\ES\PROJETS\SLO\1811_Ticketing\hard\1811C\18112C_Ticketing_SSOP\UI_Ticketing_Slave.SchDoc

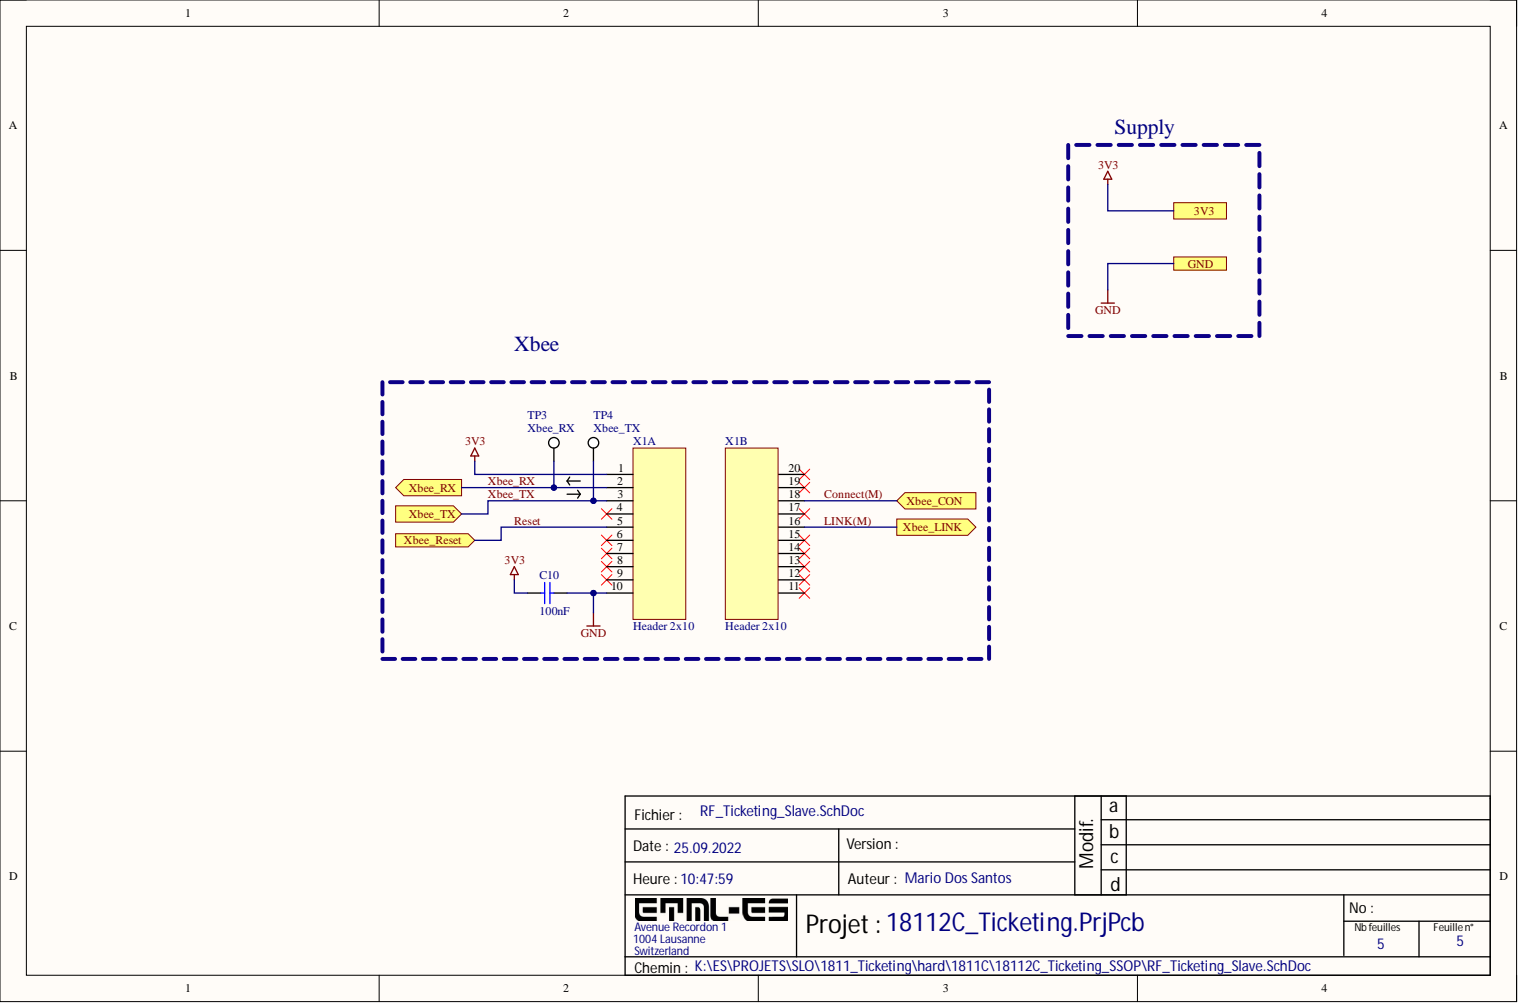
[picture p138: page 5]

RF_Ticketing_Slave.SchDoc Fichier : | | a

Date : 25.09.2022 | Version :

Heure : 10:47:59 | Mario Dos Santos Auteur :

Projet : 18112C_Ticketing.PrjPcb | No :

Chemin : K:\ES\PROJETS\SLO\1811_Ticketing\hard\1811C\18112C_Ticketing_SSOP\RF_Ticketing_Slave.SchDoc
