ETML-ES-SLO/PRJ_1811_Ticketing-/doc/1811_C/PDF/Nouveau dossier/Controleur USB_UART.pdf

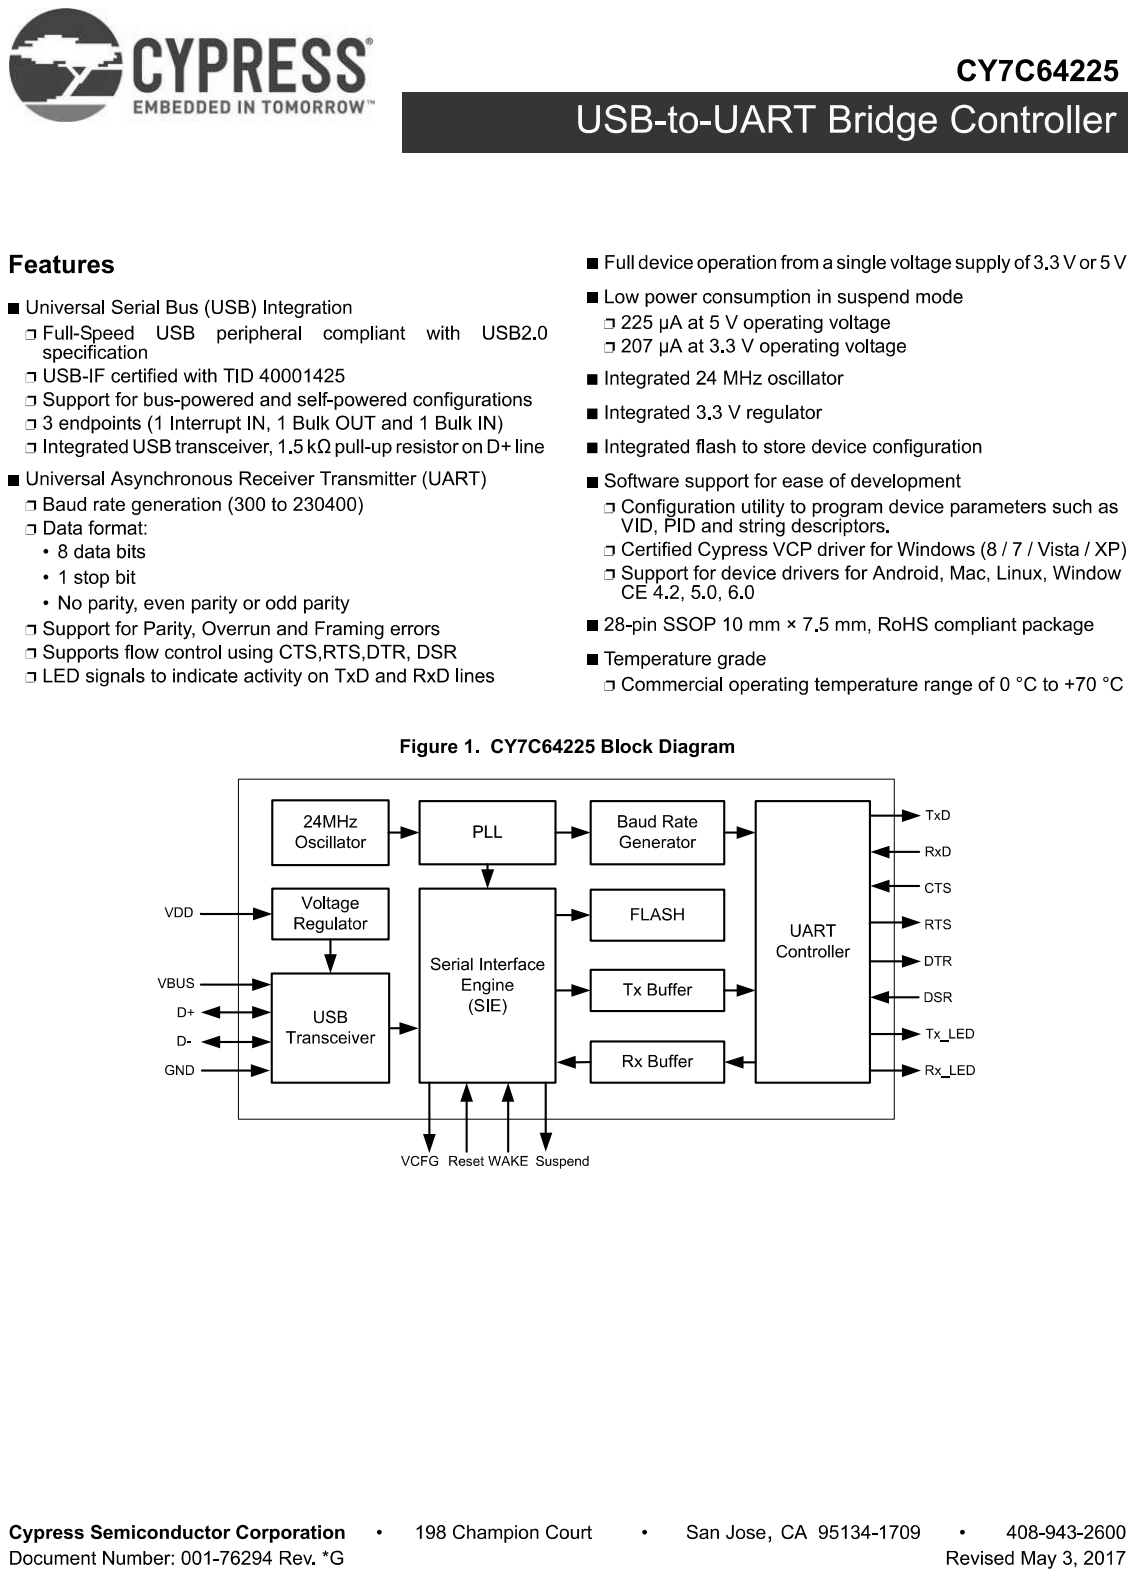
[picture p139: page 1]

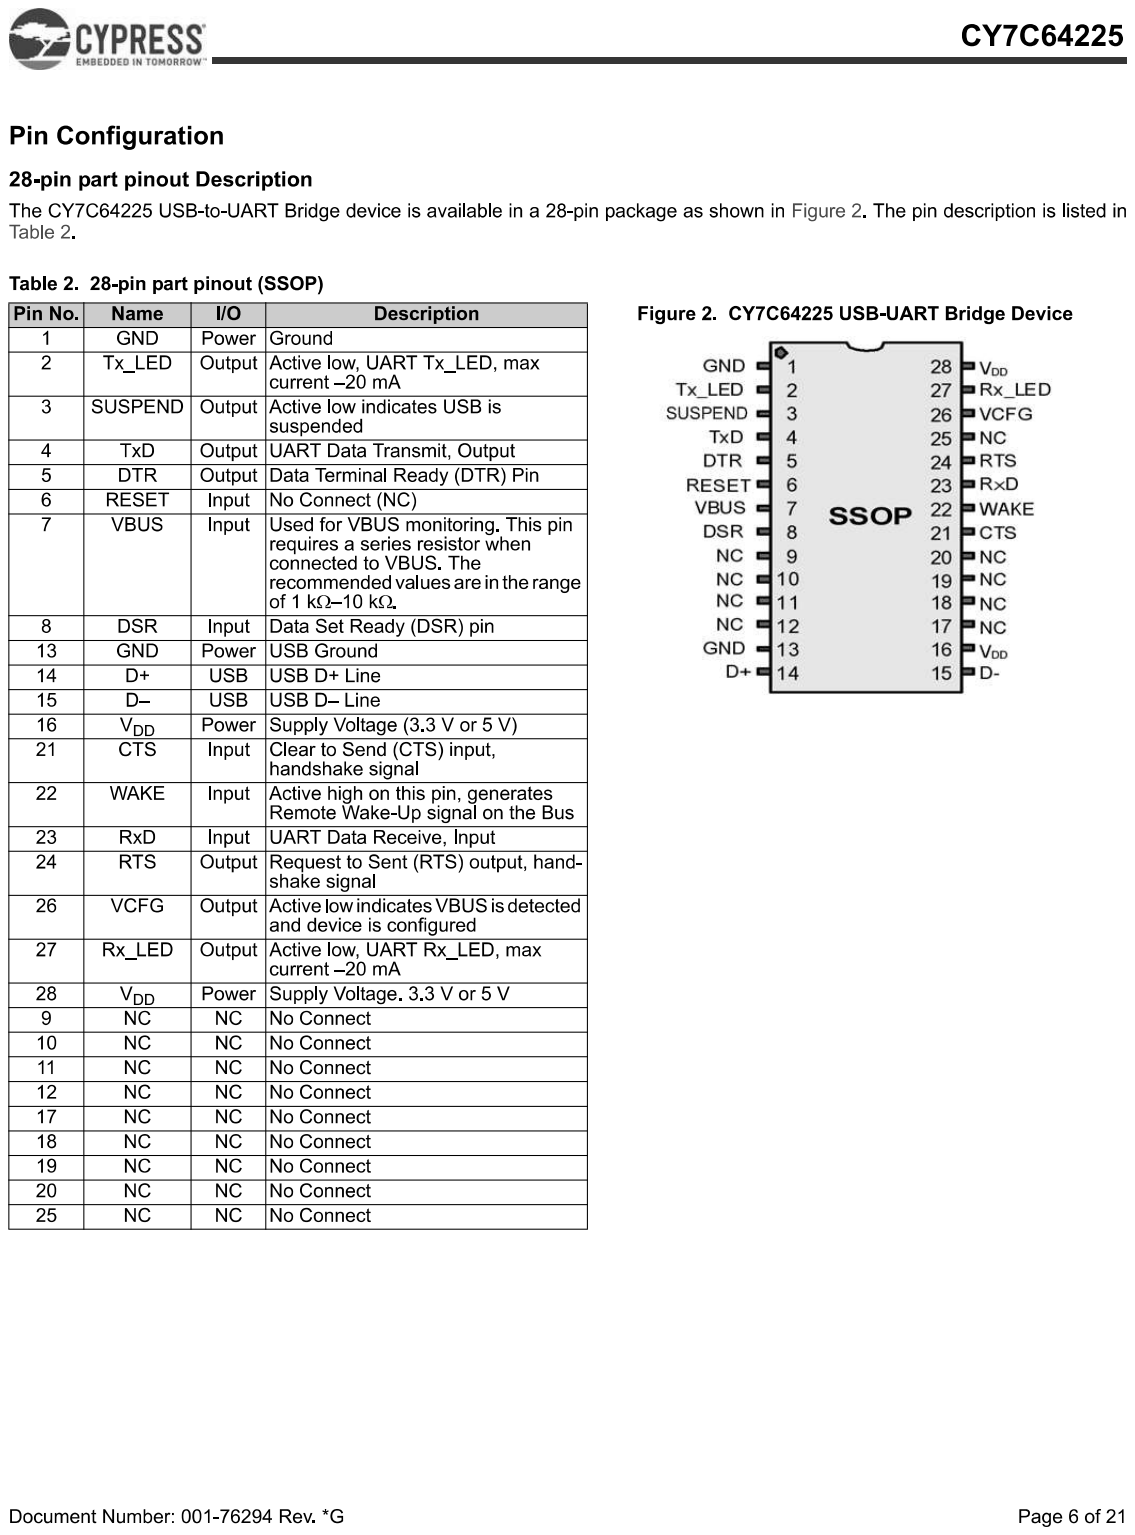
[picture p140: page 2]

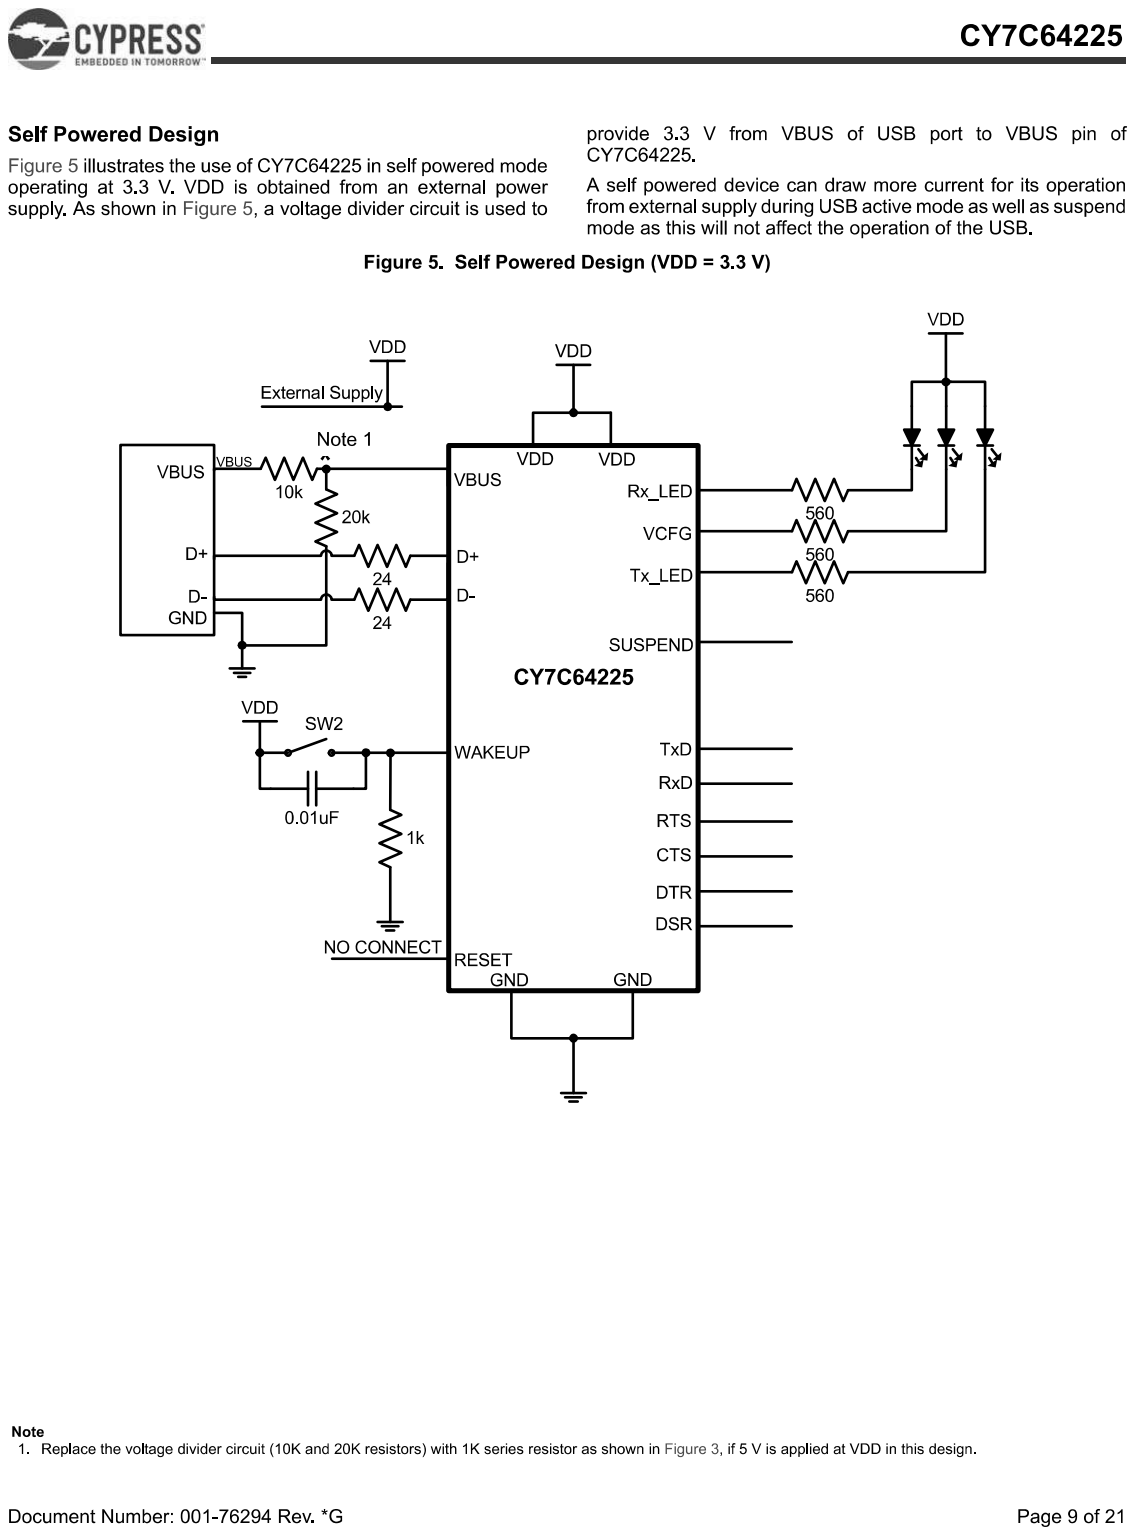
[picture p141: page 3]
