ETML-ES-SLO/PRJ_1811_Ticketing-/doc/1811_C/PDF/Nouveau dossier/Ecran TFT.pdf

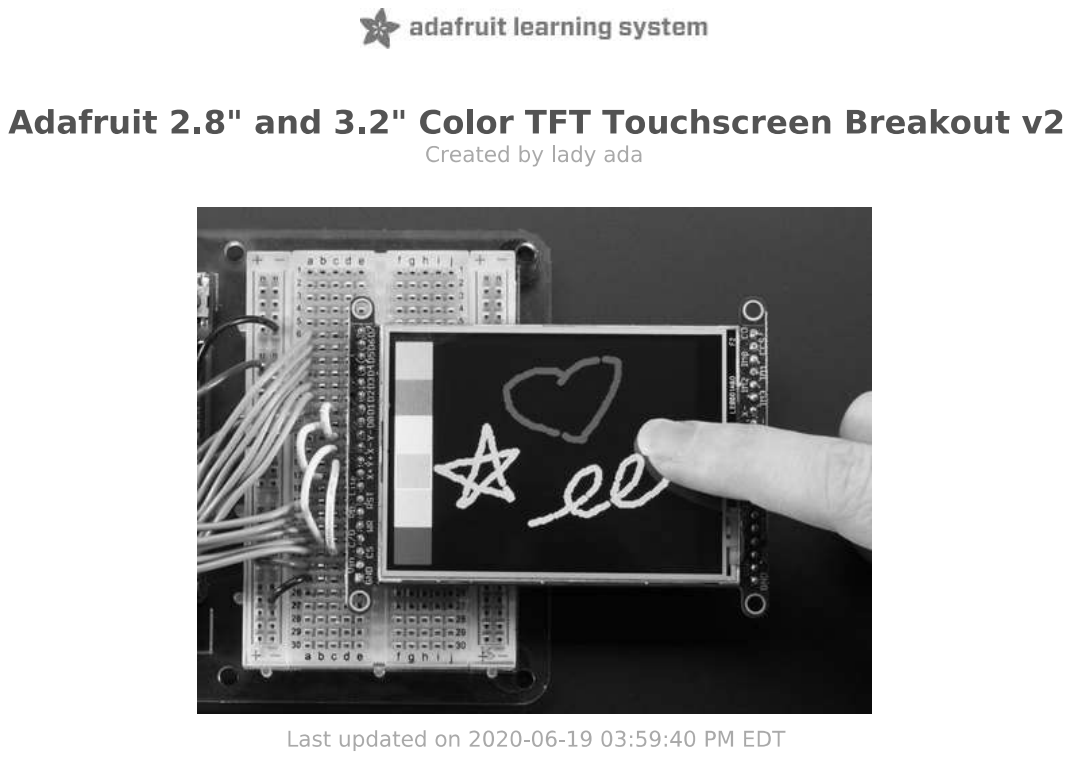
[picture p142: page 1]

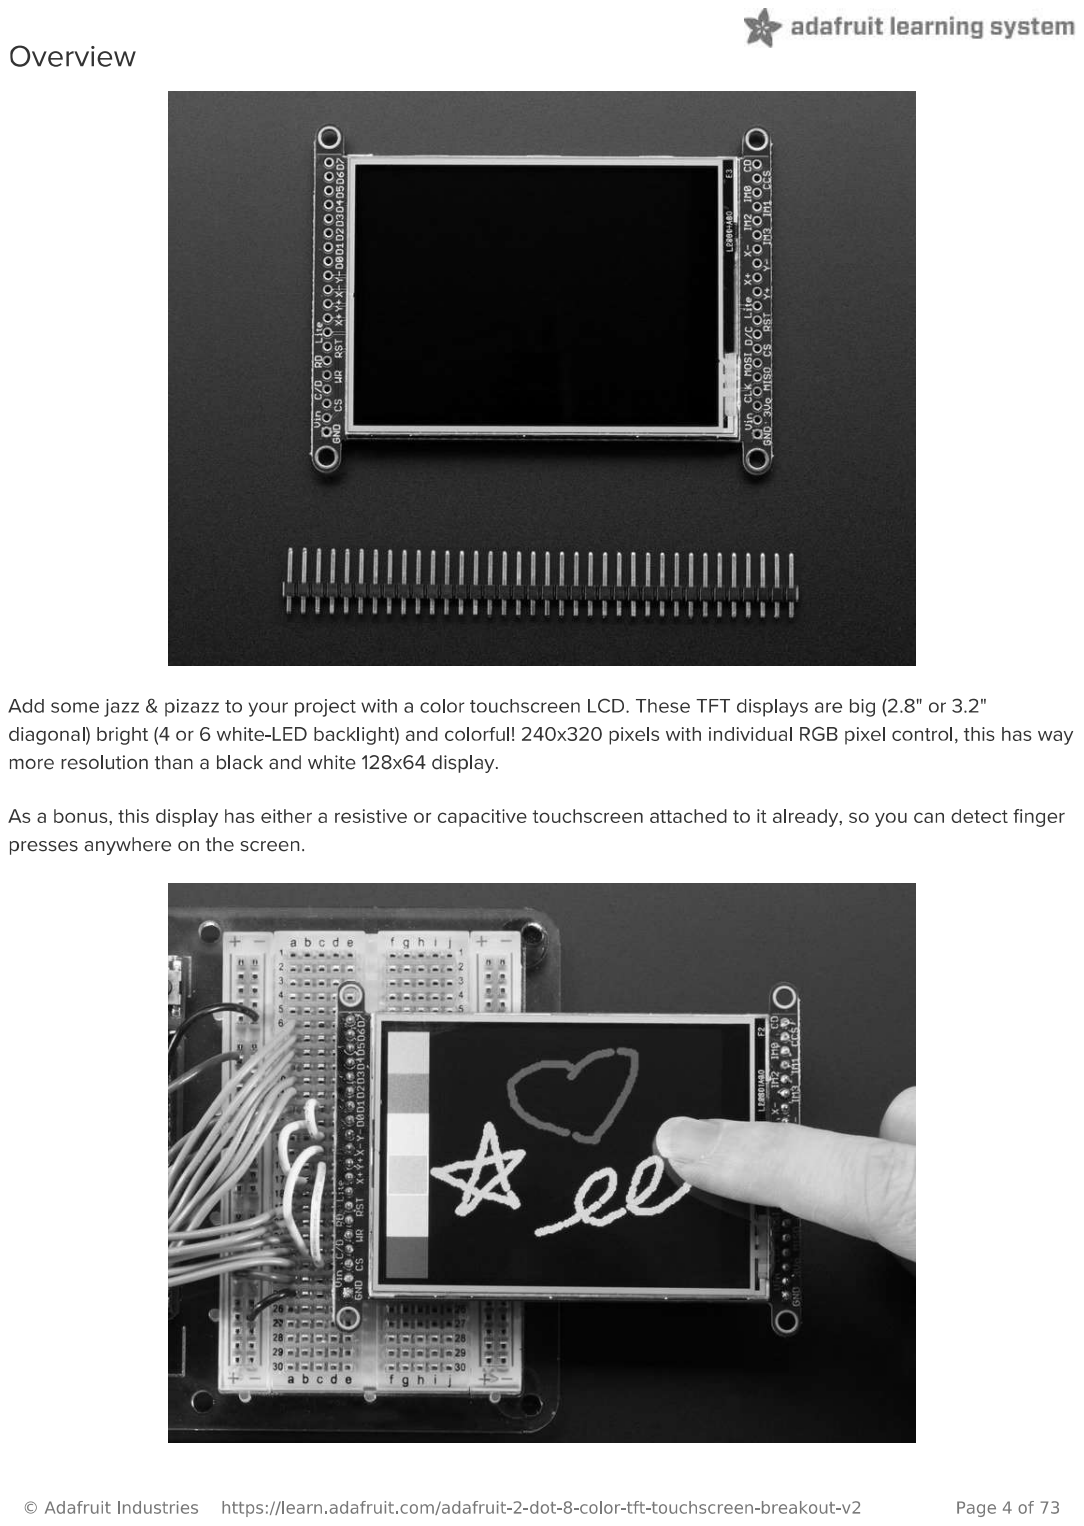
[picture p143: page 2]

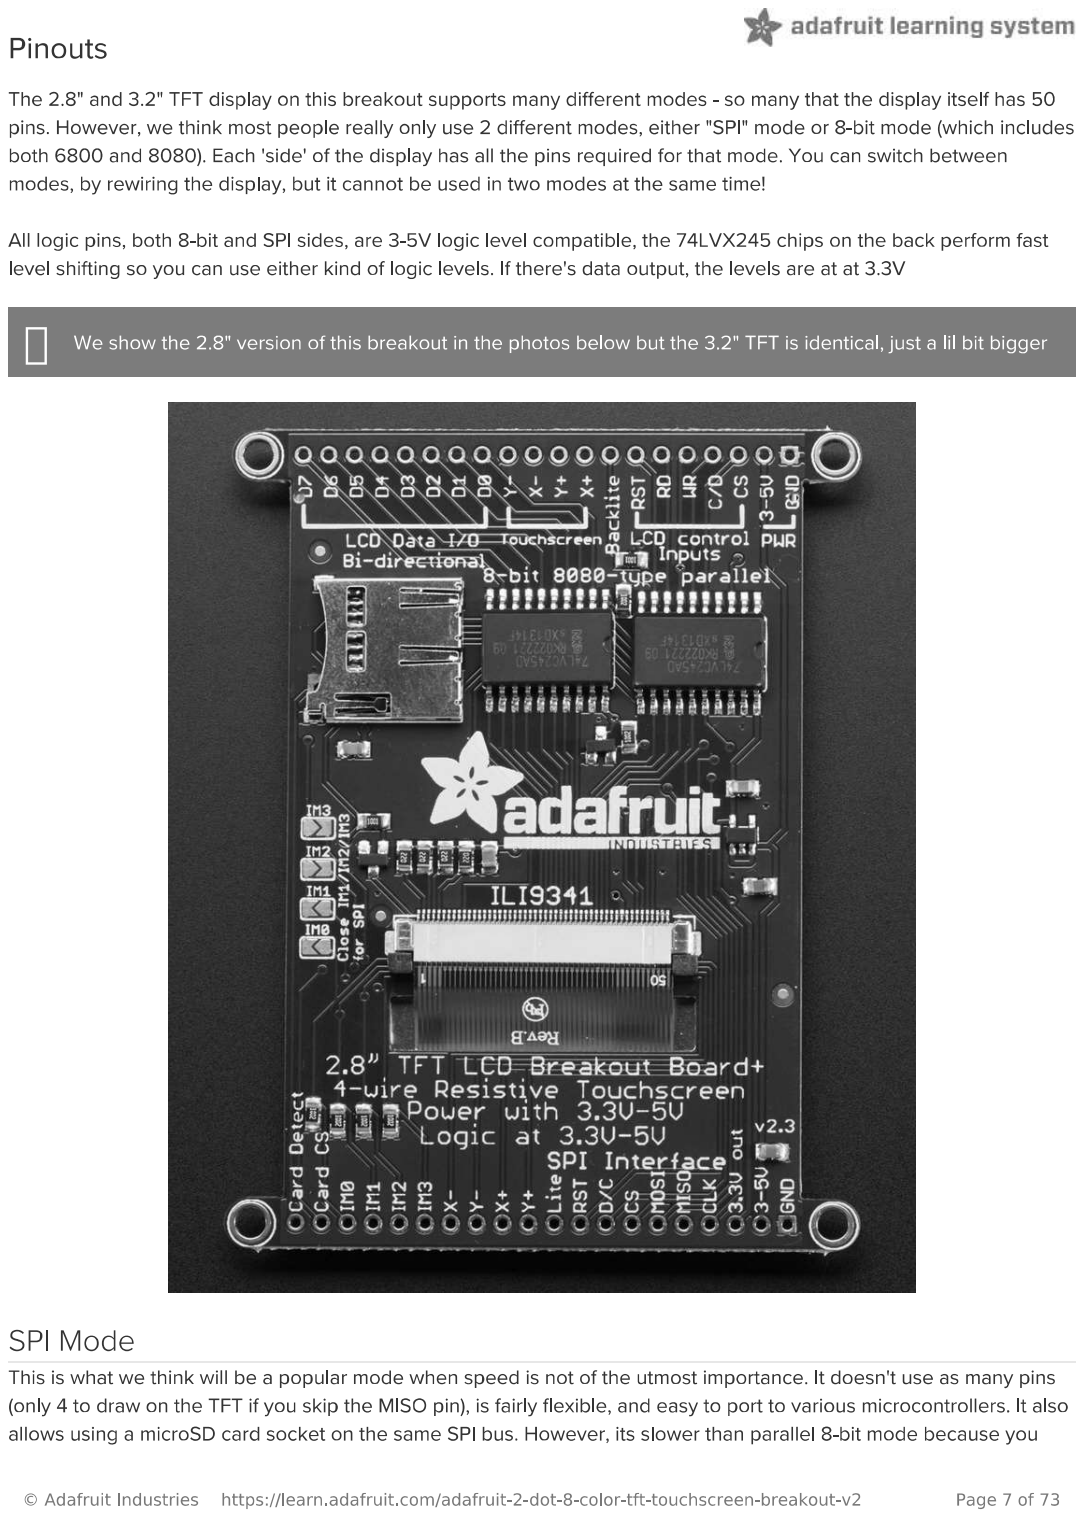
[picture p144: page 3]

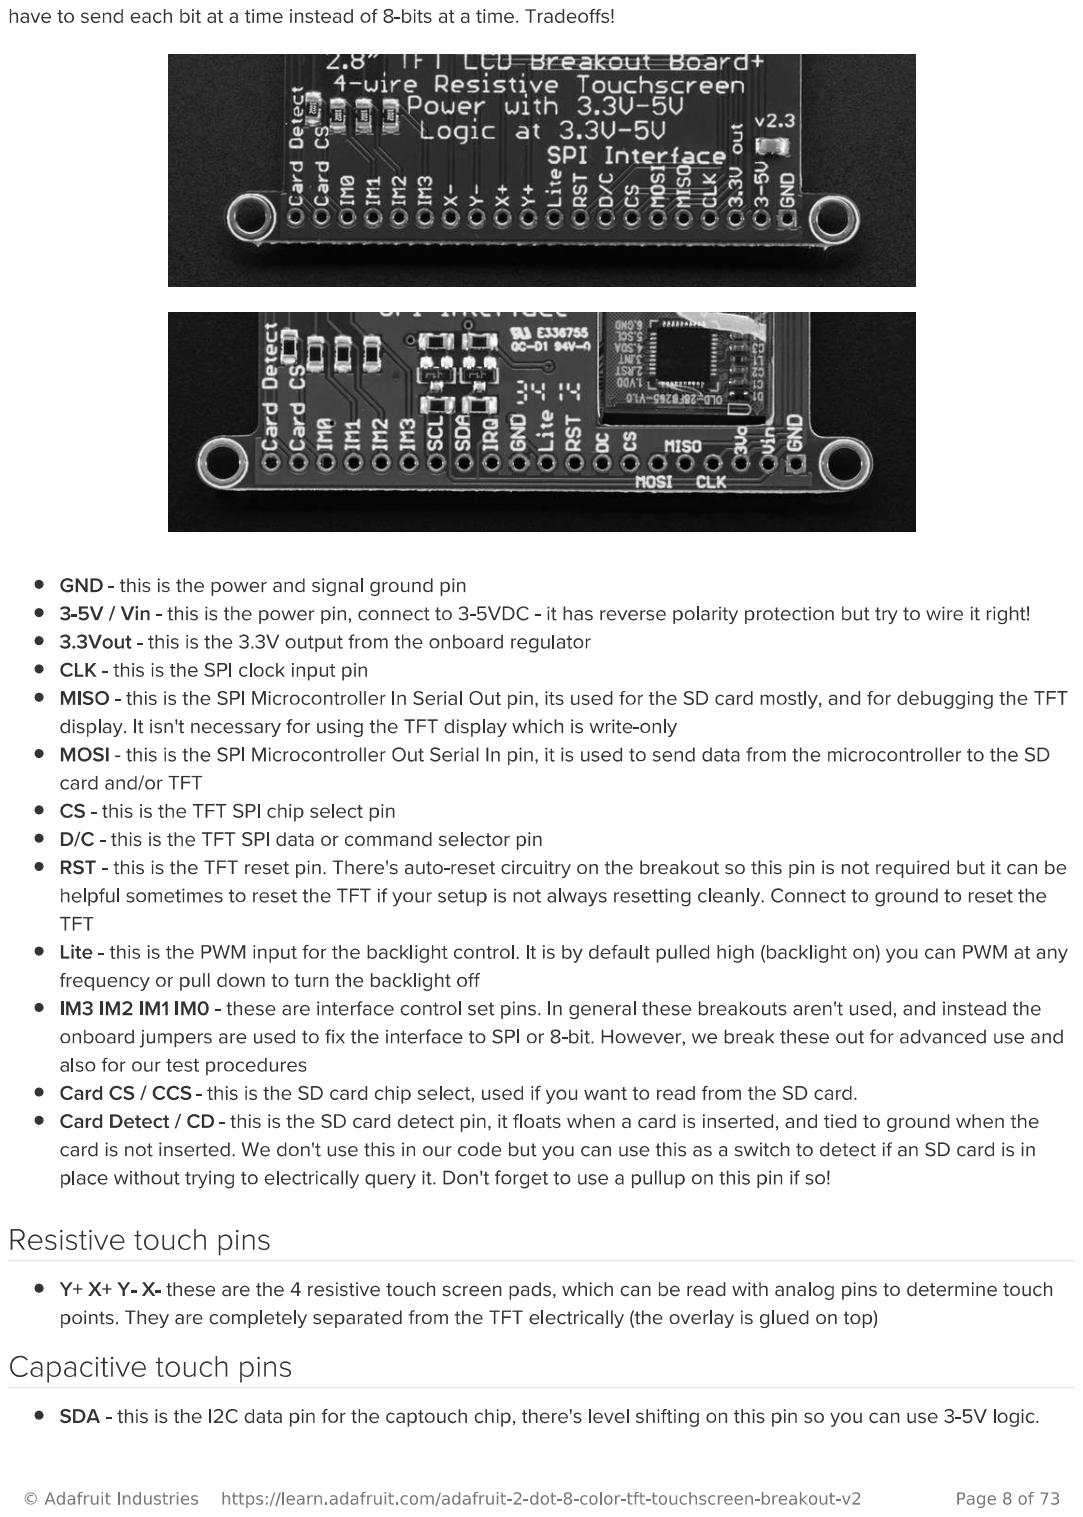
[picture p145: page 4]

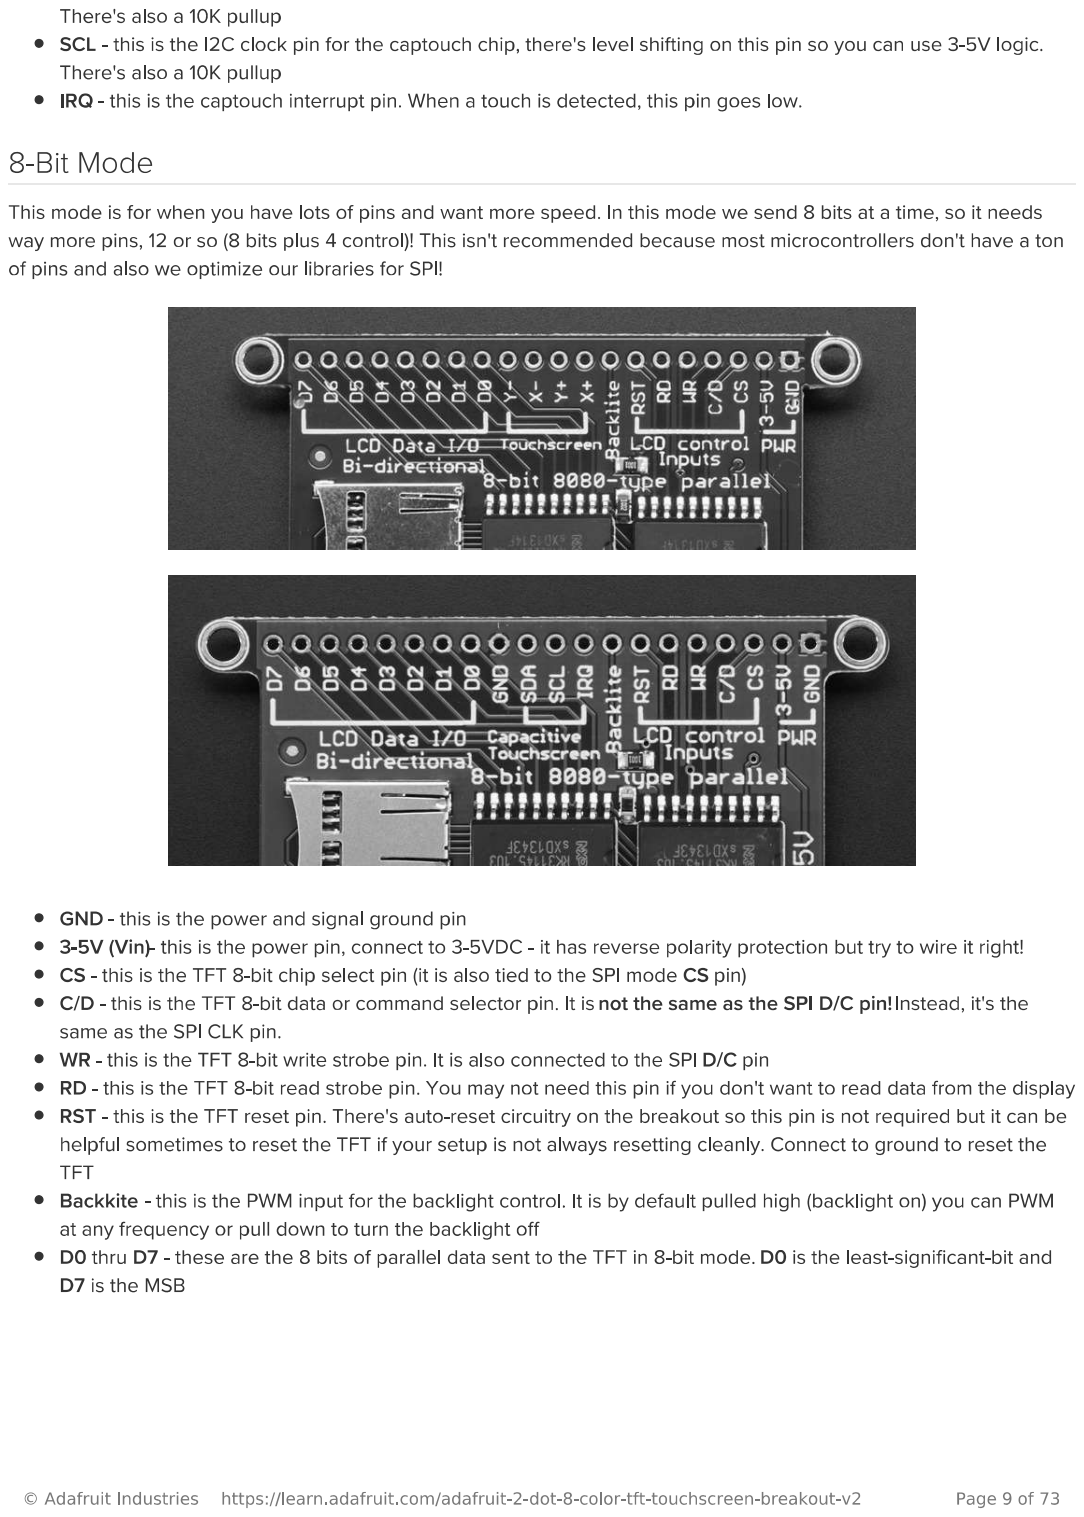
[picture p146: page 5]
