ETML-ES-SLO/PRJ_1811_Ticketing-/doc/1811_C/PDF/Nouveau dossier/LED alim.pdf

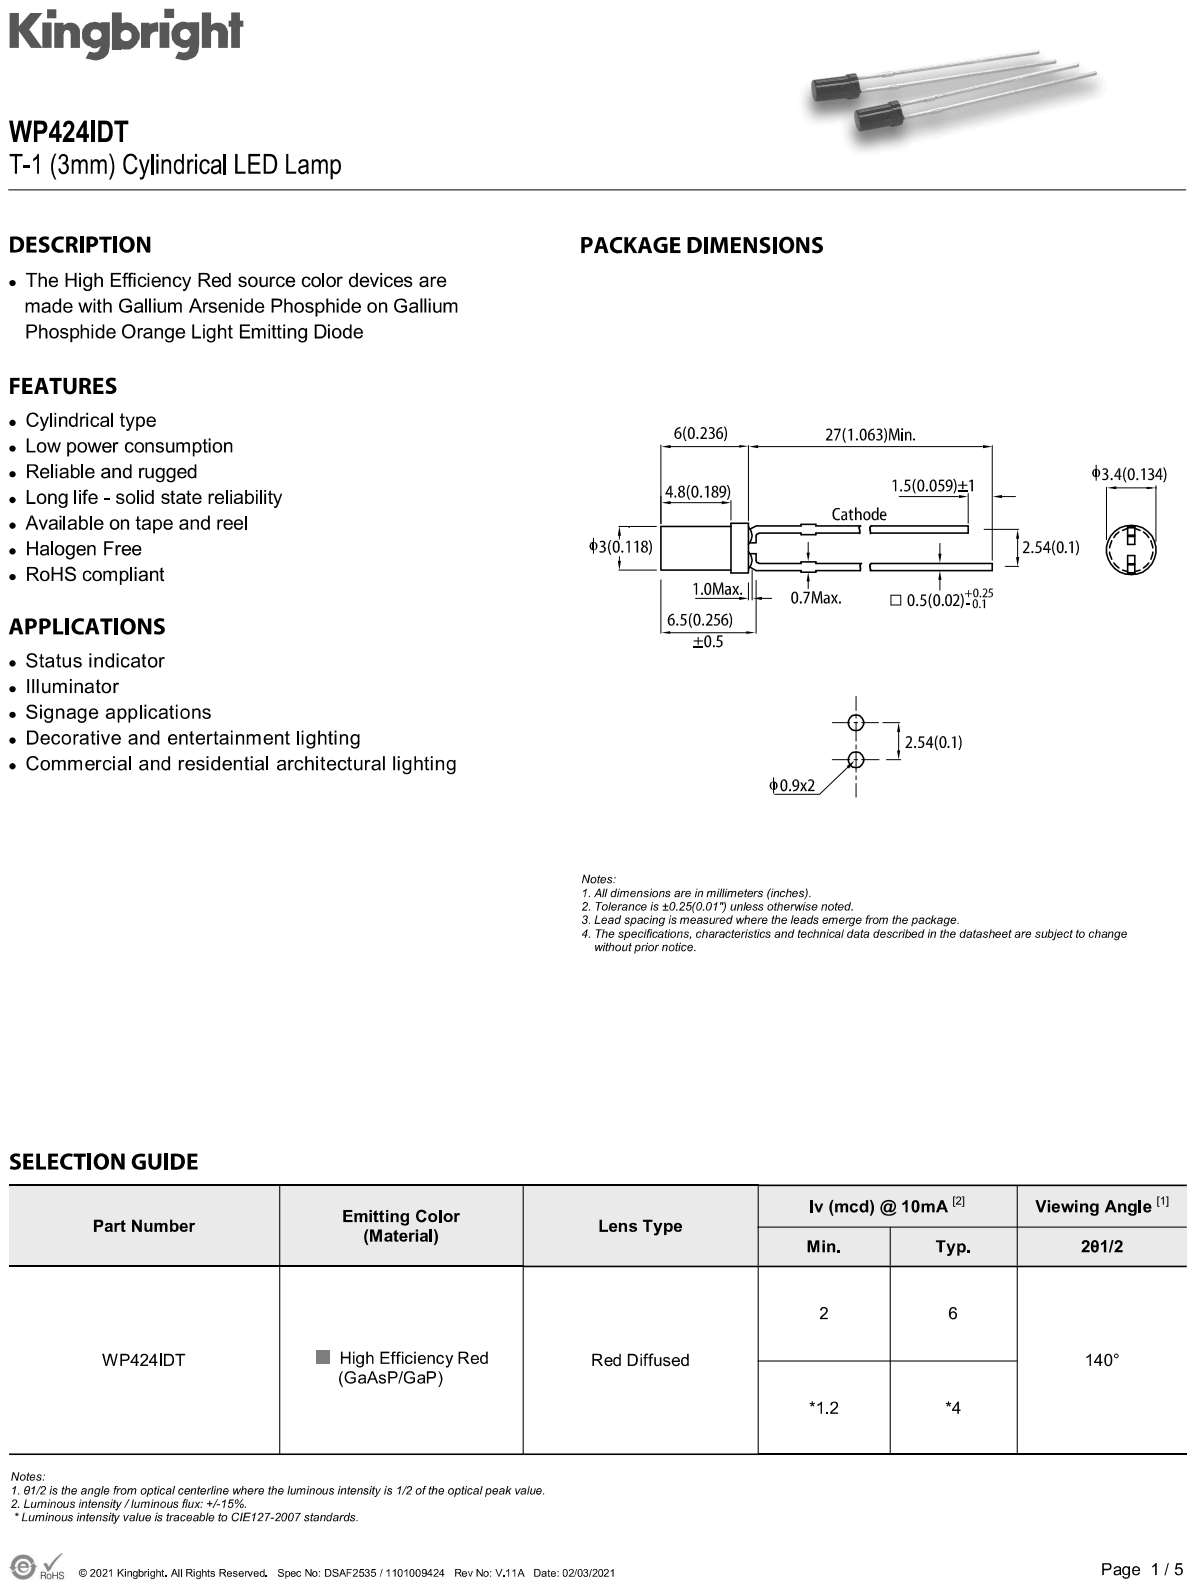
[picture p147: page 1]

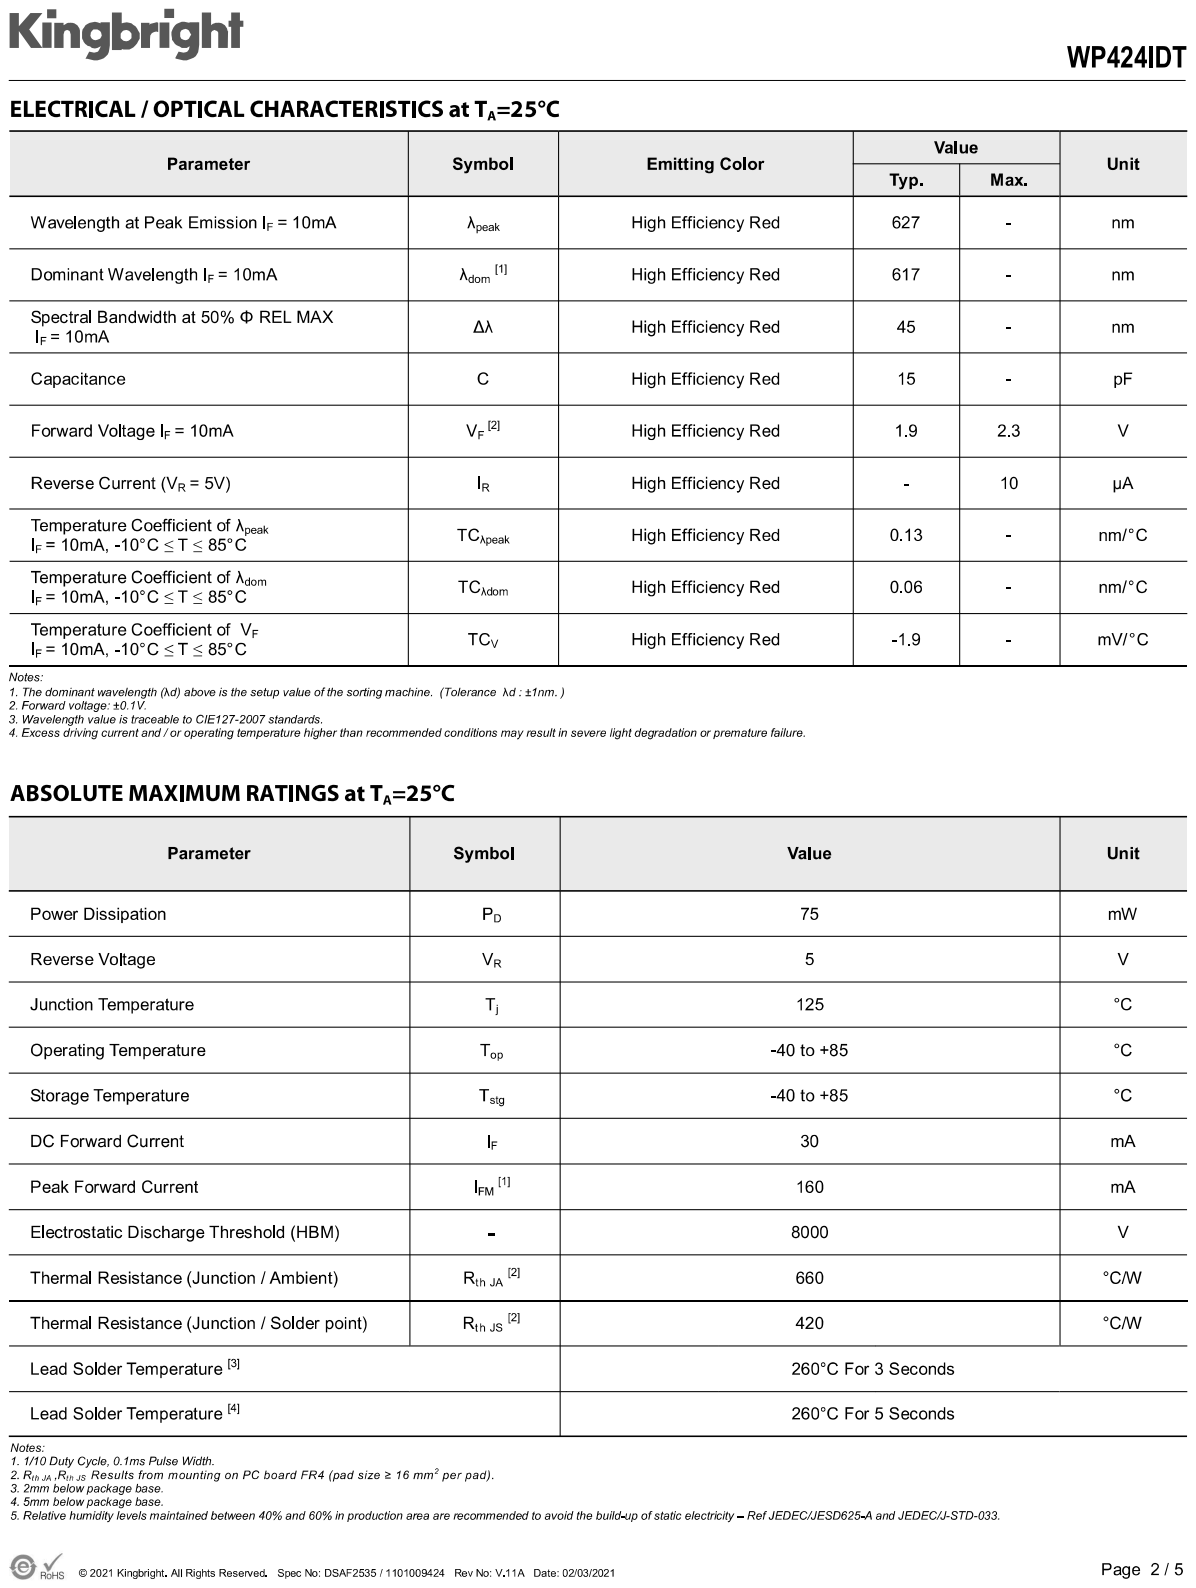
[picture p148: page 2]
