ETML-ES-SLO/PRJ_1811_Ticketing-/doc/1811_C/PDF/Nouveau dossier/LED orange (SLAVE).pdf

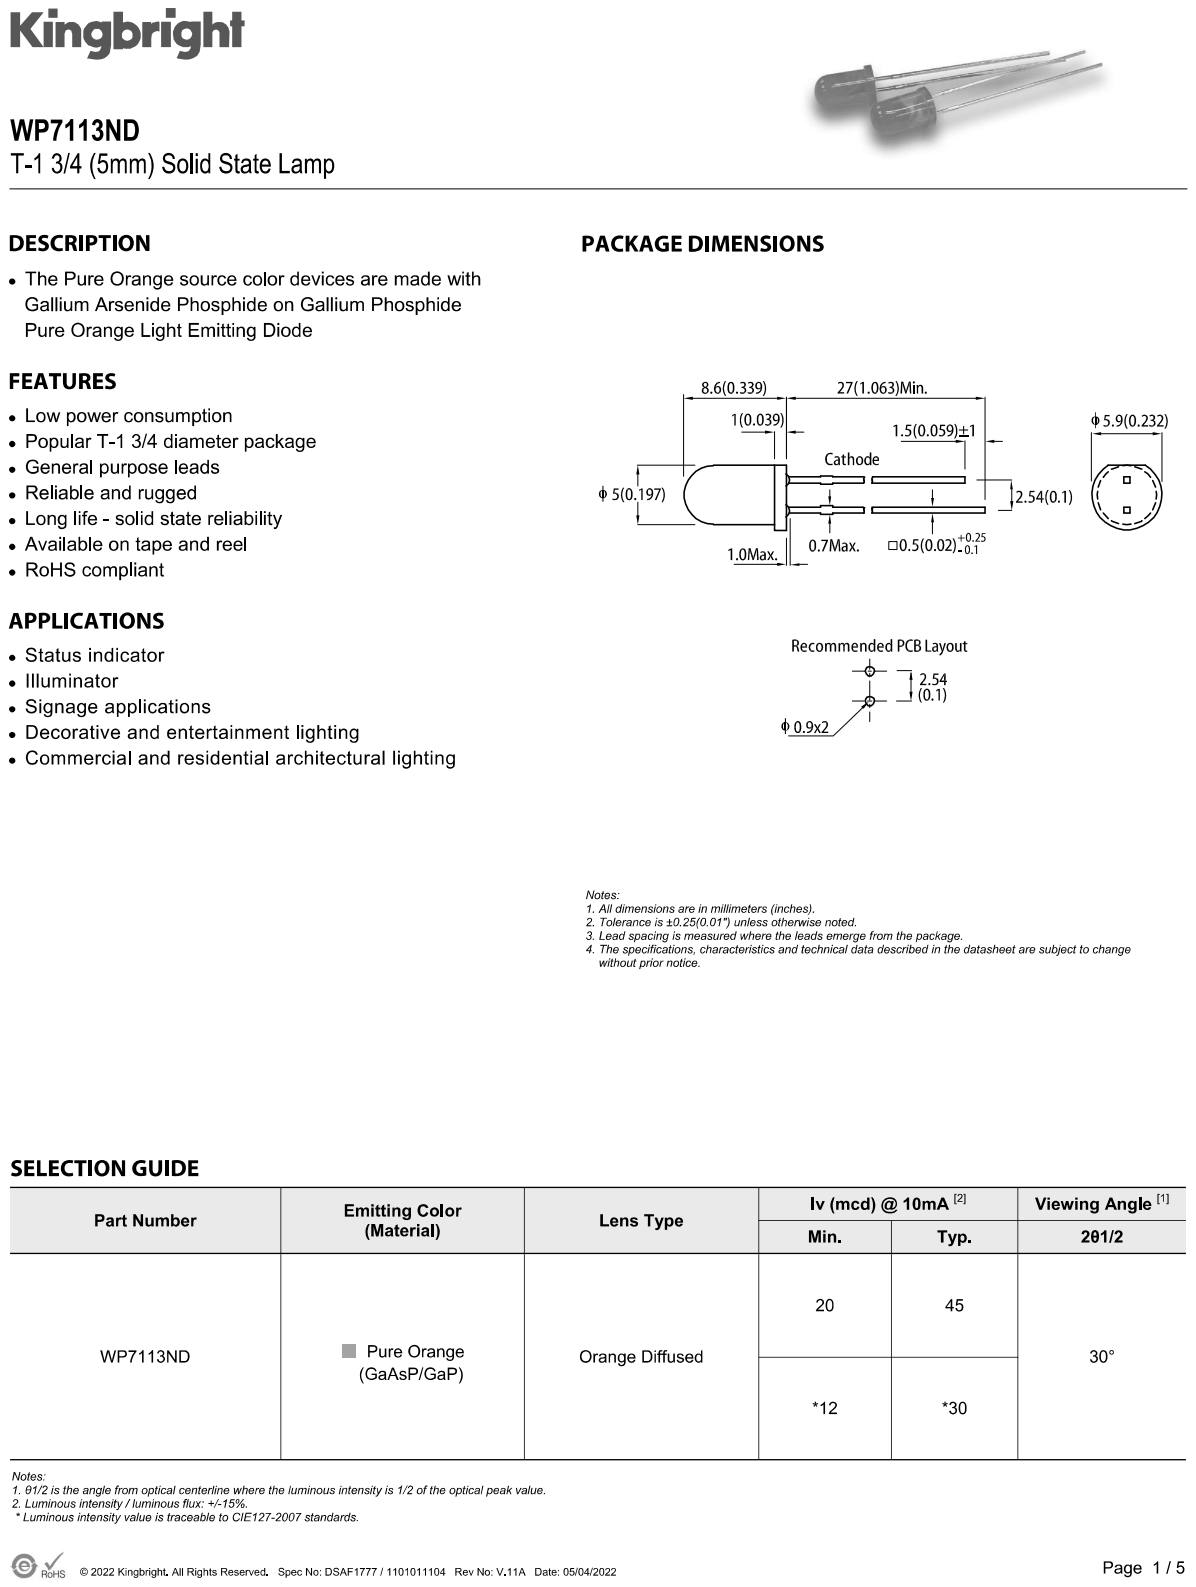
[picture p149: page 1]

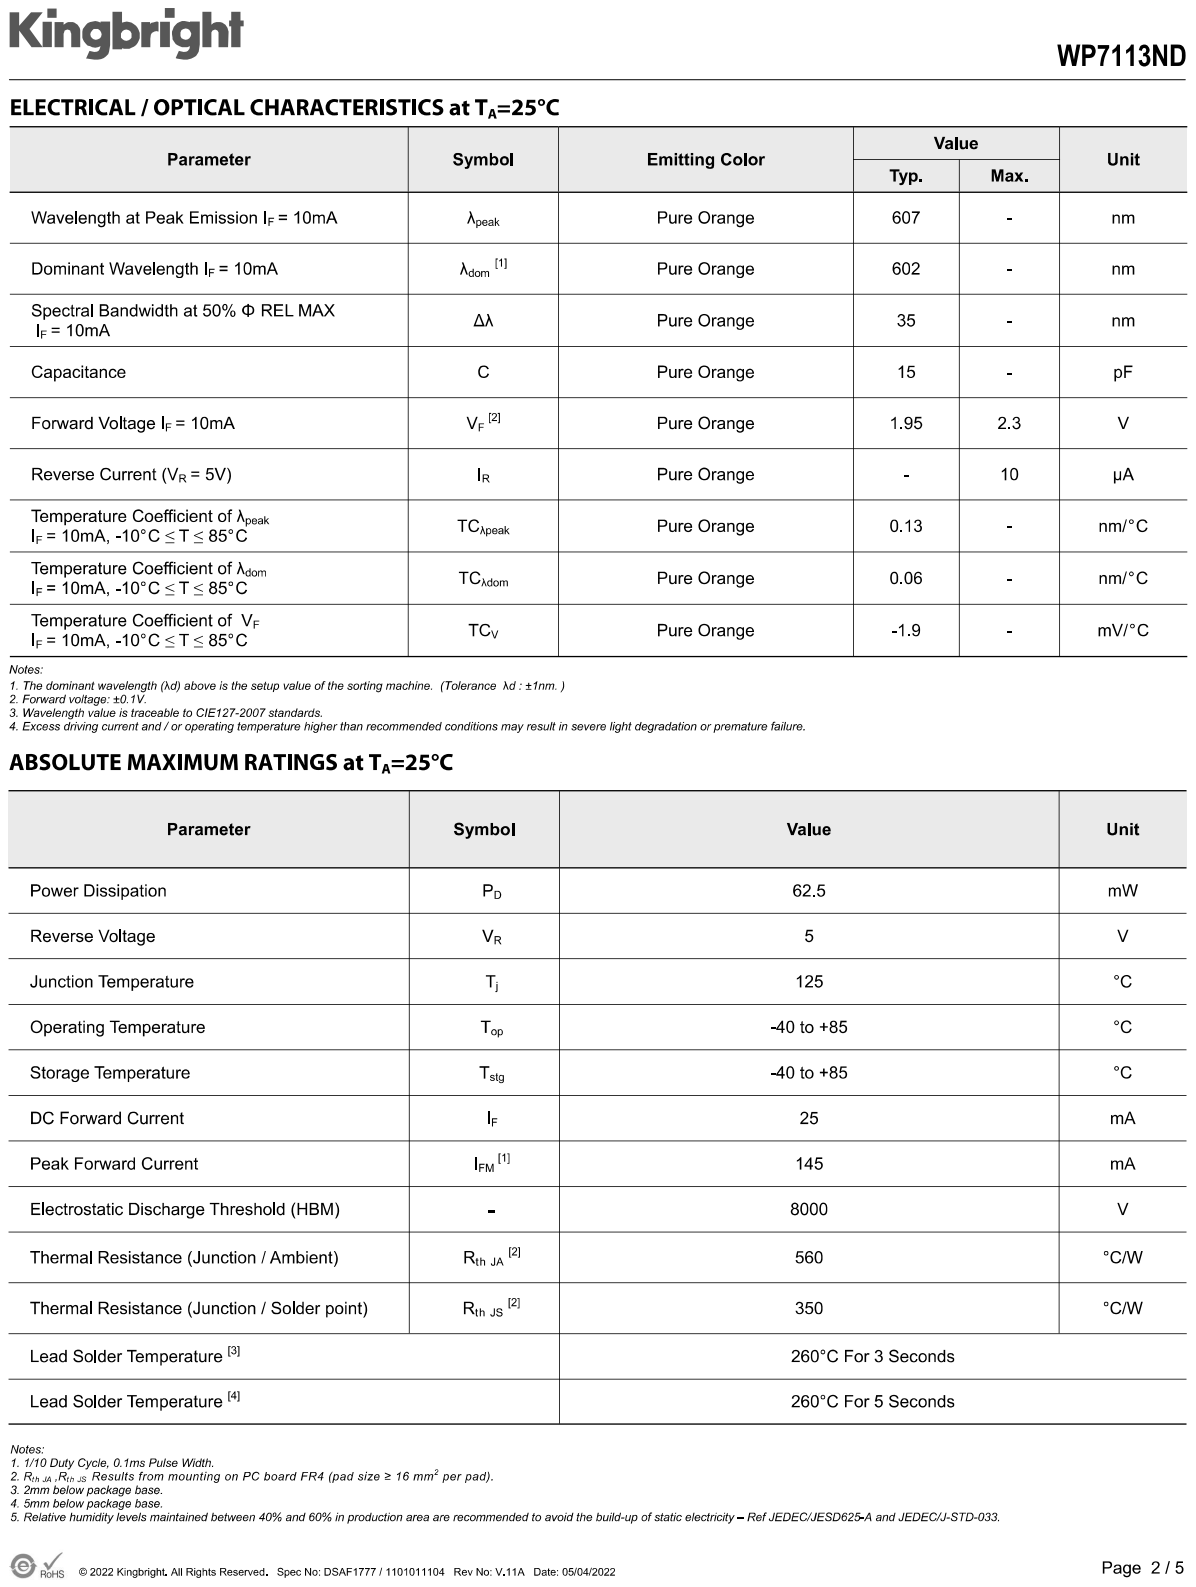
[picture p150: page 2]
