ETML-ES-SLO/PRJ_1811_Ticketing-/doc/1811_C/PDF/Nouveau dossier/LED rouge (SLAVE).pdf

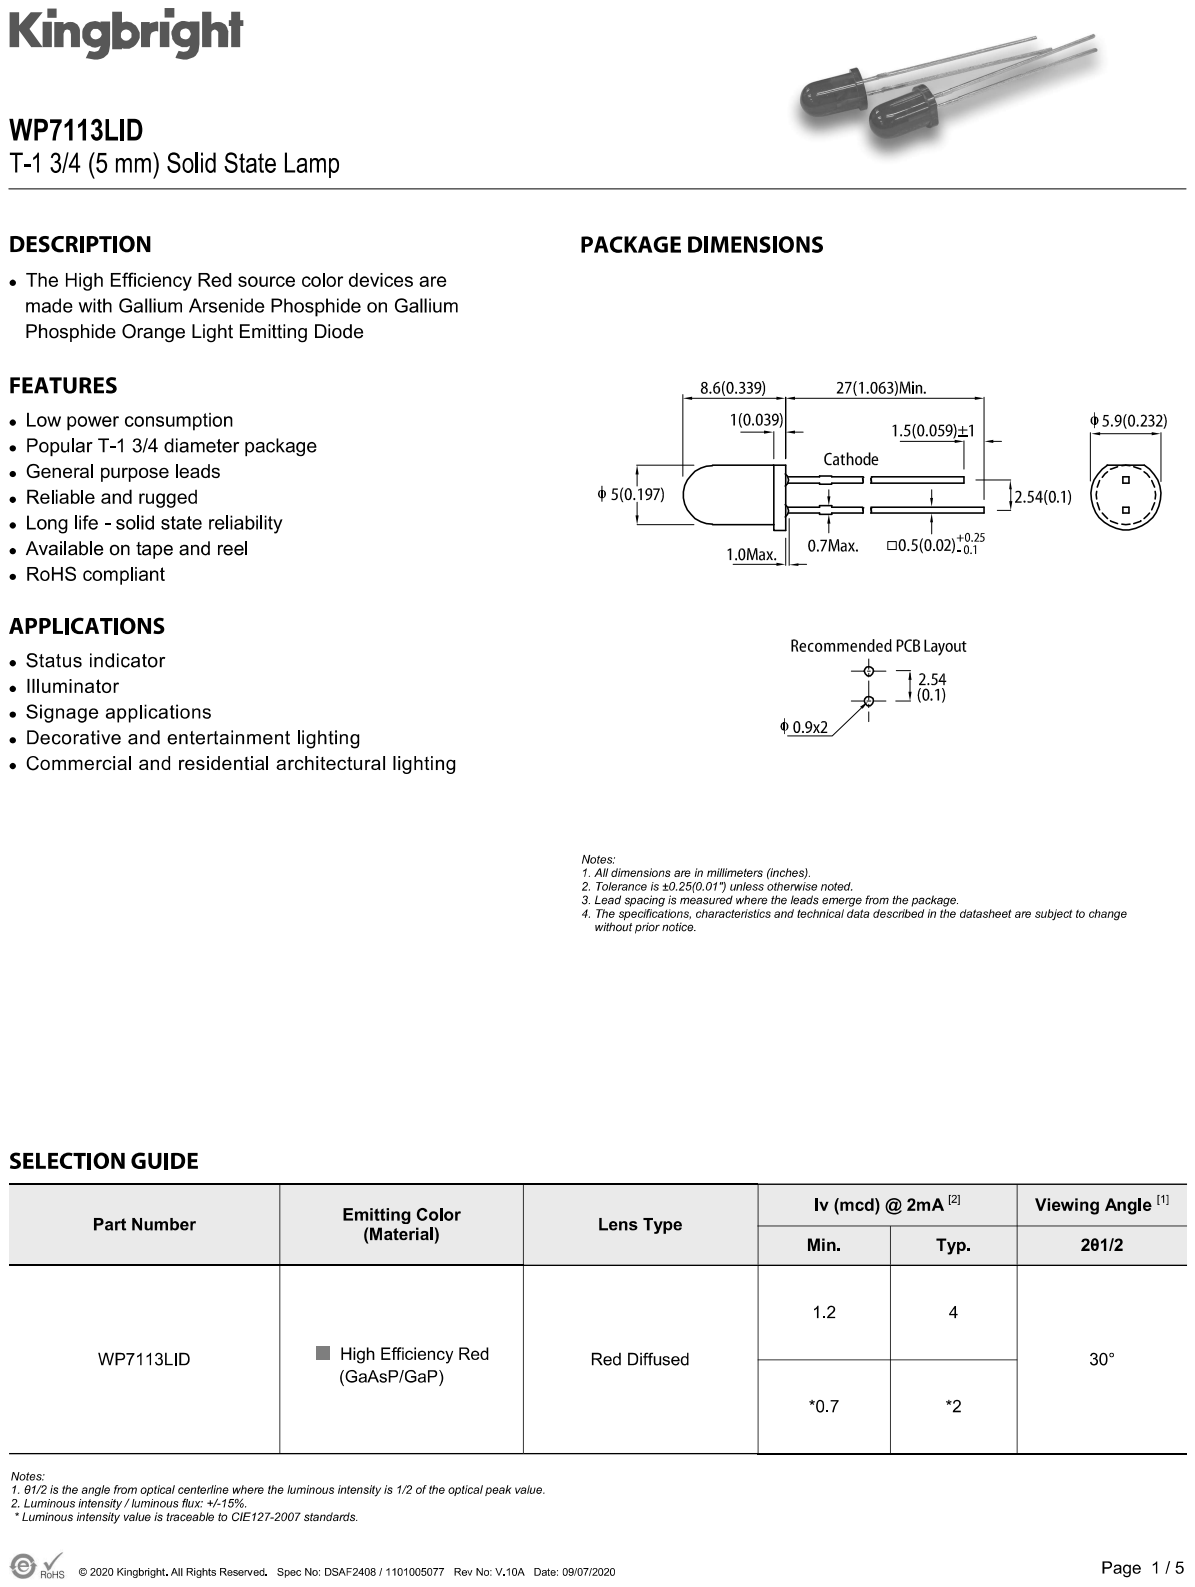
[picture p151: page 1]

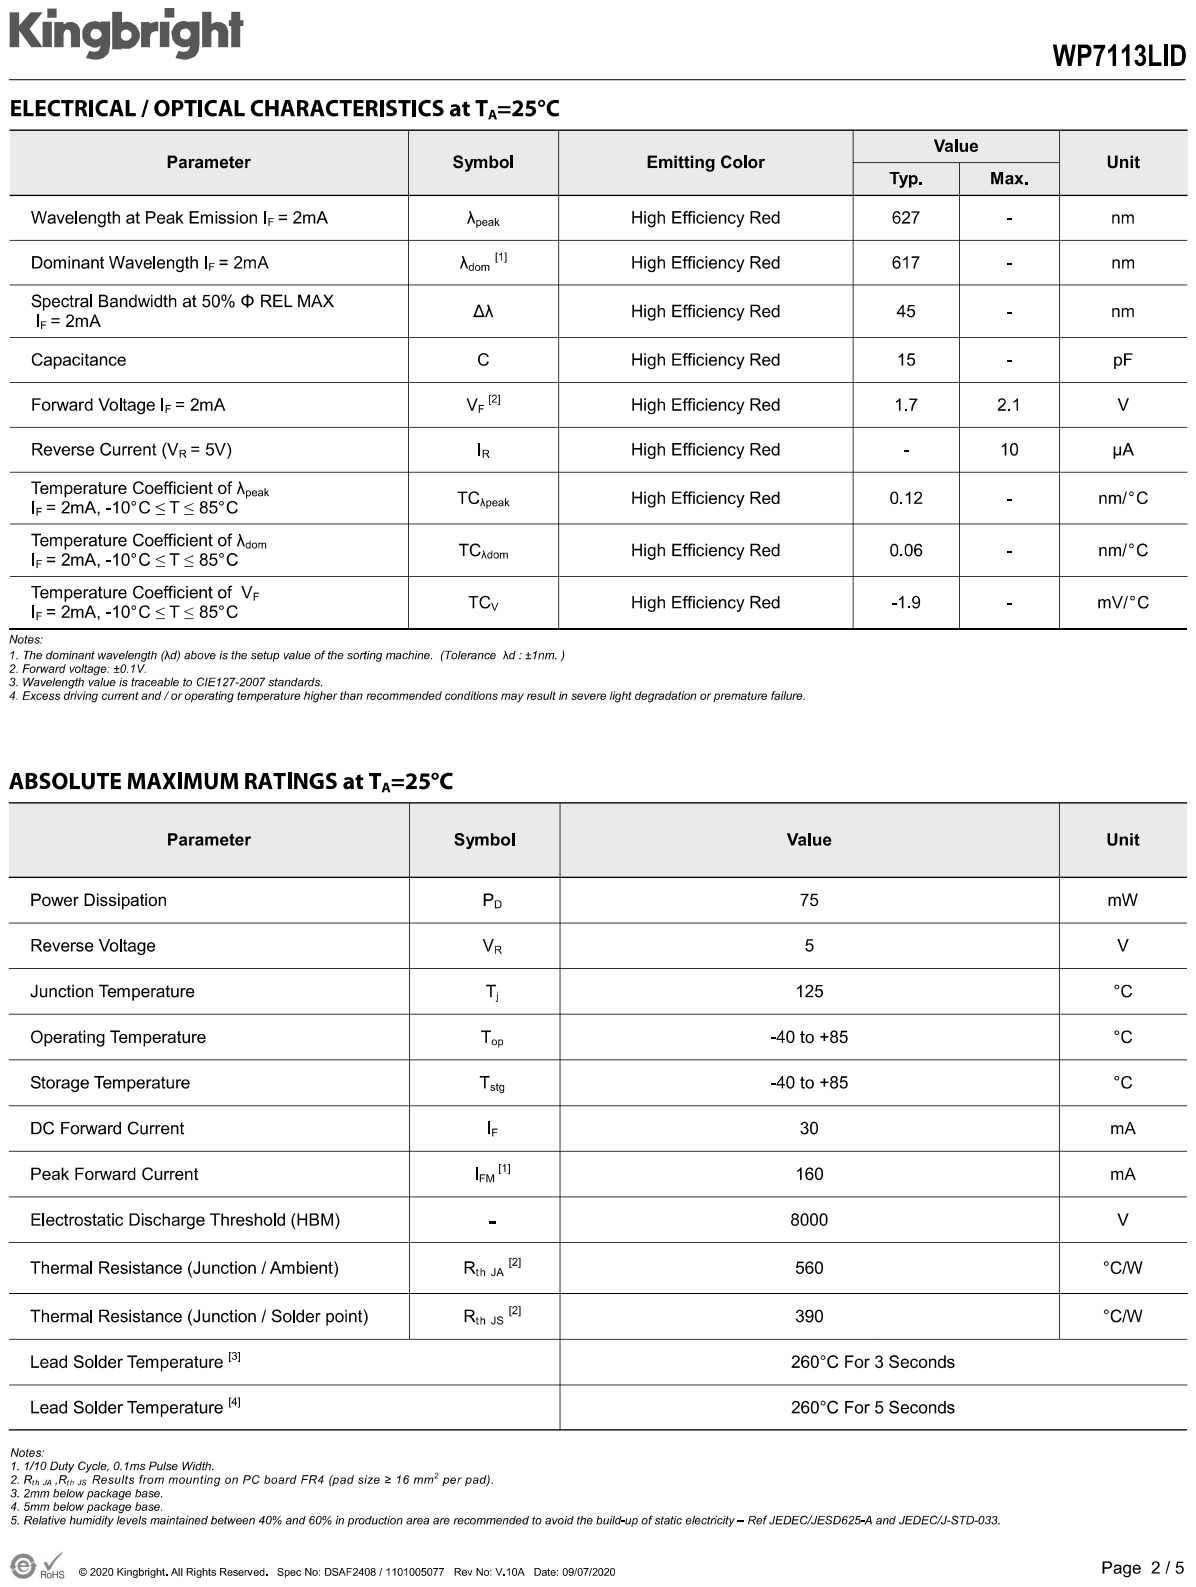
[picture p152: page 2]
