ETML-ES-SLO/PRJ_1811_Ticketing-/doc/1811_C/PDF/Nouveau dossier/LED verte (SLAVE).pdf

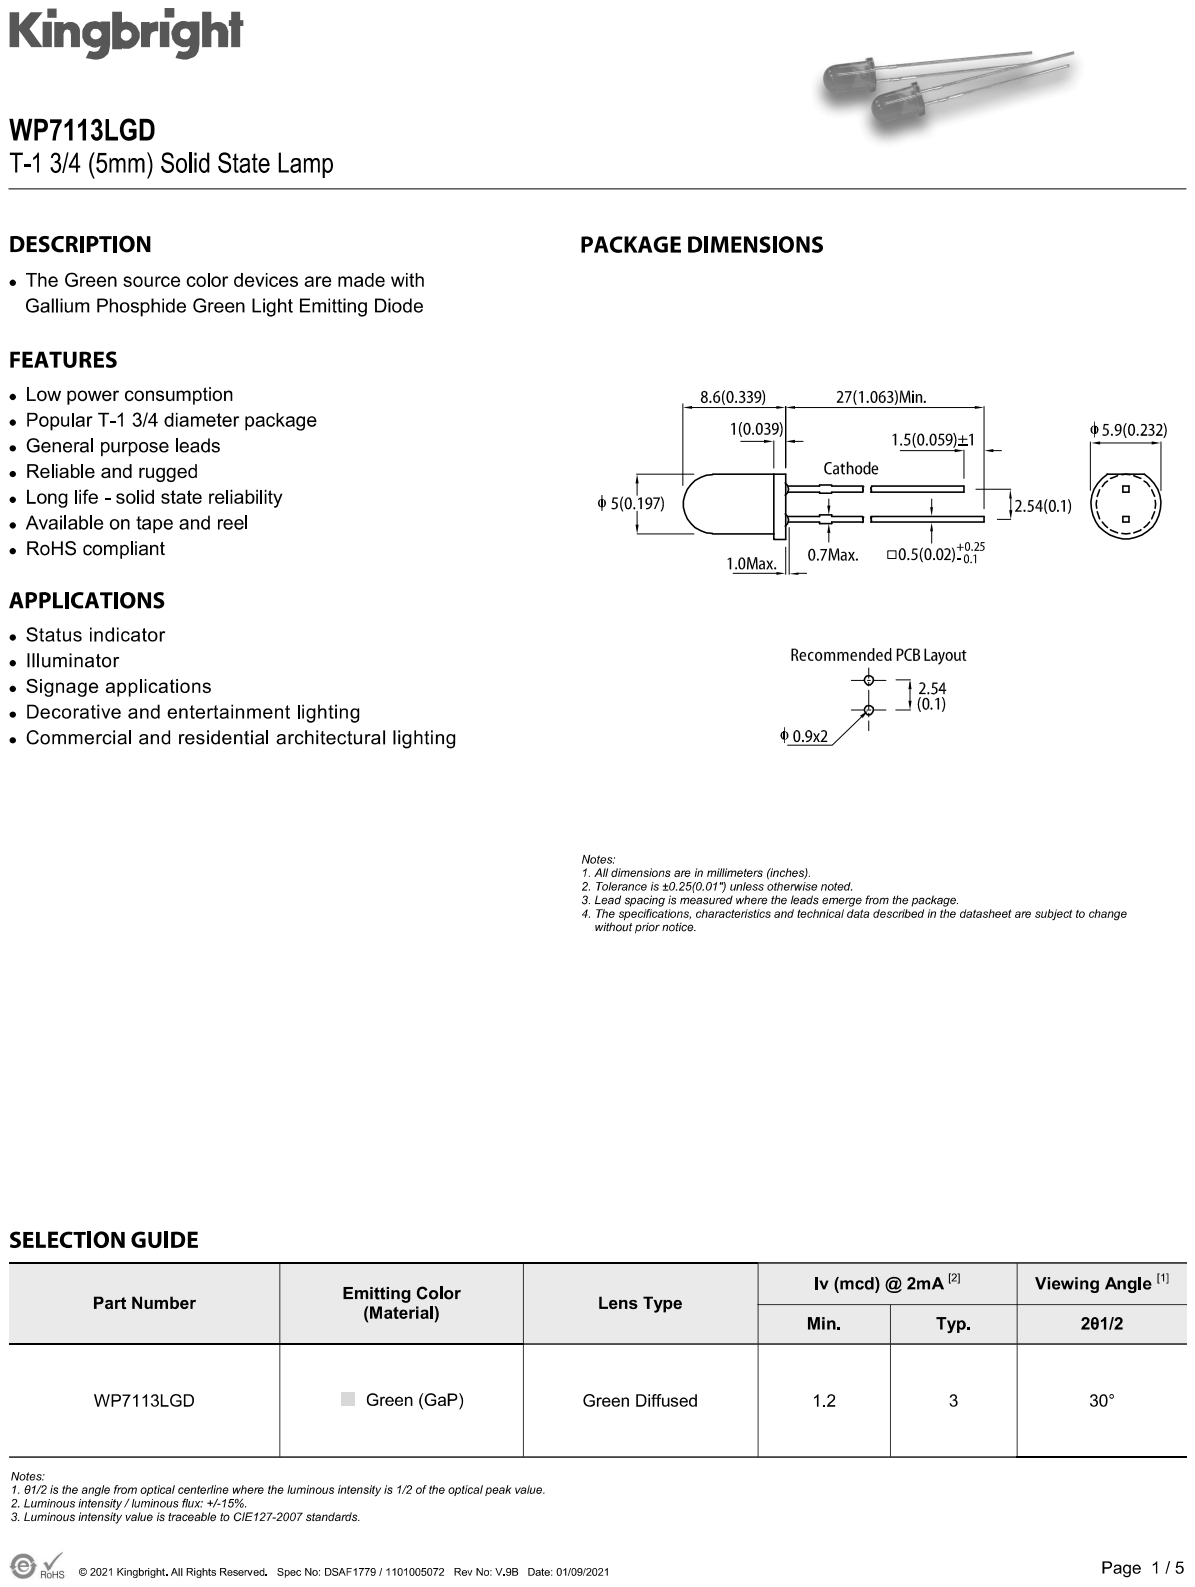
[picture p153: page 1]

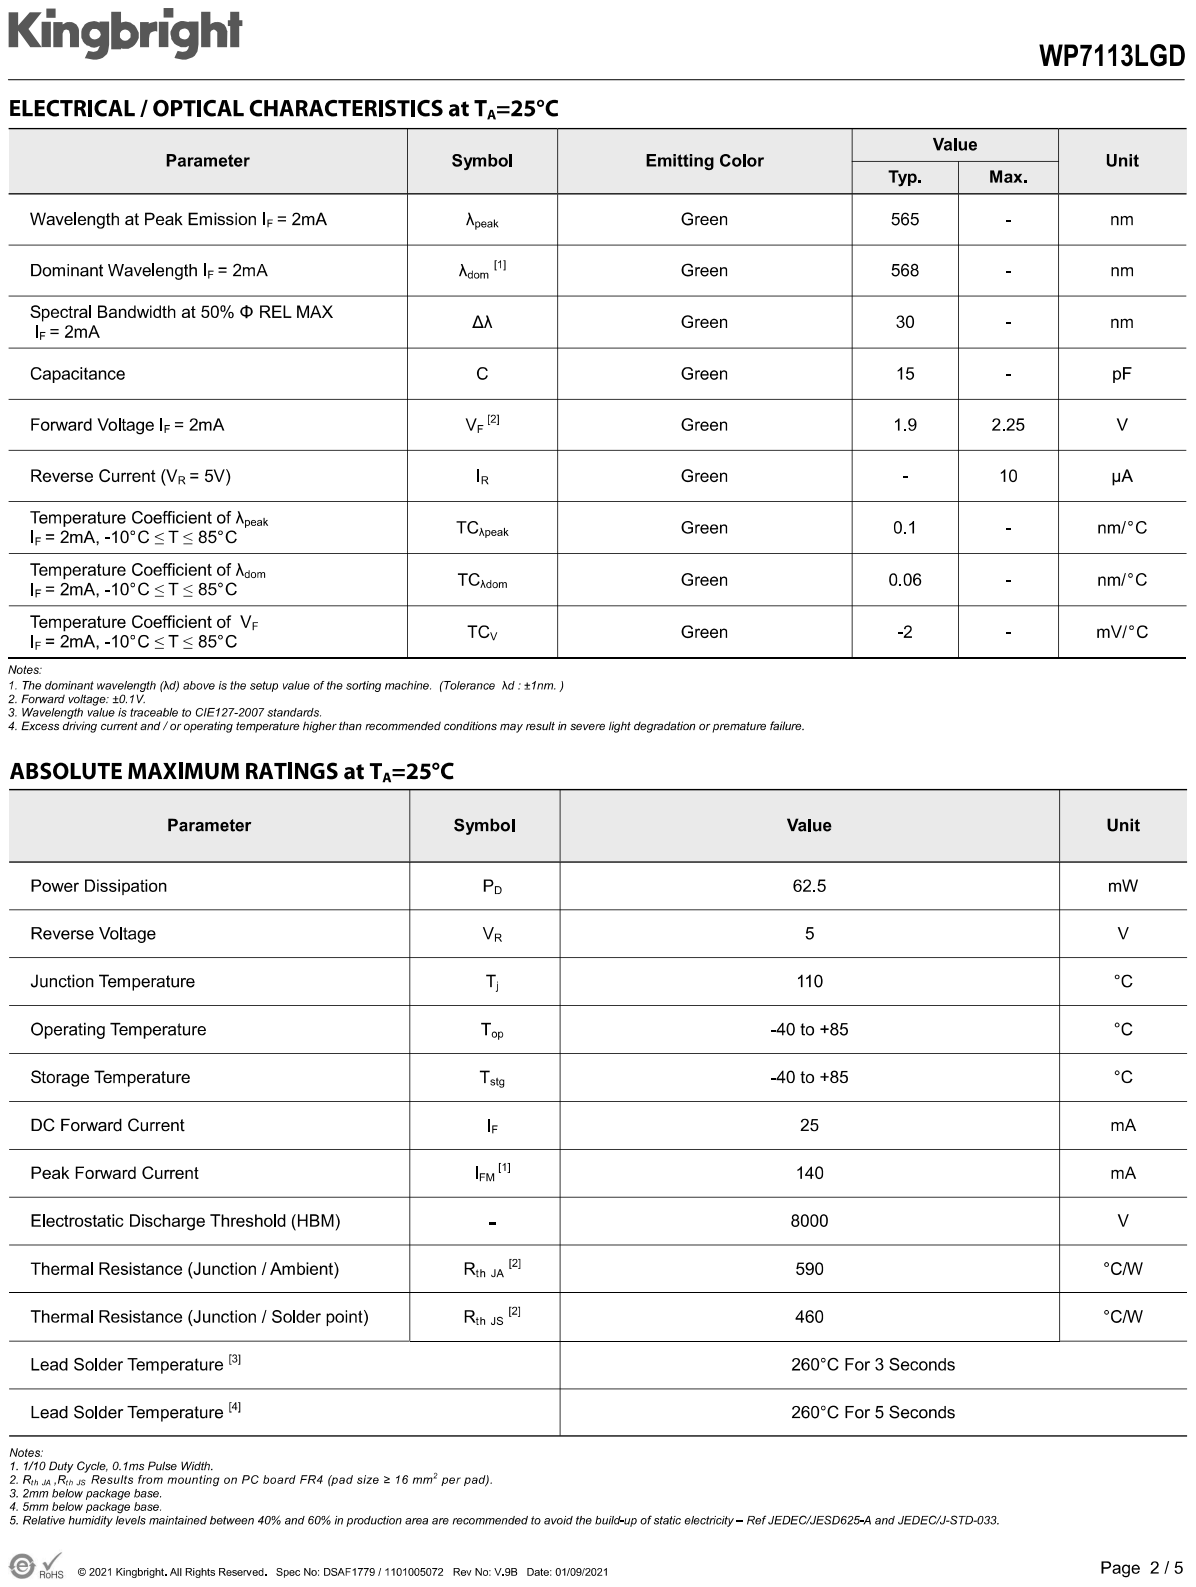
[picture p154: page 2]
