ETML-ES-SLO/PRJ_1811_Ticketing-/doc/1811_C/PDF/Nouveau dossier/PIC32MX1XX_2XX.pdf

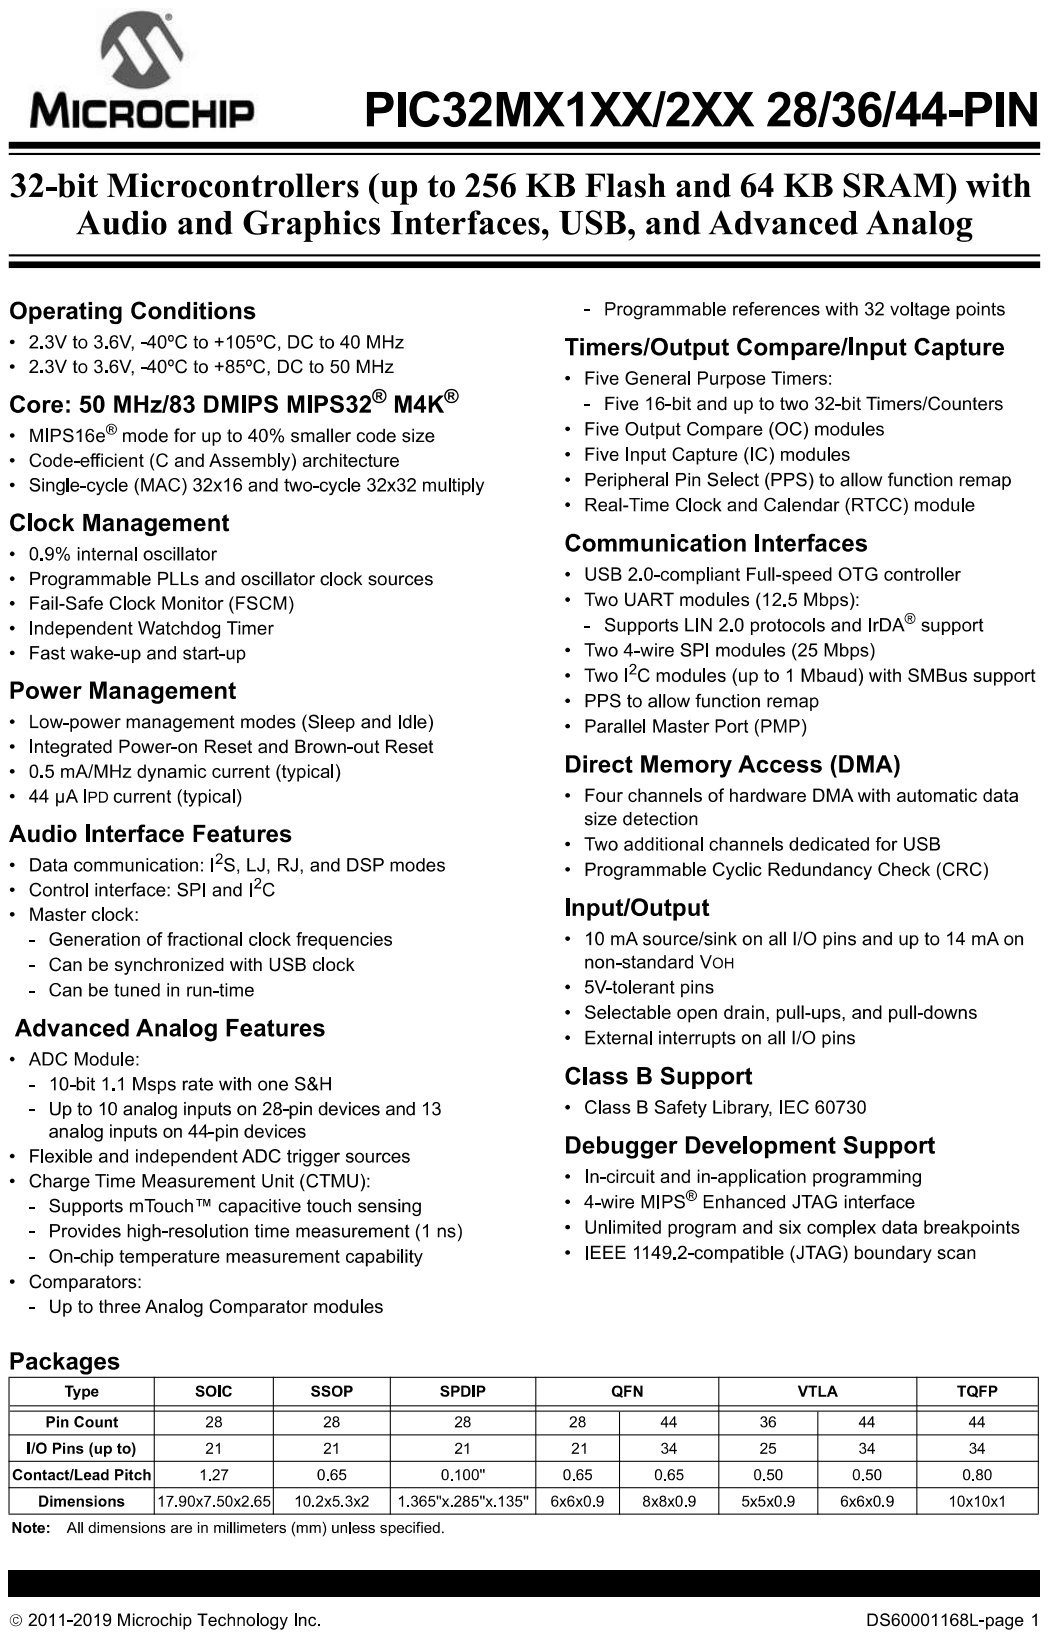
[picture p155: page 1]

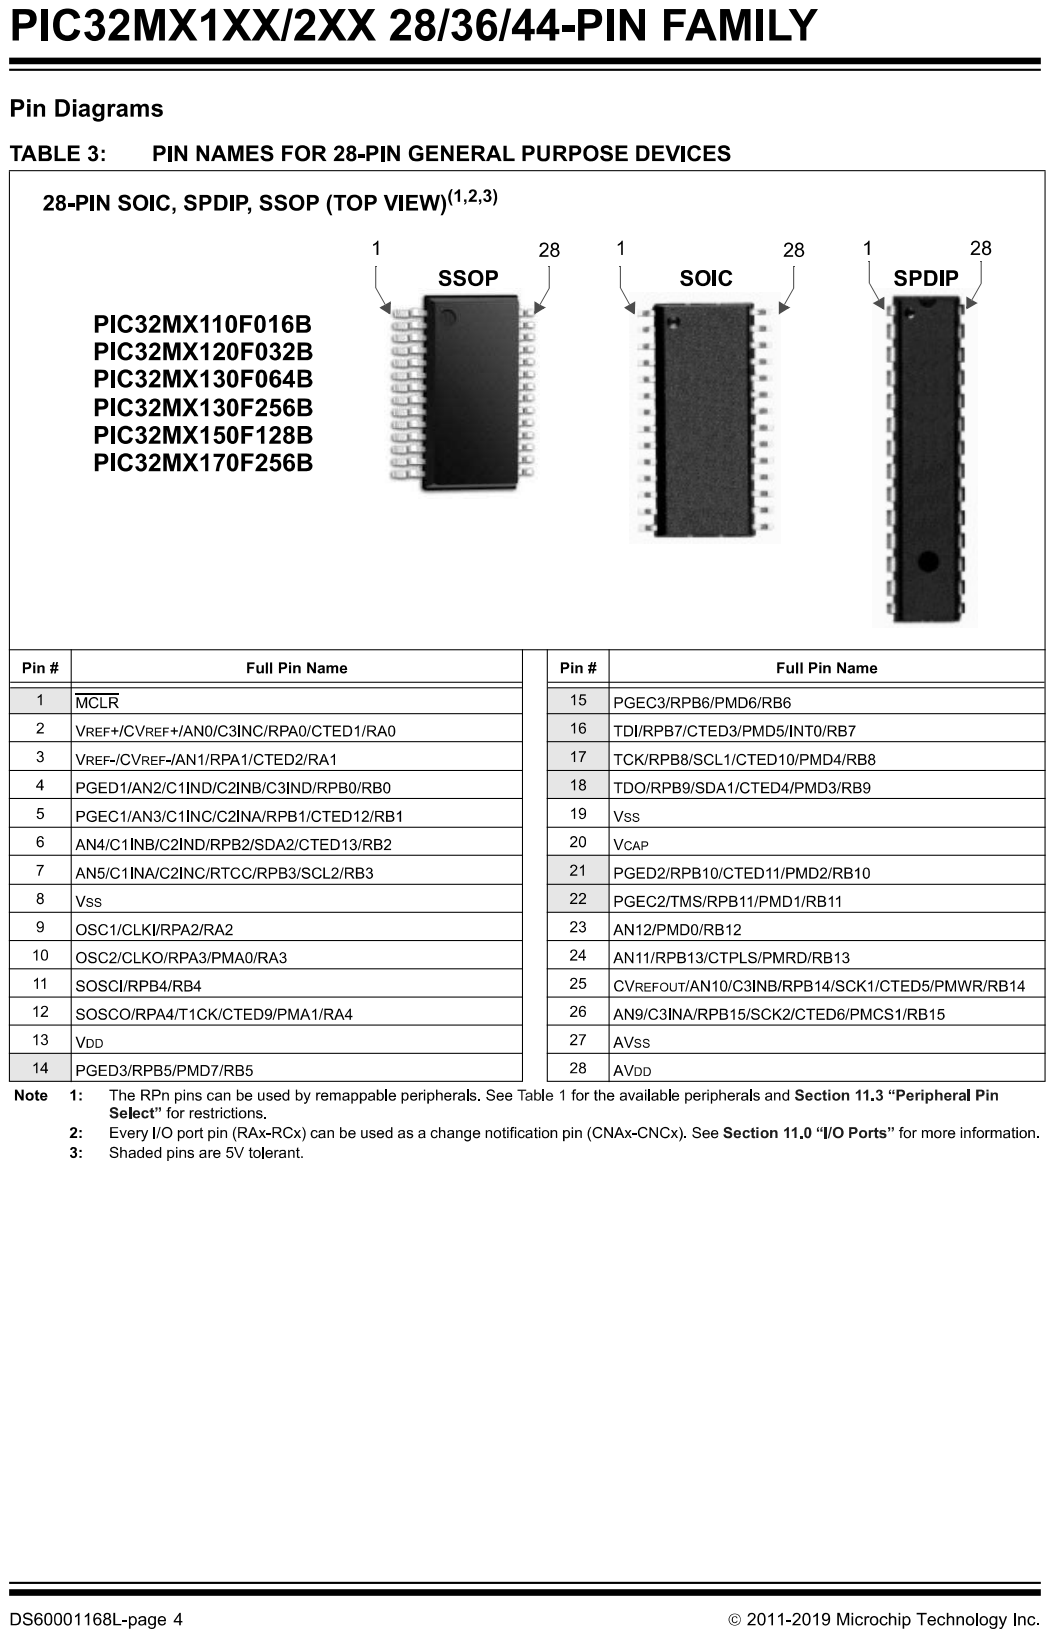
[picture p156: page 2]

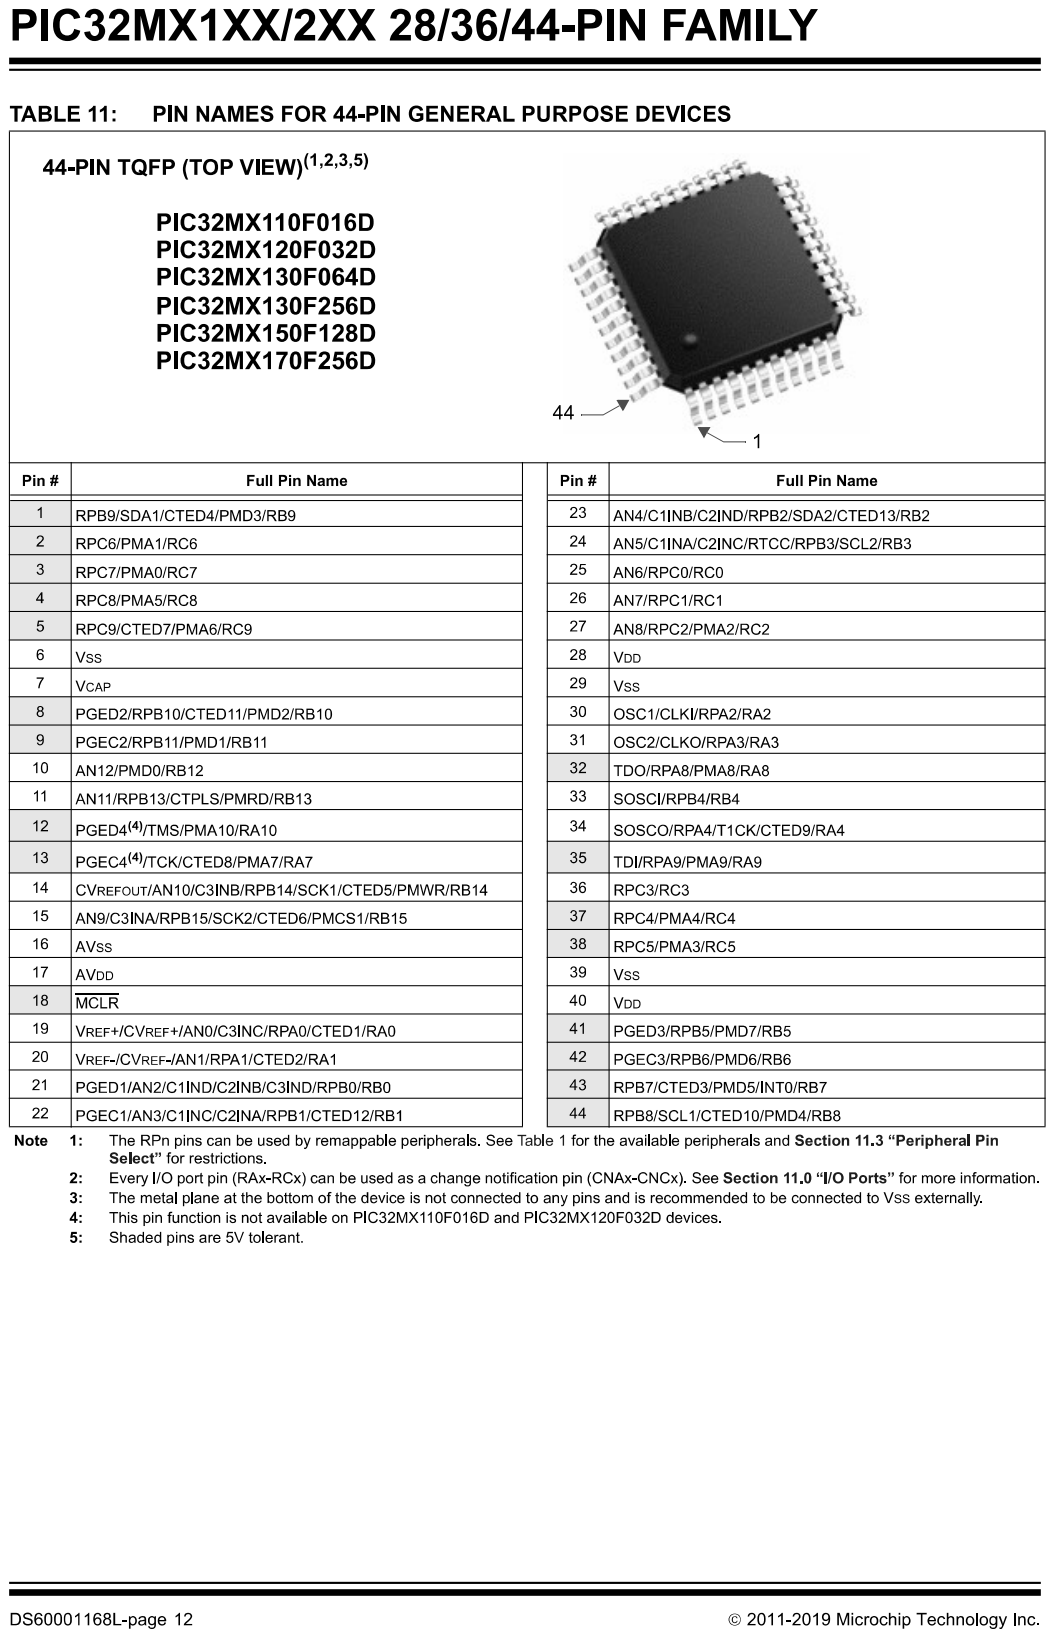
[picture p157: page 3]

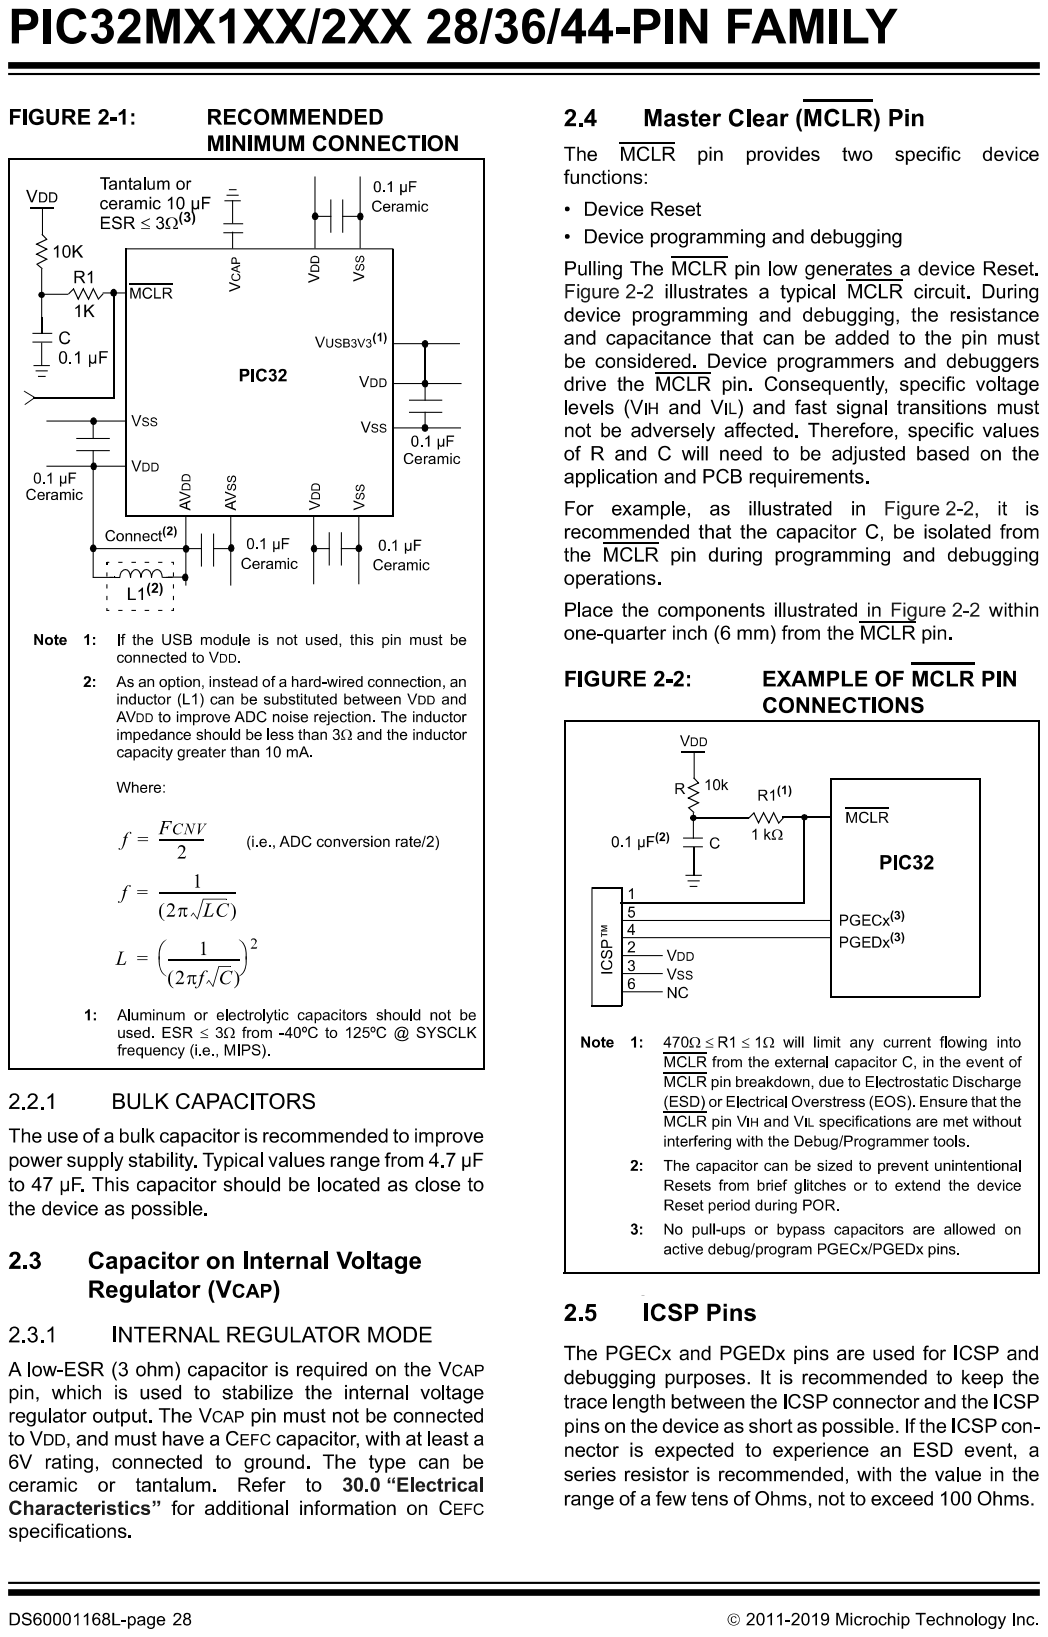
[picture p158: page 4]

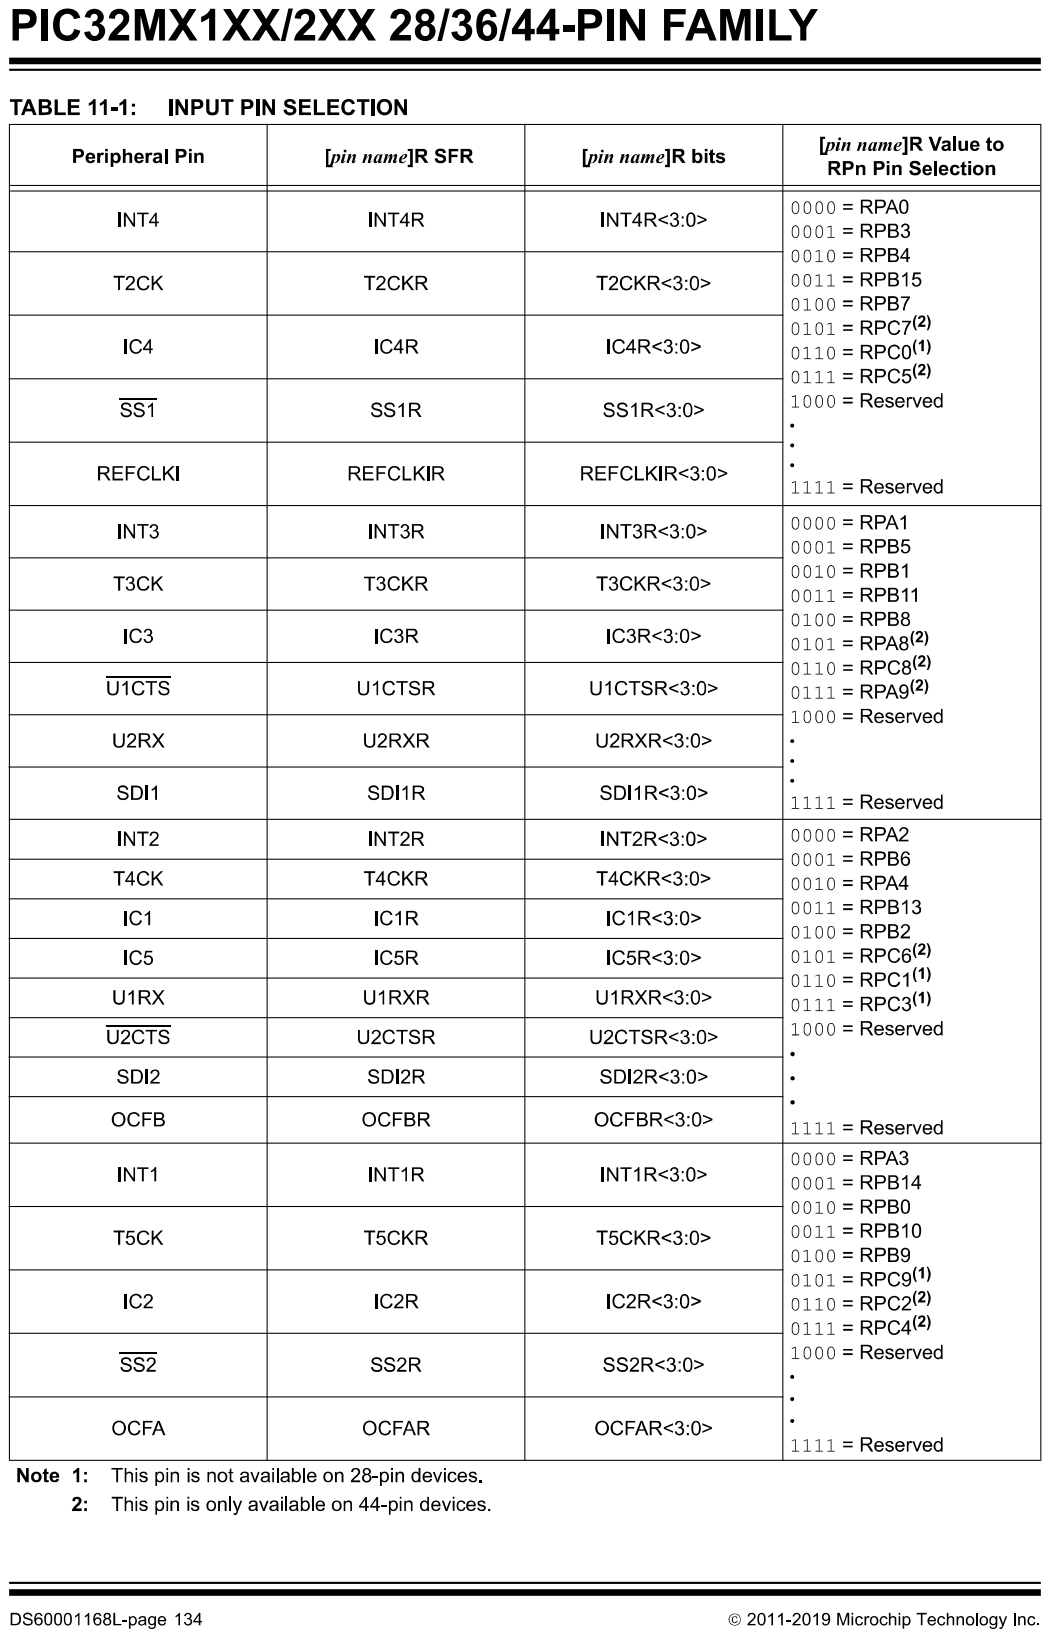
[picture p159: page 5]

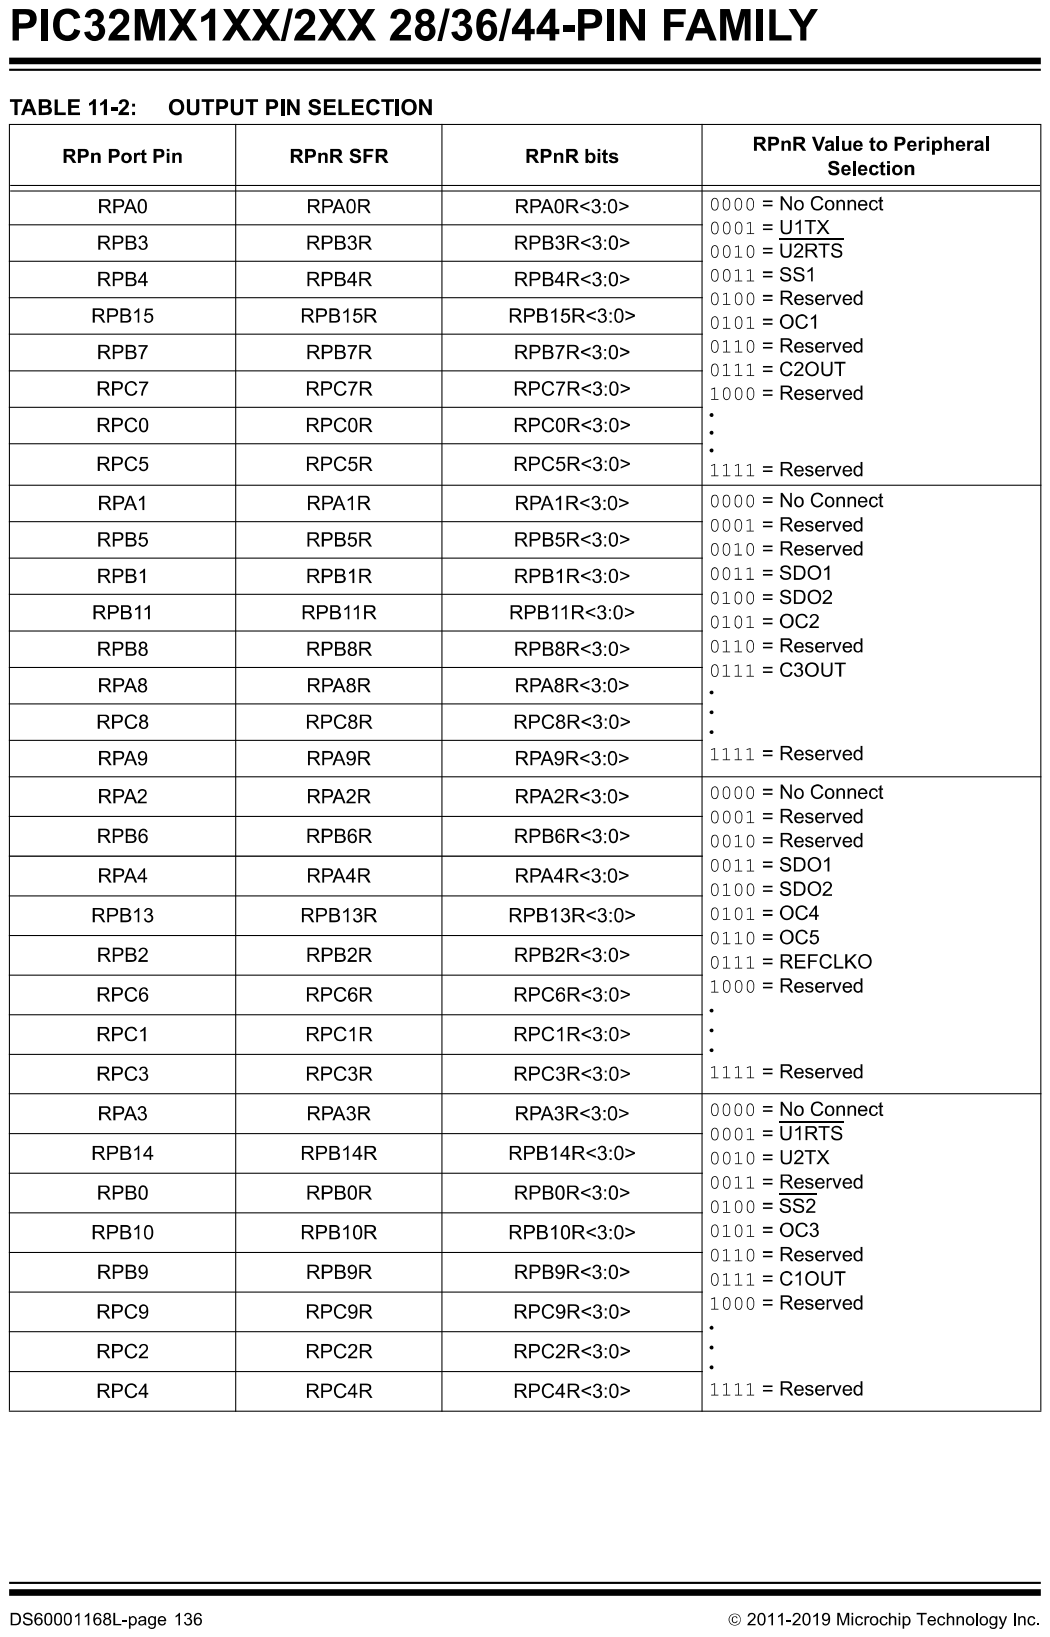
[picture p160: page 6]

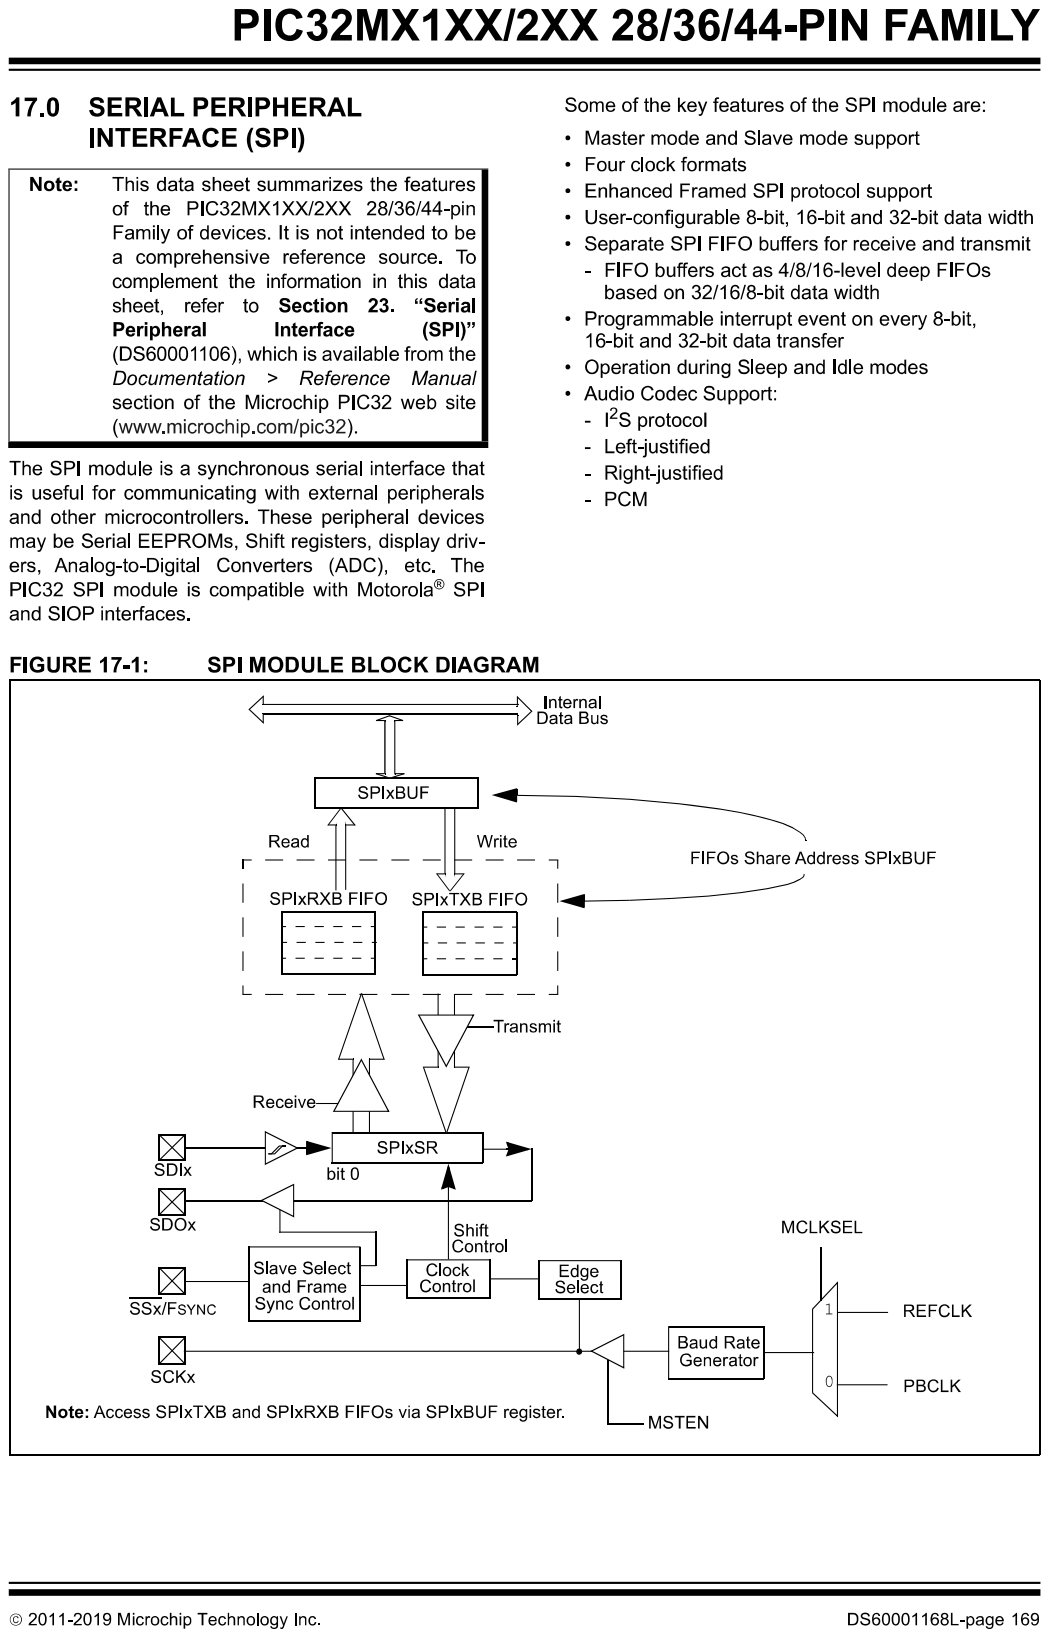
[picture p161: page 7]

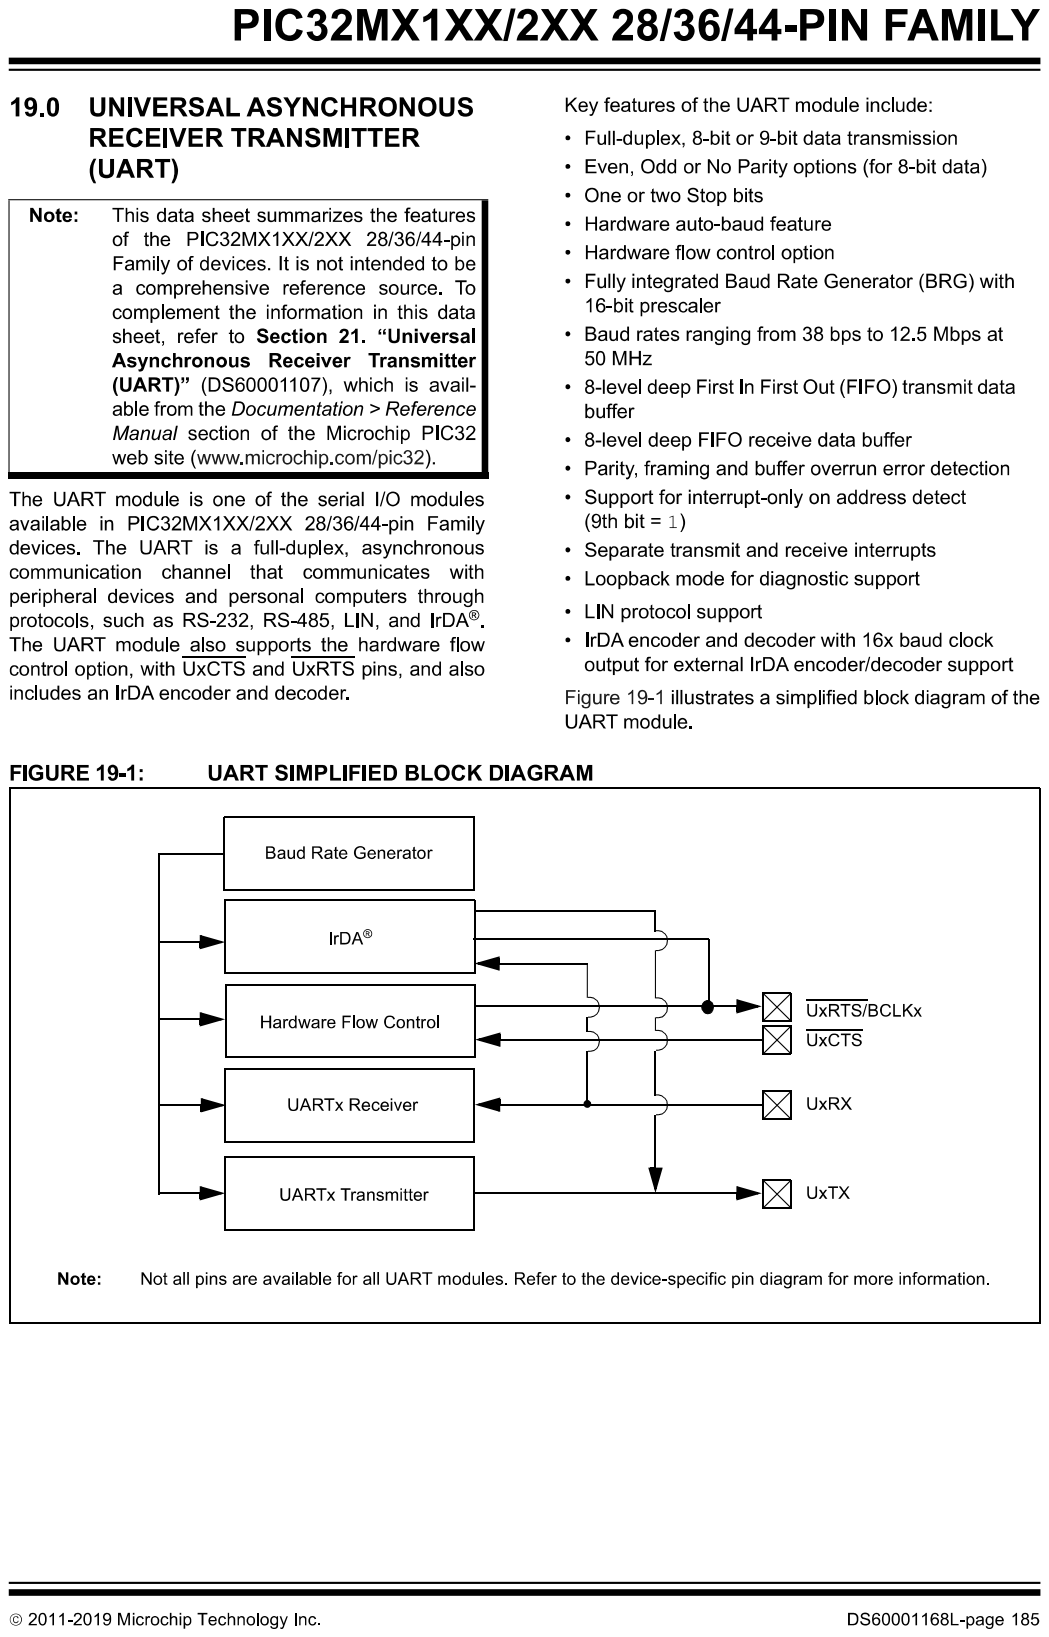
[picture p162: page 8]
