ETML-ES-SLO/PRJ_1811_Ticketing-/(list of files, drawings)

Other design files:
doc/1811A/Reférences/1623x_ModulesRxTx868MHz/hard/A/schéma et routage A/MODULE_RADIO_868M.DSN
doc/1811A/Reférences/1623x_ModulesRxTx868MHz/hard/A/schéma et routage A/module_radio_868M.opj
doc/1811A/Reférences/1623x_ModulesRxTx868MHz/hard/B/schéma et routage B/MODULE_RADIO_868M.DSN
doc/1811A/Reférences/1623x_ModulesRxTx868MHz/hard/B/schéma et routage B/module_radio_868M.opj
doc/1811C/Reférences/1623x_ModulesRxTx868MHz/hard/A/schéma et routage A/MODULE_RADIO_868M.DSN
doc/1811C/Reférences/1623x_ModulesRxTx868MHz/hard/A/schéma et routage A/module_radio_868M.opj
doc/1811C/Reférences/1623x_ModulesRxTx868MHz/hard/B/schéma et routage B/MODULE_RADIO_868M.DSN
doc/1811C/Reférences/1623x_ModulesRxTx868MHz/hard/B/schéma et routage B/module_radio_868M.opj
hard/1811A/1811A_Ticketing/18111A_Ticketing.PrjPcb
hard/1811A/1811A_Ticketing/Alim_Ticketing_Master.SchDoc
hard/1811A/1811A_Ticketing/PCB_Ticketing_Master.PcbDoc
hard/1811A/1811A_Ticketing/PcbLib1.PcbLib
hard/1811A/1811A_Ticketing/PCC-0016-00441-1/Released/MCHP-TQFP-PT44_N.PcbLib
hard/1811A/1811A_Ticketing/RF_And_SD_Ticketing_Master.SchDoc
hard/1811A/1811A_Ticketing/Schlib1.SchLib
hard/1811A/1811A_Ticketing/SYM-0016-01668-1/Released/MCHP-PIC32MX2XXFXXXD-TQFP-44.SchLib
hard/1811A/1811A_Ticketing/SYM-0016-01668-1/Released/PIC32MX170F256D.SchLib
hard/1811A/1811A_Ticketing/TFT_Ticketing_Master.SchDoc
hard/1811A/1811A_Ticketing/Ticketing_Master.SchDoc
hard/1811A/1811A_Ticketing/Uc_Ticketing_Master.SchDoc
hard/1811A/1811A_Ticketing/UI_Ticketing_Master.SchDoc
hard/1811A/1812A_Ticketing/1812A_Ticketing.PrjPcb
hard/1811A/1812A_Ticketing/18112A_Ticketing.PrjPcb
hard/1811A/1812A_Ticketing/Alim_Ticketing_Slave.SchDoc
hard/1811A/1812A_Ticketing/PCB_Ticketing_Slave.PcbDoc
hard/1811A/1812A_Ticketing/RF_Ticketing_Slave.SchDoc
hard/1811A/1812A_Ticketing/Ticketing_Slave.SchDoc
hard/1811A/1812A_Ticketing/Uc_Ticketing_Slave.SchDoc
hard/1811A/1812A_Ticketing/UI_Ticketing_Slave.SchDoc
hard/1811C/18111C Ticketing/18111C Ticketing.PrjPcb
hard/1811C/18111C Ticketing/Alim_Ticketing_Master.SchDoc
hard/1811C/18111C Ticketing/PCB_Ticketing_Master.PcbDoc
hard/1811C/18111C Ticketing/PCB_Ticketing_Master.PcbLib
hard/1811C/18111C Ticketing/PCB_Ticketing_Master.SchLib
hard/1811C/18111C Ticketing/RF_And_SD_Ticketing_Master.SchDoc
hard/1811C/18111C Ticketing/TFT_Ticketing_Master.SchDoc
hard/1811C/18111C Ticketing/Ticketing_Master.SchDoc
hard/1811C/18111C Ticketing/Uc_Ticketing_Master.SchDoc
hard/1811C/18111C Ticketing/UI_Ticketing_Master.SchDoc
hard/1811C/18111C Ticketing_old/18111C Ticketing.PrjPcb
hard/1811C/18111C Ticketing_old/Alim_Ticketing_Master.SchDoc
hard/1811C/18111C Ticketing_old/PCB_Ticketing_Master.PcbDoc
hard/1811C/18111C Ticketing_old/PCB_Ticketing_Master.PcbLib
hard/1811C/18111C Ticketing_old/PCB_Ticketing_Master.SchLib
hard/1811C/18111C Ticketing_old/RF_And_SD_Ticketing_Master.SchDoc
hard/1811C/18111C Ticketing_old/TFT_Ticketing_Master.SchDoc
hard/1811C/18111C Ticketing_old/Ticketing_Master.SchDoc
hard/1811C/18111C Ticketing_old/Uc_Ticketing_Master.SchDoc
hard/1811C/18111C Ticketing_old/UI_Ticketing_Master.SchDoc
hard/1811C/18112C_Ticketing_old/18112C_Ticketing.PrjPcb
hard/1811C/18112C_Ticketing_old/Alim_Ticketing_Slave.SchDoc
hard/1811C/18112C_Ticketing_old/PCB_Ticketing_Slave.PcbDoc
hard/1811C/18112C_Ticketing_old/PCB_Ticketing_Slave.PcbLib
hard/1811C/18112C_Ticketing_old/PCB_Ticketing_Slave.SCHLIB
hard/1811C/18112C_Ticketing_old/RF_Ticketing_Slave.SchDoc
hard/1811C/18112C_Ticketing_old/Ticketing_Slave.SchDoc
hard/1811C/18112C_Ticketing_old/Uc_Ticketing_Slave.SchDoc
hard/1811C/18112C_Ticketing_old/UI_Ticketing_Slave.SchDoc
hard/1811C/18112C_Ticketing_QFN/18112C_Ticketing.PrjPcb
hard/1811C/18112C_Ticketing_QFN/Alim_Ticketing_Slave.SchDoc
hard/1811C/18112C_Ticketing_QFN/PCB_Ticketing_Slave.PcbLib
hard/1811C/18112C_Ticketing_QFN/PCB_Ticketing_Slave.SCHLIB
hard/1811C/18112C_Ticketing_QFN/PCB_Ticketing_Slave_QFN.PcbDoc
hard/1811C/18112C_Ticketing_QFN/RF_Ticketing_Slave.SchDoc
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
