ETML-ES-SLO/PRJ_1811_Ticketing-/soft/1811_A_B/1811_Master/firmware/src/Data_Code.h

/* ************************************************************************** */
/** Descriptive File Name

  @Company
    Company Name

  @File Name
    filename.h

  @Summary
    Brief description of the file.

  @Description
    Describe the purpose of this file.
*/
/*****************************************************************************/

#ifndef _DATA_CODE_H    /* Guard against multiple inclusion */
#define _DATA_CODE_H

#define ENVOI_TICKET 0x917283bd 
#define TICKET_ANNULER 0xccc18ca5

#define TICKET_ACCEPT 0x00e0d135
#define TICKET_REFUSE 0xc5fb3140 
#define TICKET_RESET  0xb0bfe0fc 
#define BLOCKED 0xcc9ebb17 

#define ARE_U_LINK 0x3103de90 
#define I_AM_LINK 0xcdd05a45 

#define ACK 0x1b1ac4f6  

#define ADD_MASTER 0x580a1752


    /* Provide C++ Compatibility */
#ifdef __cplusplus
}
#endif

#endif /* _EXAMPLE_FILE_NAME_H */

/* *****************************************************************************
 End of File
 */
