ETML-ES-SLO/PRJ_1811_Ticketing-/soft/1811_C/18111C_Master/firmware/src/RF.h

//--------------------------------------------------------
// RF.h
//--------------------------------------------------------
// Gestion communication	
//
//	Auteur 		: 	SCA
//  Date        :   5.12.2019
//	Version		:	V1.0
//	Compilateur	:	XC32 V2.15
//  Modifications :
//   -
/*--------------------------------------------------------*/

#ifndef _RF_H    /* Guard against multiple inclusion */
#define _RF_H

#include <stdint.h>
#include <stdbool.h>

/* ************************************************************************** */


/* ************************************************************************** */
extern bool Get_Add_Master;


/* ************************************************************************** */

void RF_Init(void);
void RF_SendMessage(uint8_t* dataToSend, uint8_t nbBytesToSend);

#endif /* _RF_H */

/* *****************************************************************************
 End of File
 */
