ETML-ES-SLO/PRJ_1811_Ticketing-/(commit log)

2025-01-31 MAJ Repo PRJ 1811 - 31.01.2025
    [1010588752.sldasm, 1010588888.sldasm, 1010589024.sldasm, 1010589160.sldasm, 1010589296.sldasm, 1010589432.sldasm, 1010589704.sldasm, 1010590112.sldasm]
2025-05-12 MAJ dossier PRJ 1811 -> update gitignore
    [1010588752.sldasm, 1010588888.sldasm, 1010589024.sldasm, 1010589160.sldasm, 1010589296.sldasm, 1010589432.sldasm, 1010589704.sldasm, 1010590112.sldasm]
2025-06-23 MAJ 1811 - Ticketing - Version MBR
    [1010588752.sldasm, 1010588888.sldasm, 1010589024.sldasm, 1010589160.sldasm, 1010589296.sldasm, 1010589432.sldasm, 1010589704.sldasm, 1010590112.sldasm]
